gralco/cimarron/README.md

# Cimarron 3D Printer Electronics

## Chipset

Octavo Systems/TI OSD335x

## Other ICs Being Used

Trinamic TMC2130 Stepper Driver

EMMC**G-S100 Embedded MMC

## Operating System

Embedded ARM GNU/Linux Kamikaze

## Bootloader

DAS U-Boot

## Control Software

Potential software to run on Cimarron:

 - [Redeem](https://bitbucket.org/intelligentagent/redeem)
 - [MachineKit](https://github.com/machinekit/machinekit)
 - [Unicorn](https://github.com/fastbot3d/firmware)
 - [Ember-Firmware](https://github.com/spark3dp/ember-firmware)

## Credits

Works that Cimarron is based off of includes:

 - Thing Printer Replicape Rev B3
 - BeagleBone Black Wireless (minus the WL1835 chip)
 - PocketBone
 - BeagleBone Black
 - Tinkerforge Silent Stepper Brick
 - Trinamic TMC-260 Shield

## License

Cimarron is published under [CC-BY-SA 4.0](COPYING.md).
