gralco/cimarron/KiMBo/shapes3D/molex_4pin.fcstd

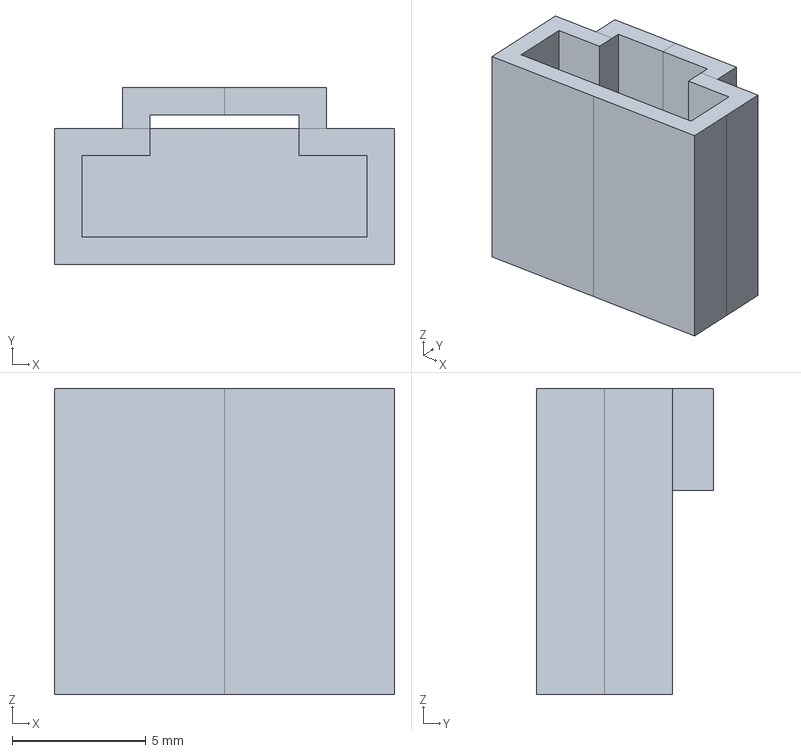
[picture p1: CAD file, 2016-11-03]
KiMBo/shapes3D/molex_4pin.fcstd
12.7 x 6.61 x 11.4 mm
