gralco/cimarron/KiMBo/shapes3D/euro_header_10_horiz.fcstd

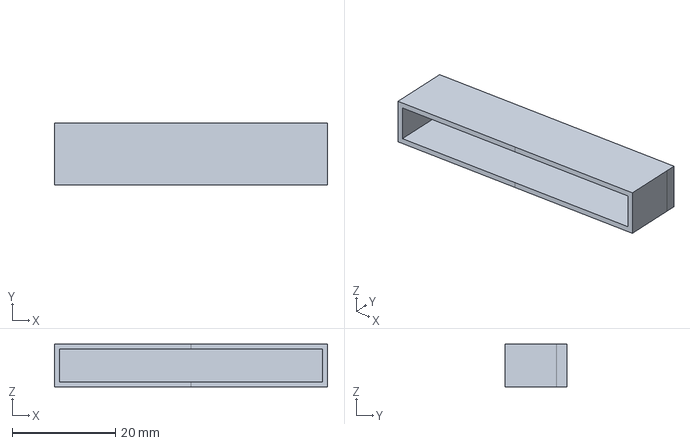
[picture p2: CAD file, 2016-11-03]
KiMBo/shapes3D/euro_header_10_horiz.fcstd
52.8 x 12.0 x 8.30 mm
