gralco/cimarron/KiMBo/shapes3D/switch_vertical.fcstd

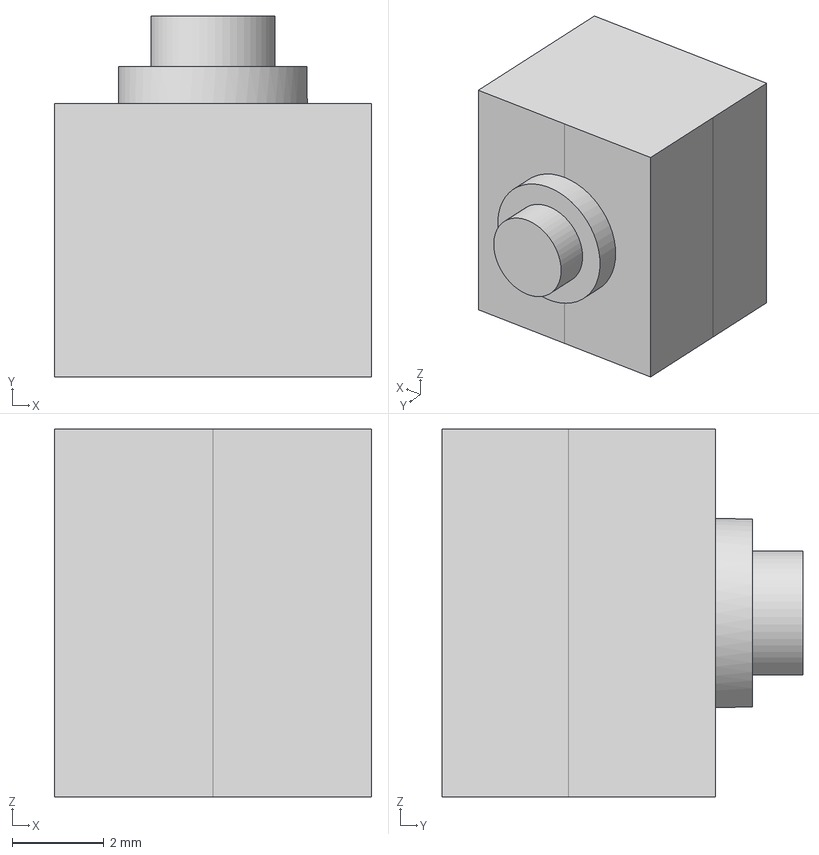
[picture p3: CAD file, 2016-11-03]
KiMBo/shapes3D/switch_vertical.fcstd
6.90 x 7.85 x 8.00 mm
