gralco/cimarron/KiMBo/shapes3D/molex_2pin.fcstd

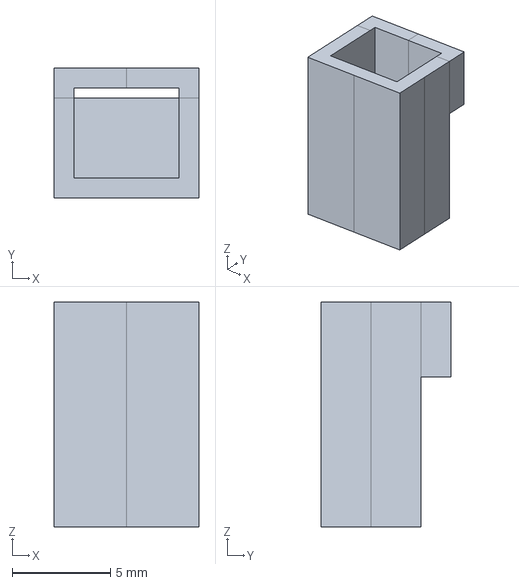
[picture p4: CAD file, 2016-11-03]
KiMBo/shapes3D/molex_2pin.fcstd
7.37 x 6.61 x 11.4 mm
