gralco/cimarron/KiMBo/shapes3D/VLP8040.fcstd

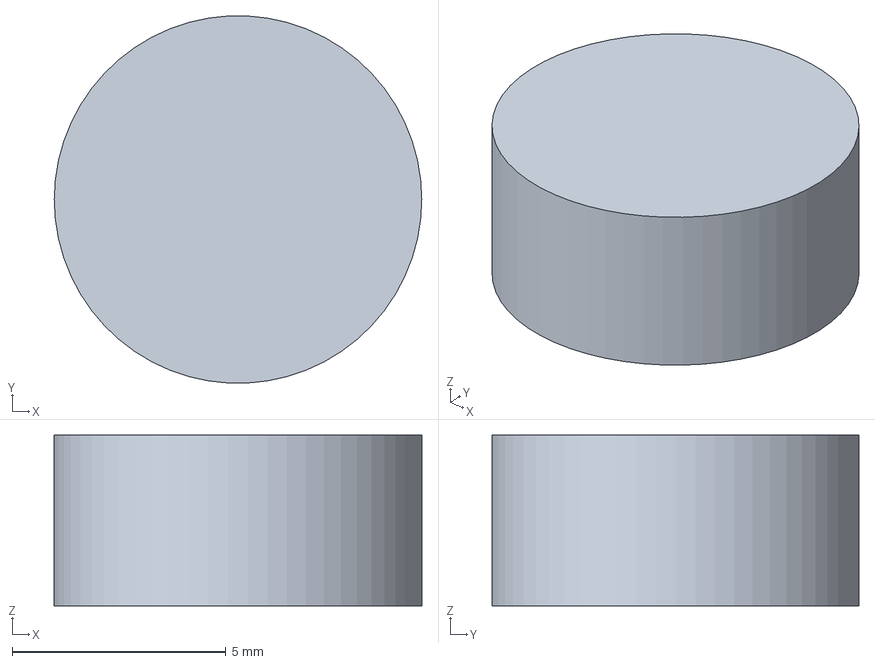
[picture p5: CAD file, 2016-11-03]
KiMBo/shapes3D/VLP8040.fcstd
8.60 x 8.59 x 4.00 mm
