gralco/cimarron/KiMBo/shapes3D/SMD_1806.fcstd

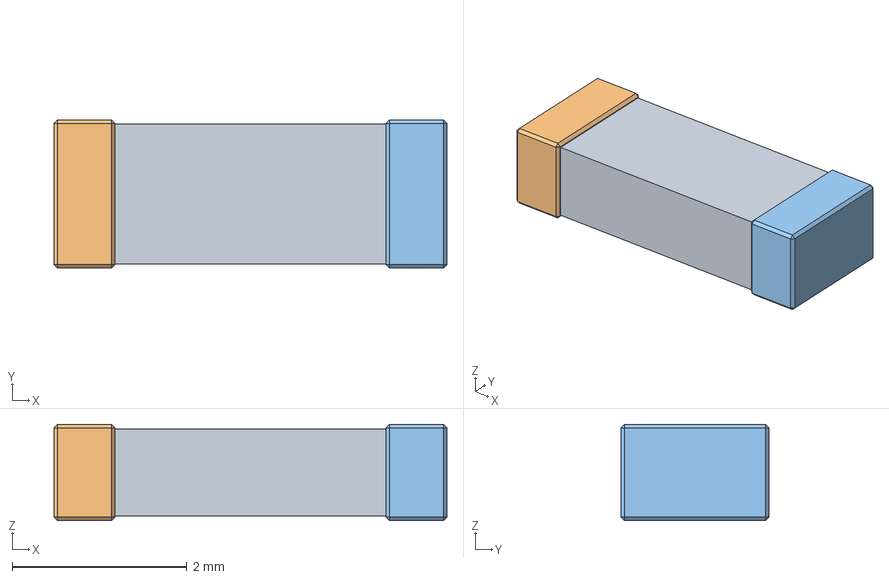
[picture p6: CAD file, 2016-11-03]
KiMBo/shapes3D/SMD_1806.fcstd
4.50 x 1.70 x 1.10 mm
Chamfer (Mirror #1)
