gralco/cimarron/KiMBo/shapes3D/fuse_holder.fcstd

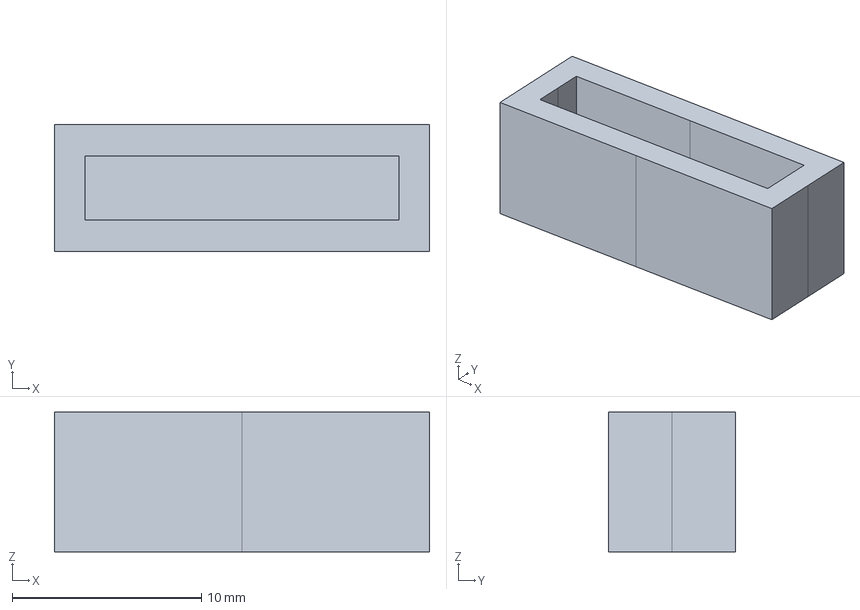
[picture p7: CAD file, 2016-11-03]
KiMBo/shapes3D/fuse_holder.fcstd
19.8 x 6.73 x 7.37 mm
