gralco/cimarron/KiMBo/shapes3D/V10P10.fcstd

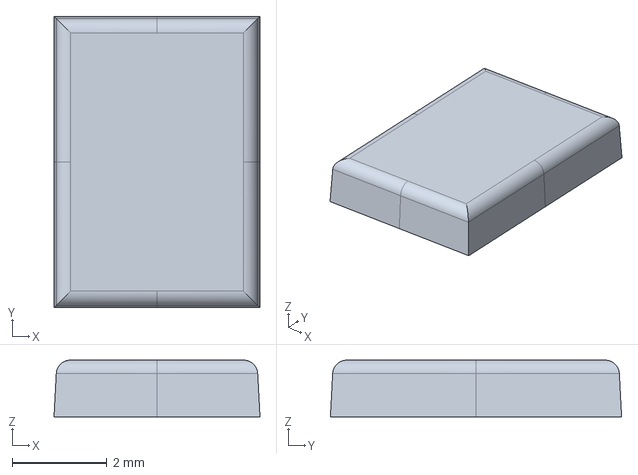
[picture p8: CAD file, 2016-11-03]
KiMBo/shapes3D/V10P10.fcstd
4.35 x 6.15 x 1.20 mm
