gralco/cimarron/KiMBo/shapes3D/molex_3pin.fcstd

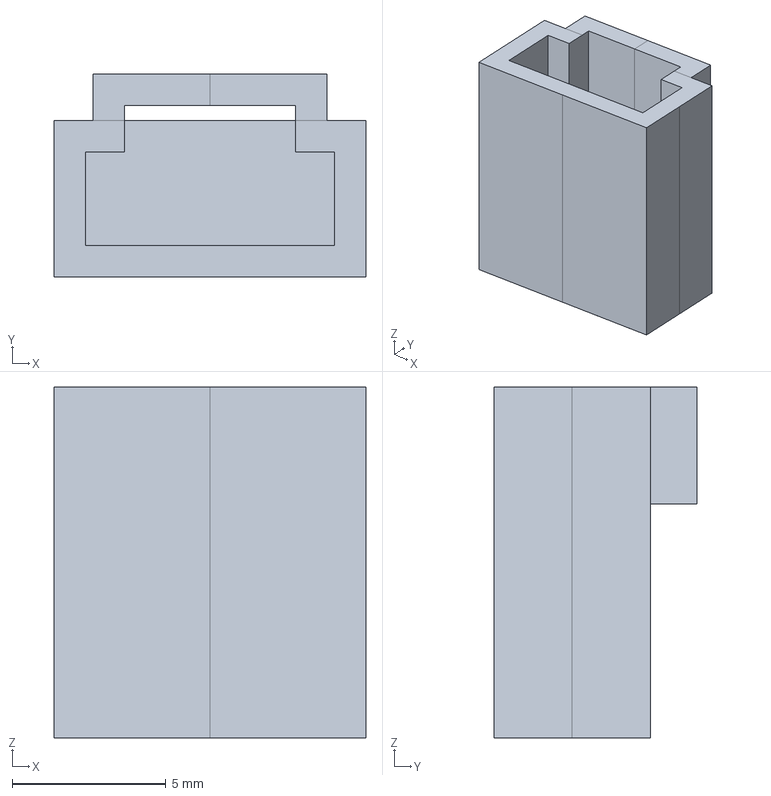
[picture p9: CAD file, 2016-11-03]
KiMBo/shapes3D/molex_3pin.fcstd
10.2 x 6.61 x 11.4 mm
