gralco/cimarron/KiMBo/shapes3D/euro_header_4.fcstd

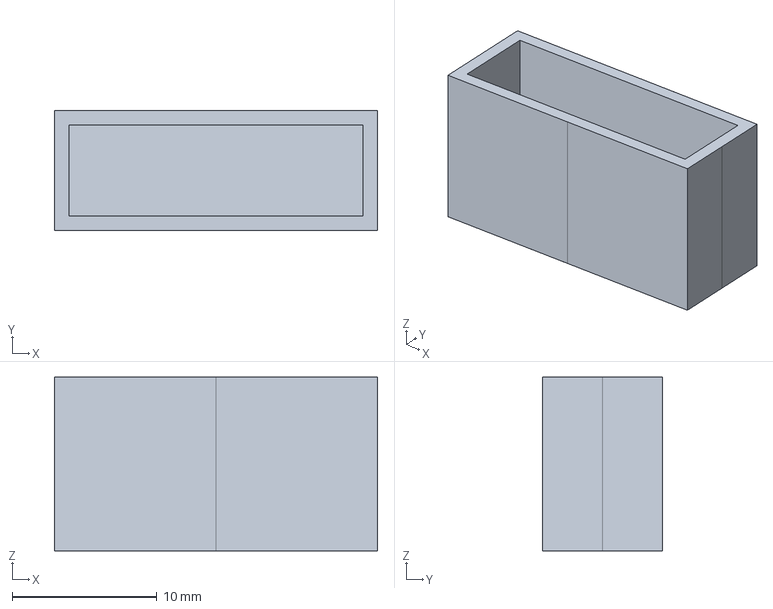
[picture p10: CAD file, 2016-11-03]
KiMBo/shapes3D/euro_header_4.fcstd
22.3 x 8.30 x 12.0 mm
