gralco/cimarron/KiMBo/shapes3D/POWERDI-123.fcstd

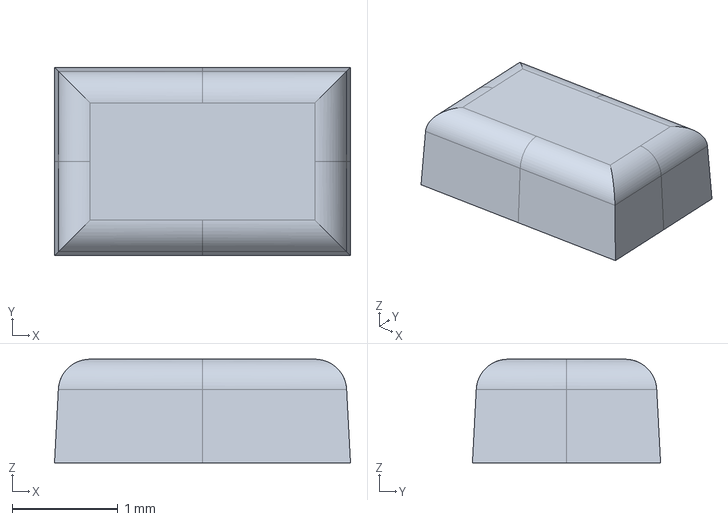
[picture p11: CAD file, 2016-11-03]
KiMBo/shapes3D/POWERDI-123.fcstd
2.80 x 1.78 x 0.98 mm
