gralco/cimarron/KiMBo/shapes3D/euro_header_6.fcstd

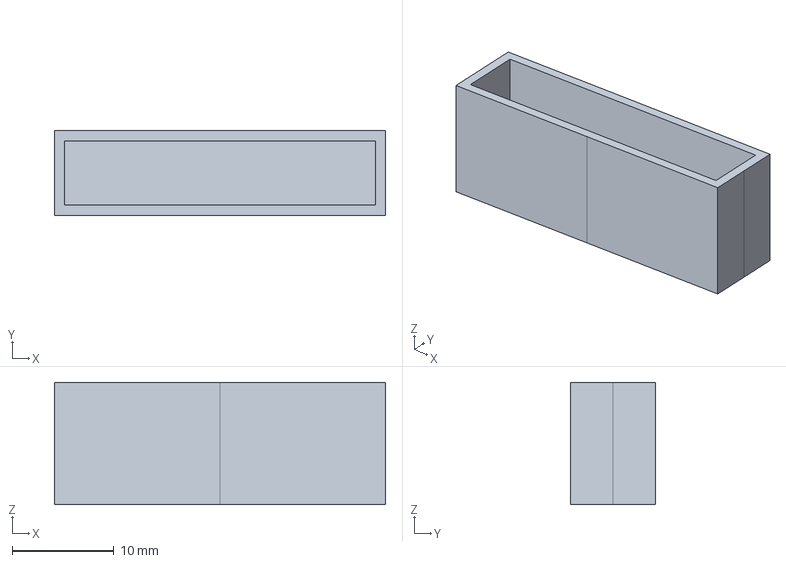
[picture p12: CAD file, 2016-11-03]
KiMBo/shapes3D/euro_header_6.fcstd
32.5 x 8.30 x 12.0 mm
