gralco/cimarron/(list of files, cad)

Other CAD files:
KiMBo/shapes3D/euro_header_10.fcstd
KiMBo/shapes3D/molex_2pin.stl
