gralco/cimarron/KiMBo/KiMBo.pdf

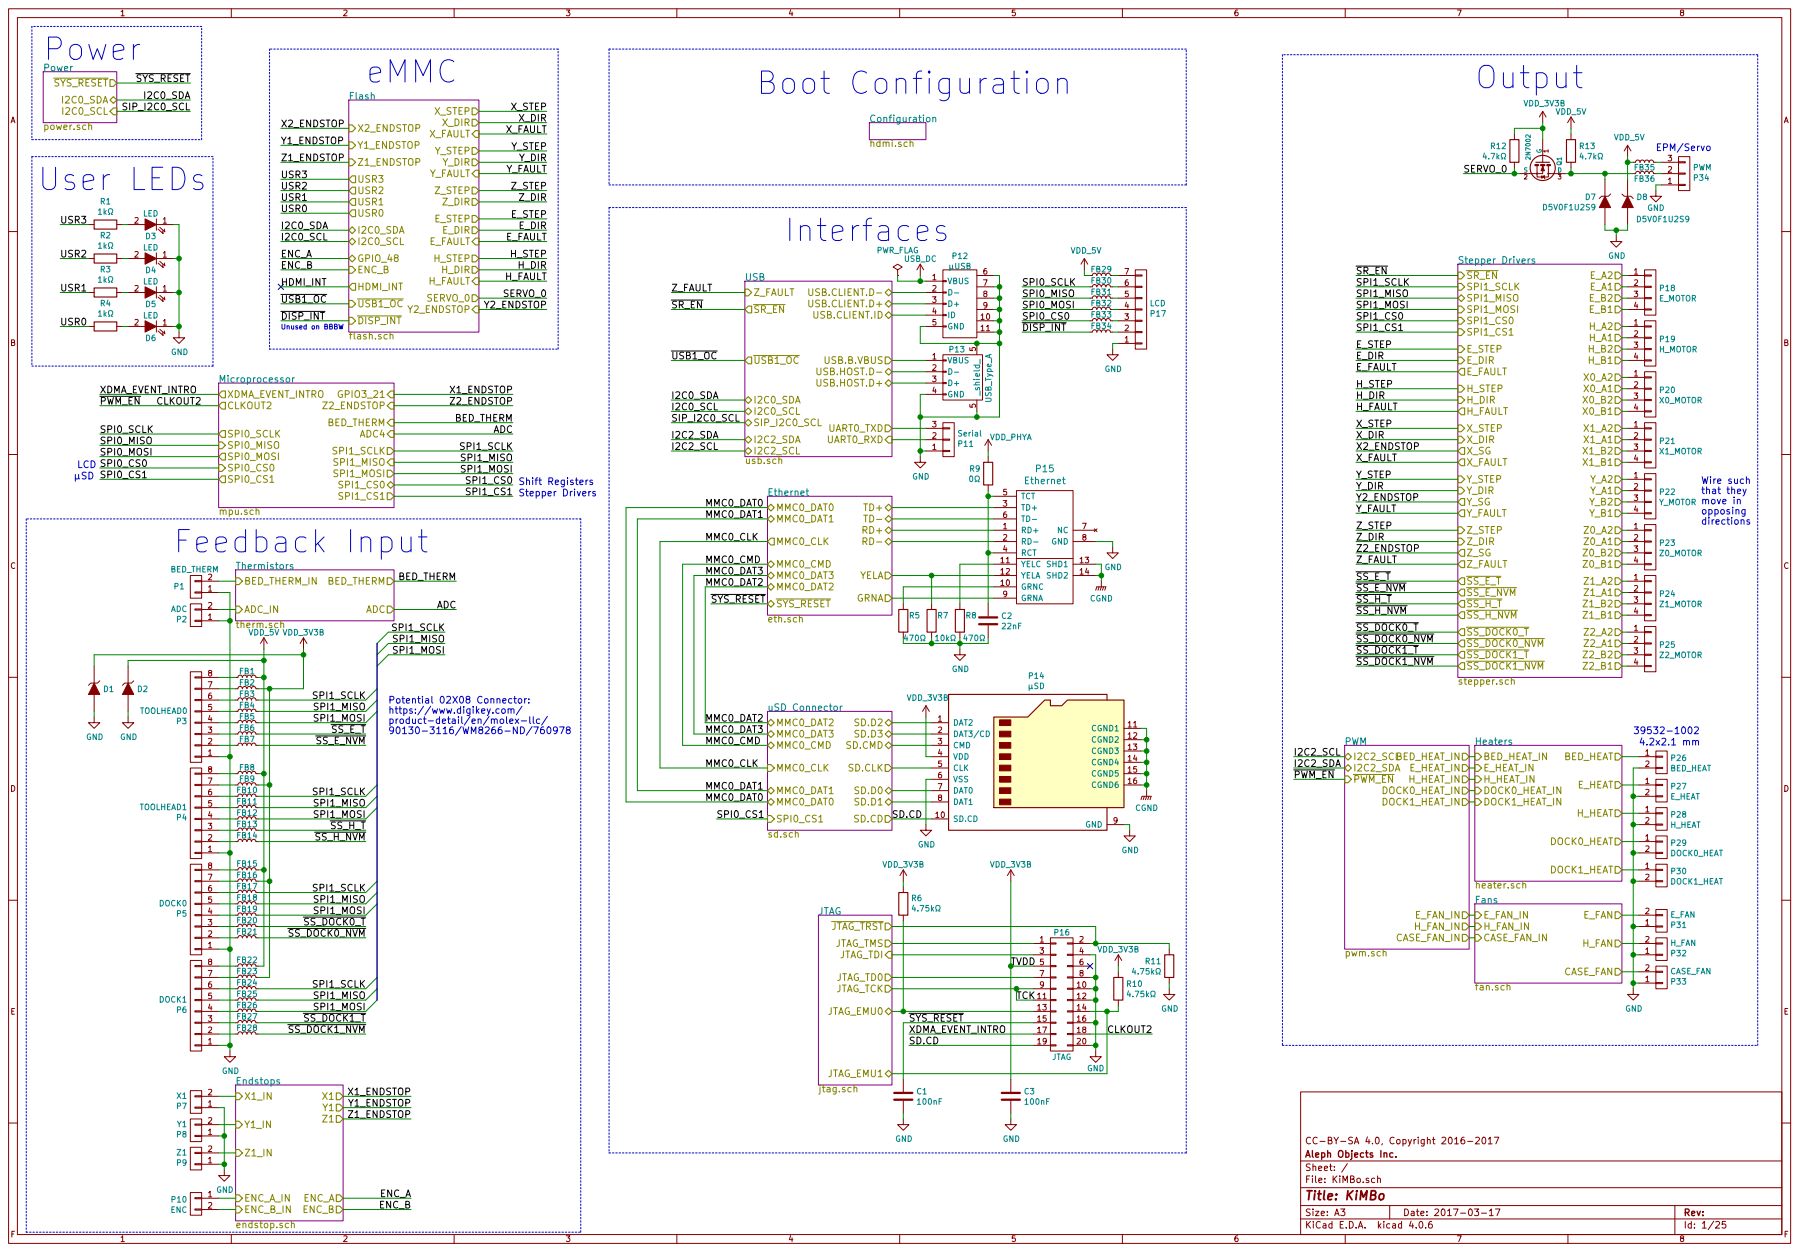
[picture p13: page 1]

hdmi.sch Boot Configuration

that they move in
opposing

Potential 02X08 Connector:
https://www.digikey.com/
product-detail/en/molex-llc/

CC-BY-SA 4.0, Copyright 2016-2017
File: KiMBo.sch Sheet: / Aleph Objects Inc.

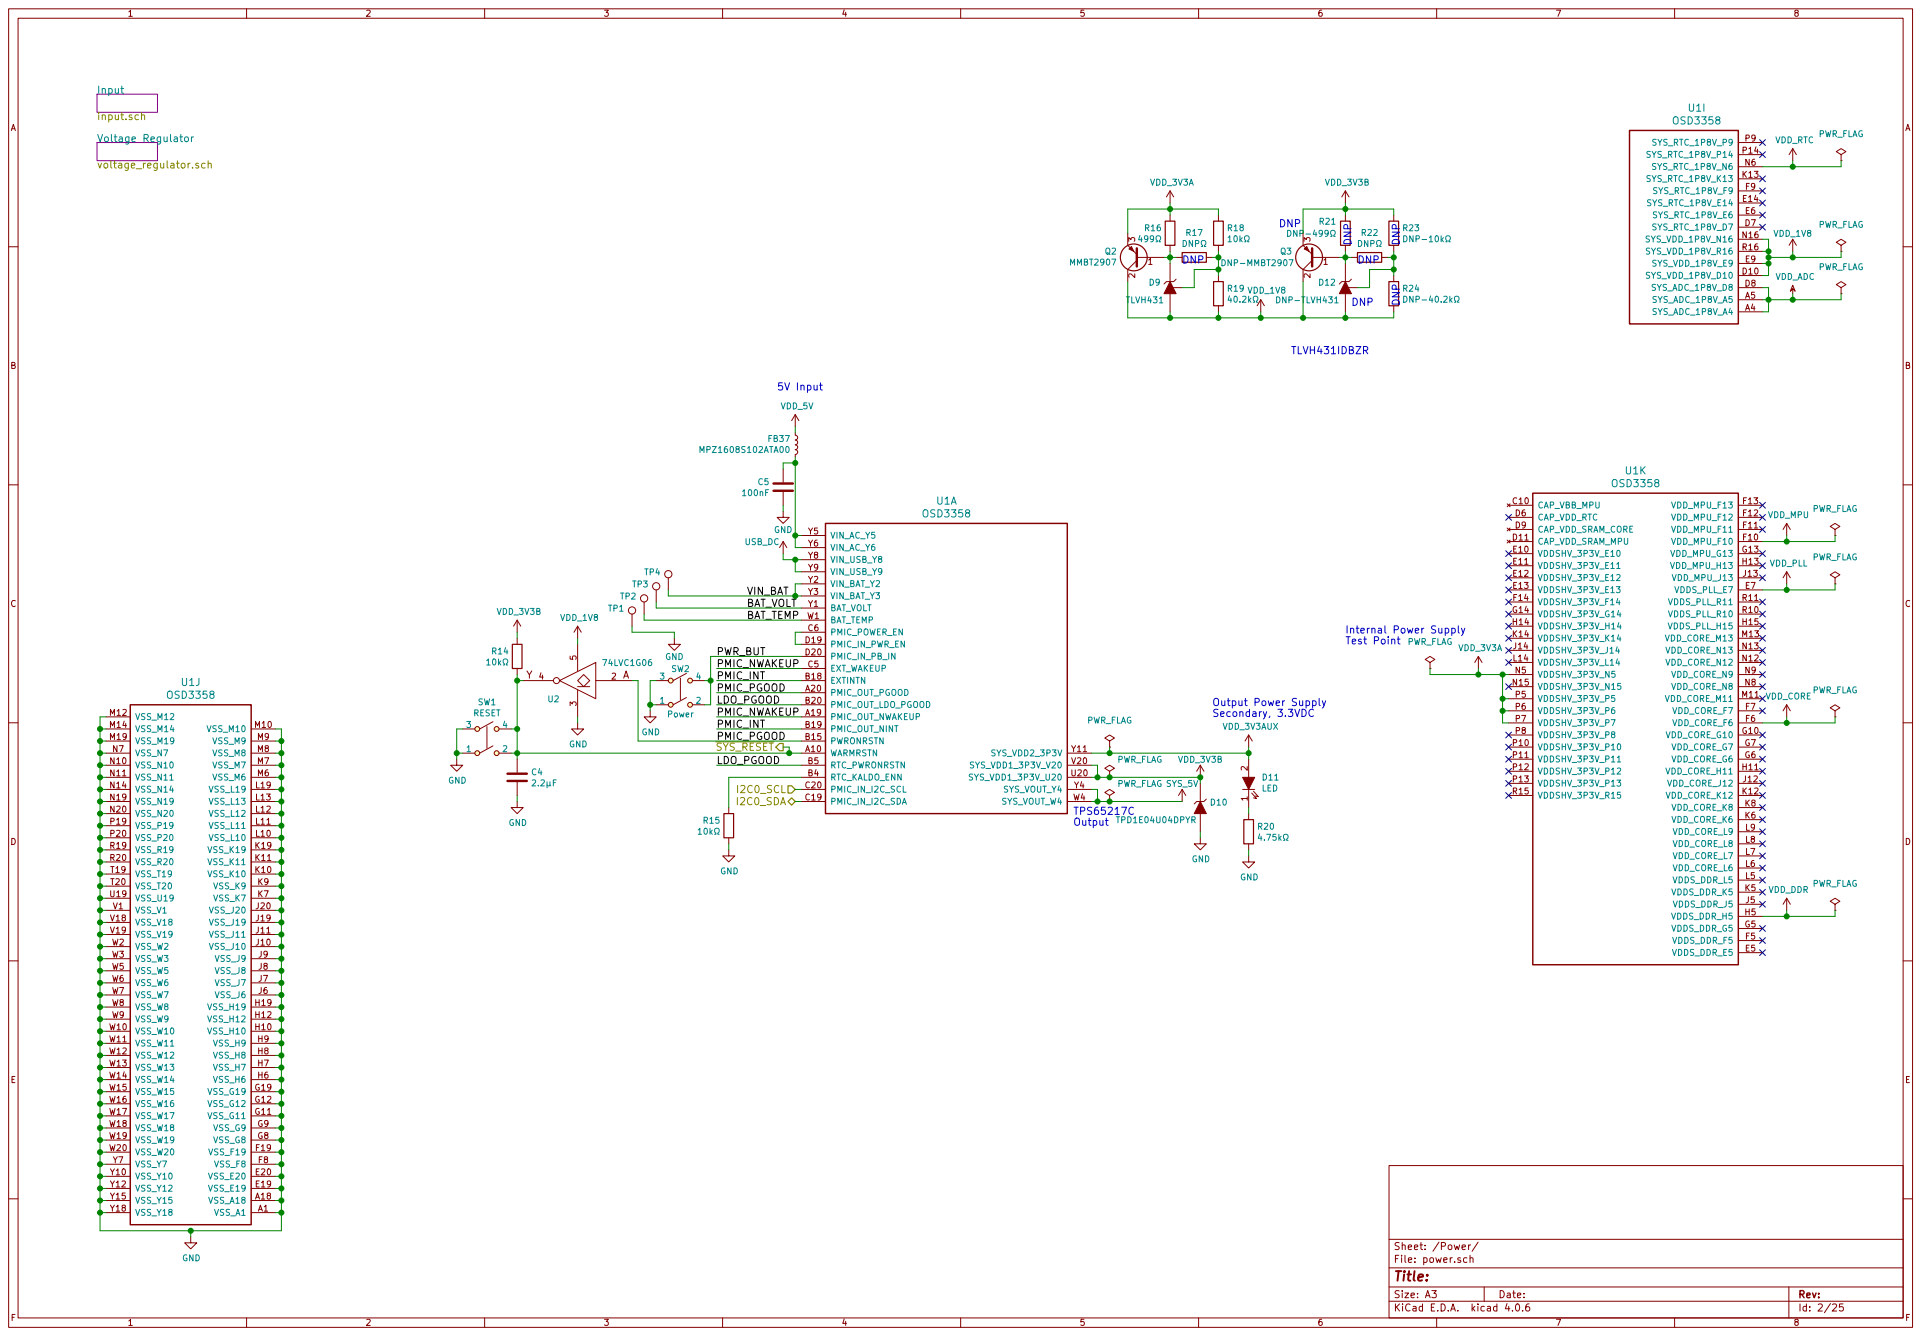
[picture p14: page 2]

2 3 Q3 DNP-MMBT2907 R22 DNP R23DNP-10k R24DNP-40.2k D9 TLVH431 D12 DNP-TLVH431 5V Input

Internal Power Supply Test Point Output Power Supply

File: power.sch Sheet: /Power/

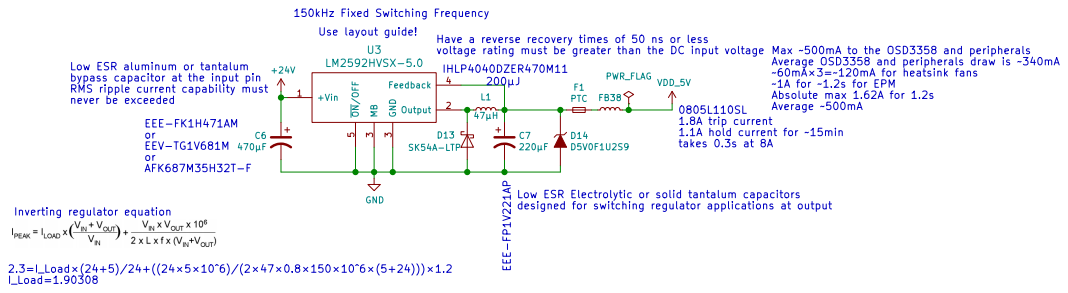
[picture p15: page 3]

150kHz Fixed Switching Frequency GND

Have a reverse recovery times of 50 ns or less
voltage rating must be greater than the DC input voltage

Low ESR aluminum or tantalum
bypass capacitor at the input pin
RMS ripple current capability must never be exceeded

Average OSD3358 and peripherals draw is 340mA
60mA×3=120mA for heatsink fans 1A for 1.2s for EPM
Absolute max 1.62A for 1.2s Average 500mA

1.8A trip current 1.1A hold current for 15min
takes 0.3s at 8A

Low ESR Electrolytic or solid tantalum capacitors
designed for switching regulator applications at output

Sheet: /Power/Voltage Regulator/
File: voltage_regulator.sch
Id: 3/25 Title:

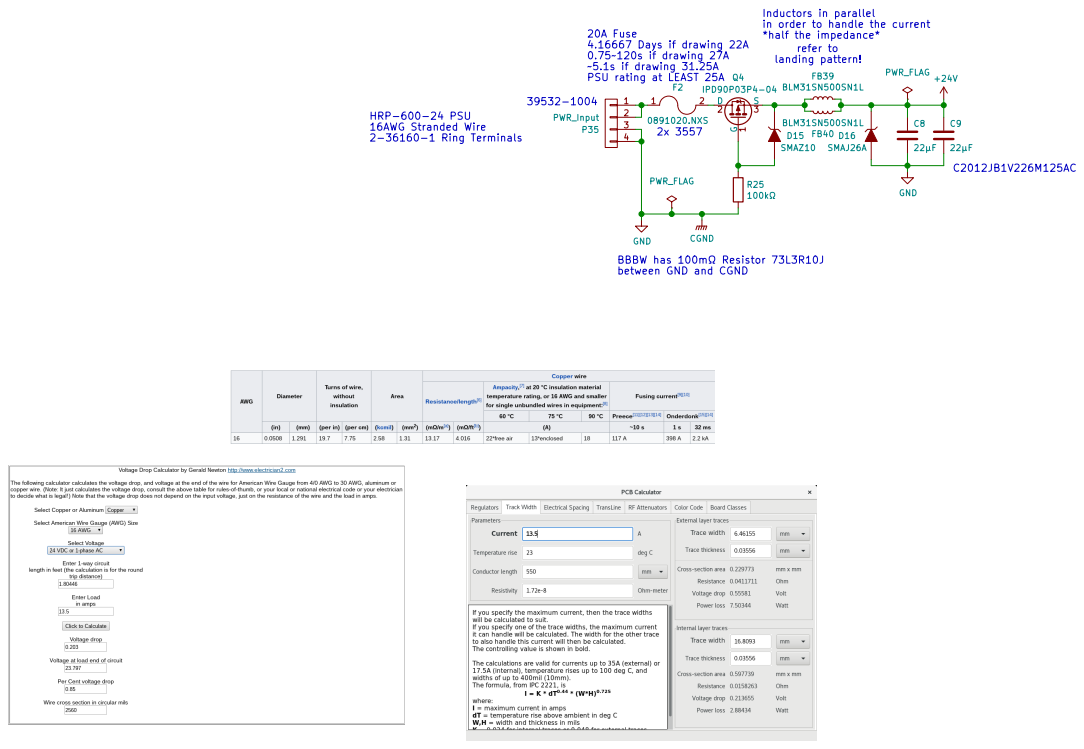
[picture p16: page 4]

4.16667 Days if drawing 22A
0.75120s if drawing 27A
5.1s if drawing 31.25A
PSU rating at LEAST 25A

BBBW has 100m Resistor 73L3R10J between GND and CGND

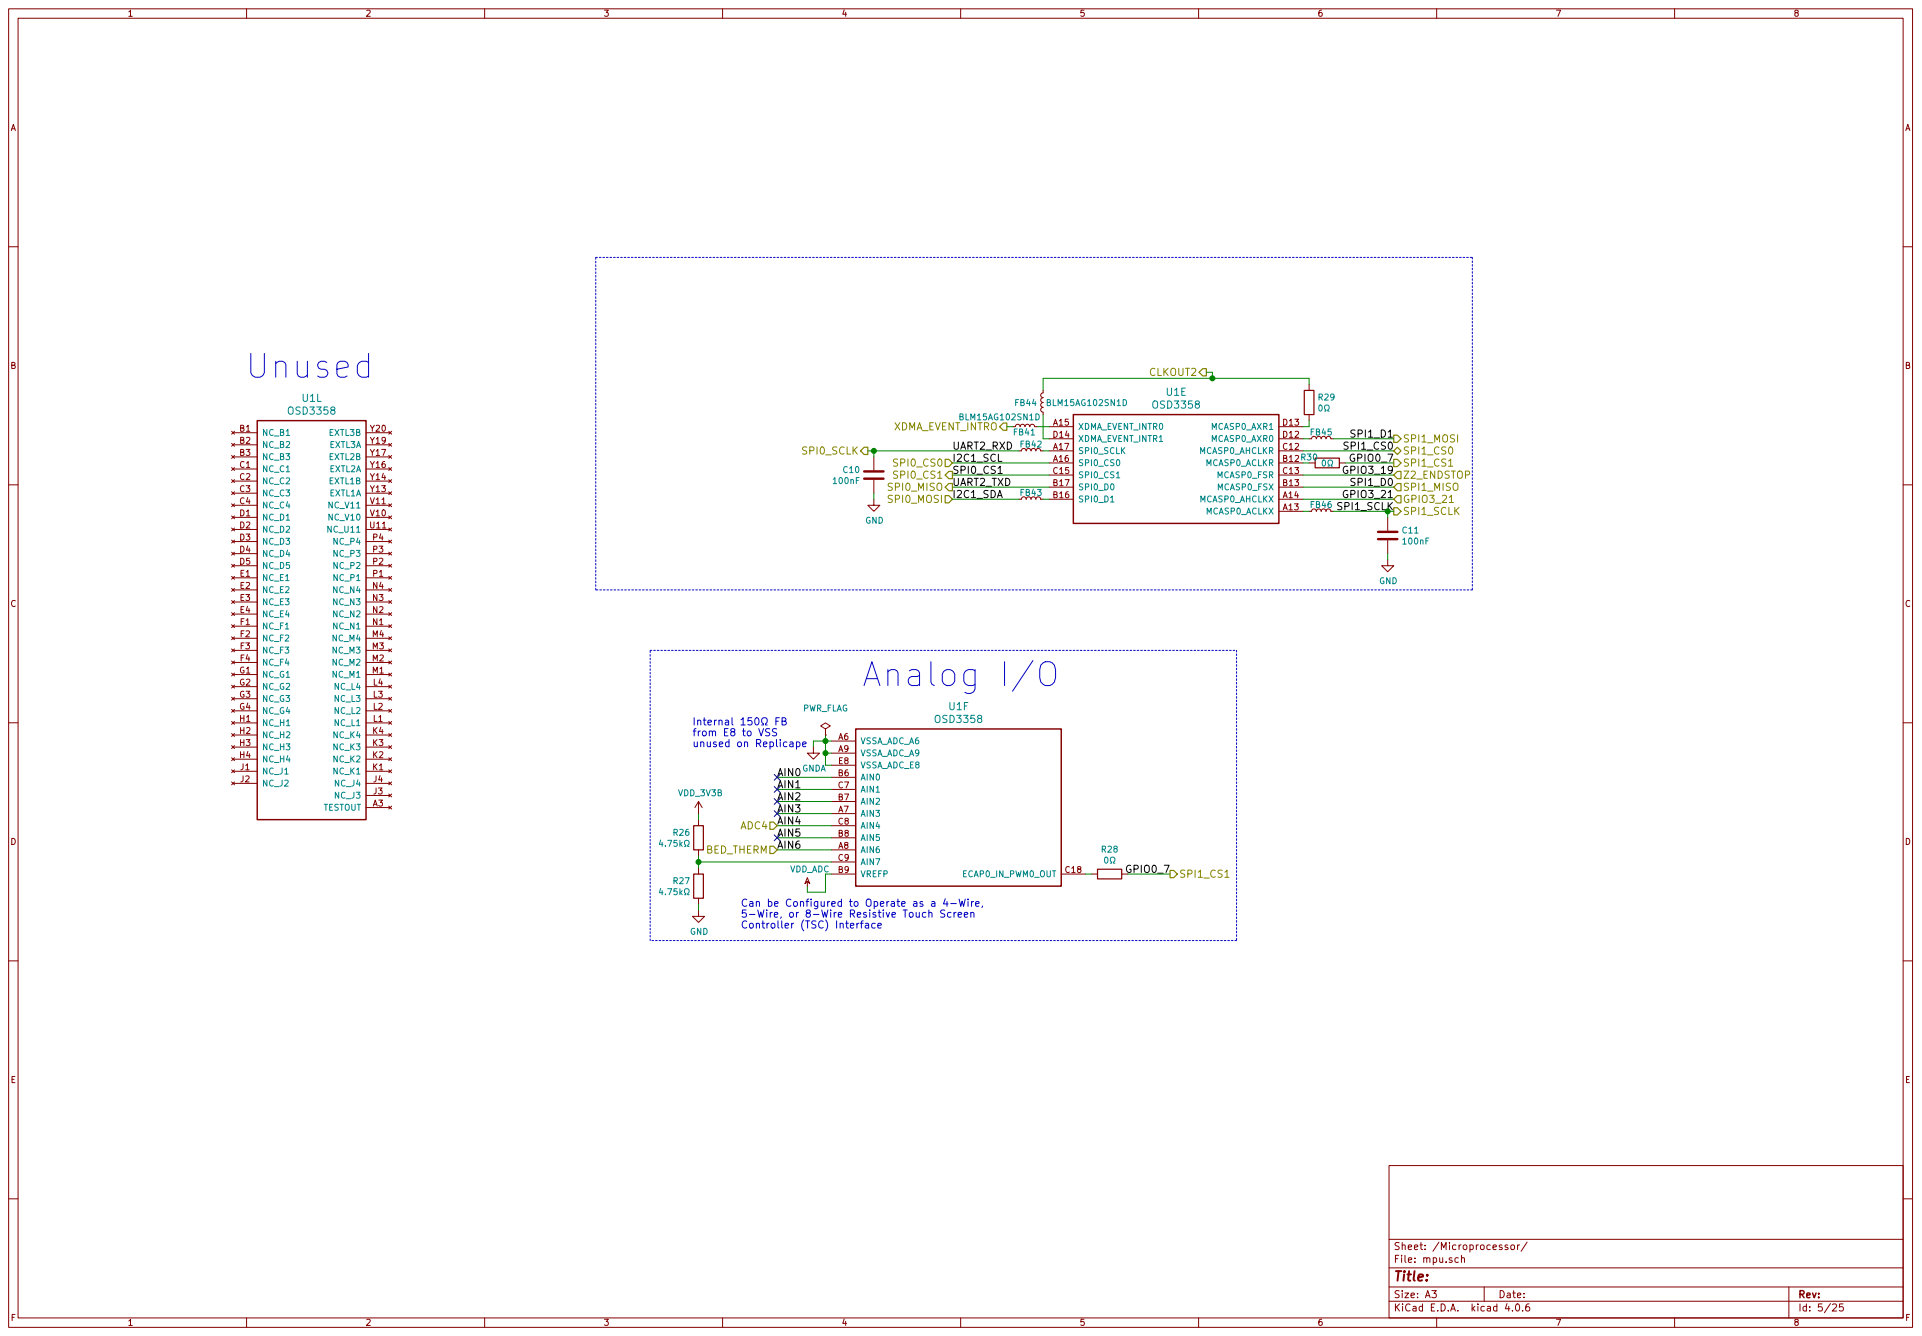
[picture p17: page 5]

PWR_FLAG Can be Configured to Operate as a 4-Wire,

5-Wire, or 8-Wire Resistive Touch Screen
Controller (TSC) Interface

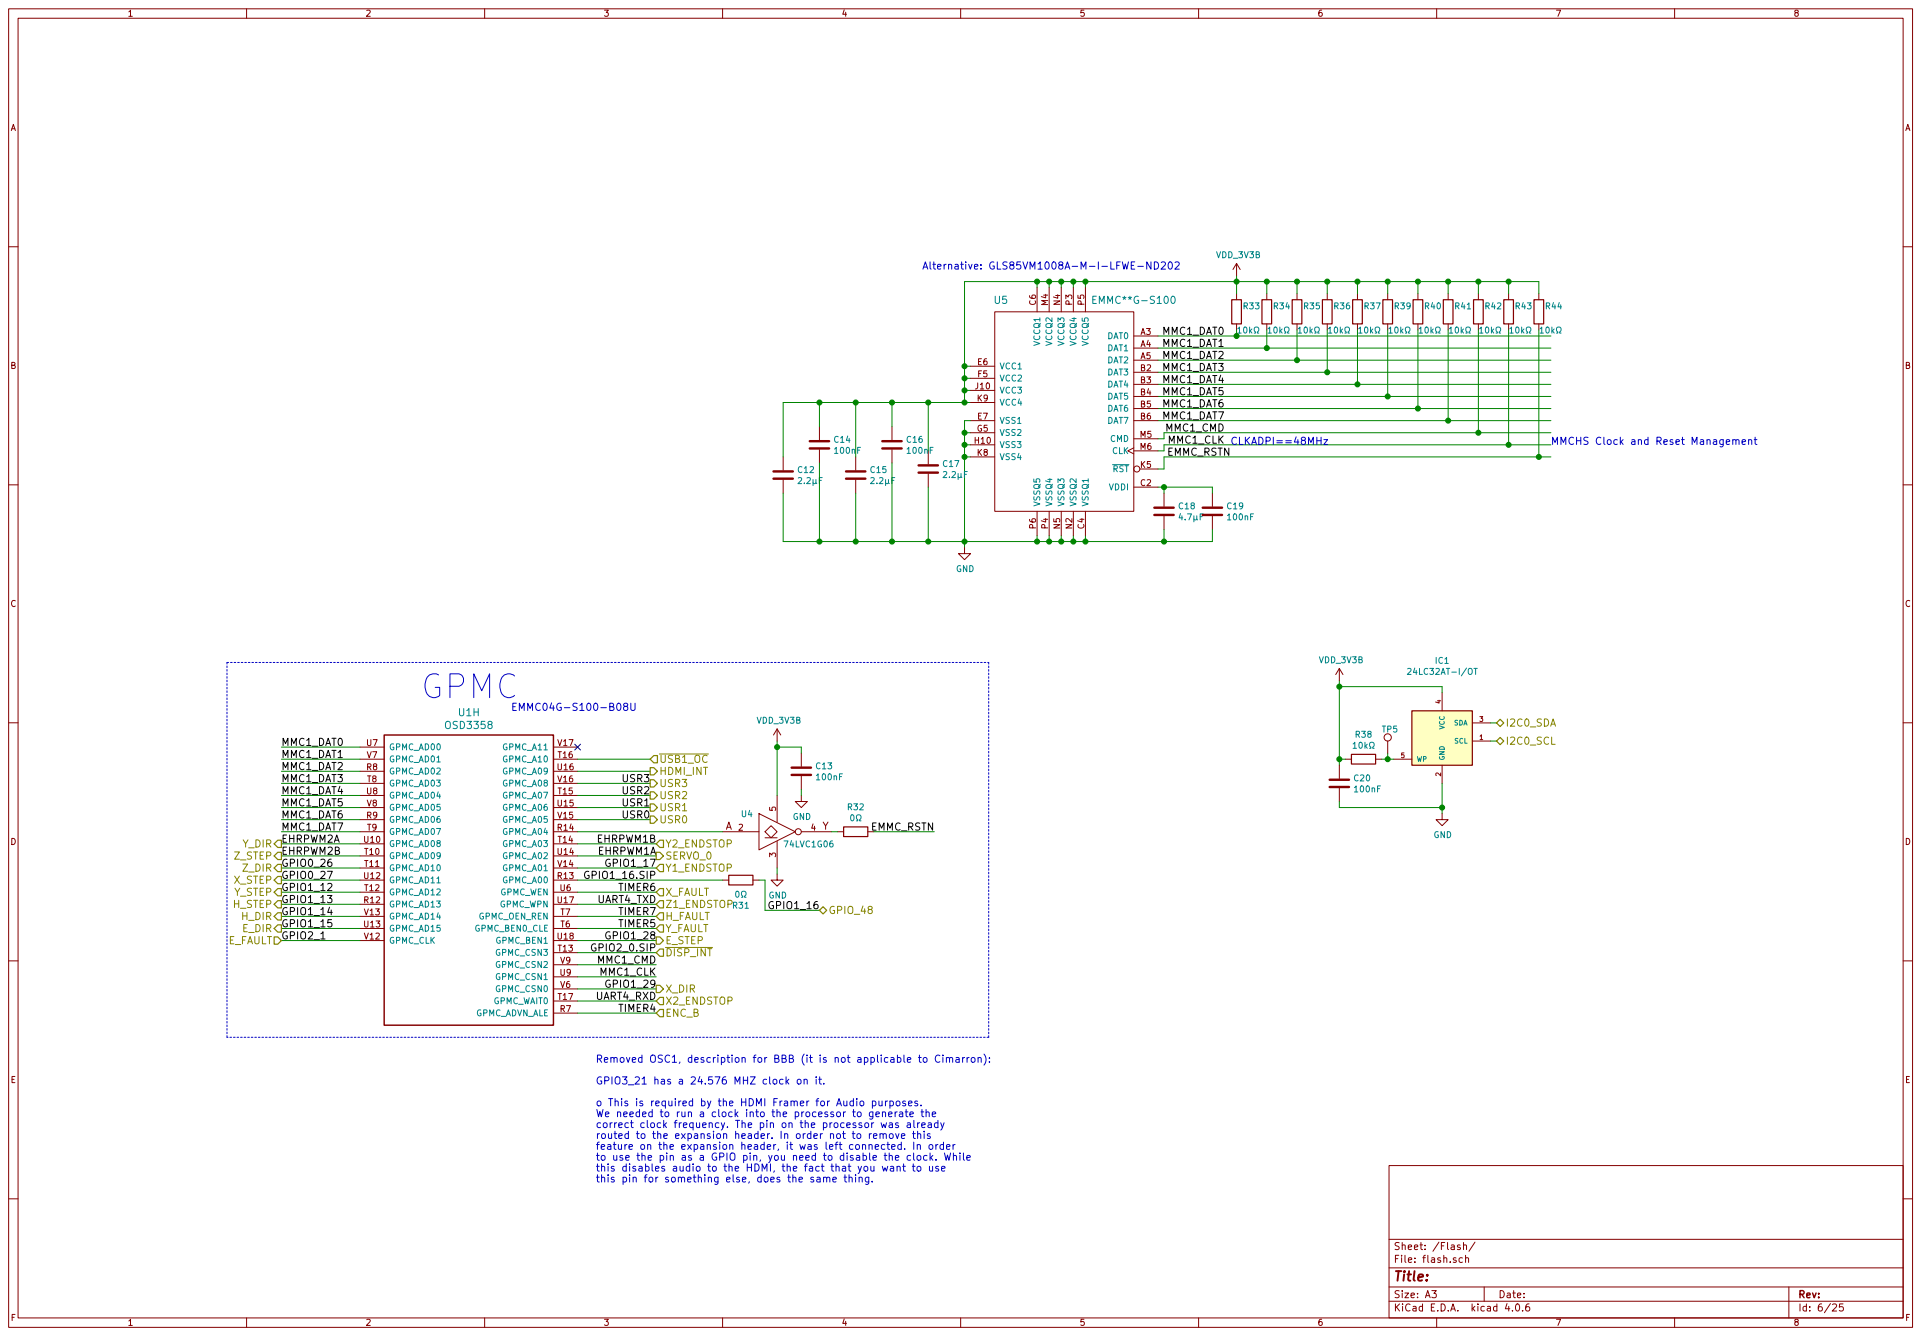
[picture p18: page 6]

MMC1_DAT1
MMC1_DAT2
MMC1_DAT3
MMC1_DAT4
MMC1_DAT5
MMC1_DAT6
MMC1_DAT7
MMC1_CMD

MMCHS Clock and Reset Management

Removed OSC1, description for BBB (it is not applicable to Cimarron):
GPIO3_21 has a 24.576 MHZ clock on it.
o This is required by the HDMI Framer for Audio purposes.
We needed to run a clock into the processor to generate the
correct clock frequency. The pin on the processor was already
routed to the expansion header. In order not to remove this
feature on the expansion header, it was left connected. In order
to use the pin as a GPIO pin, you need to disable the clock. While
this disables audio to the HDMI, the fact that you want to use
this pin for something else, does the same thing.

Id: 6/25 Title: File: flash.sch Sheet: /Flash/

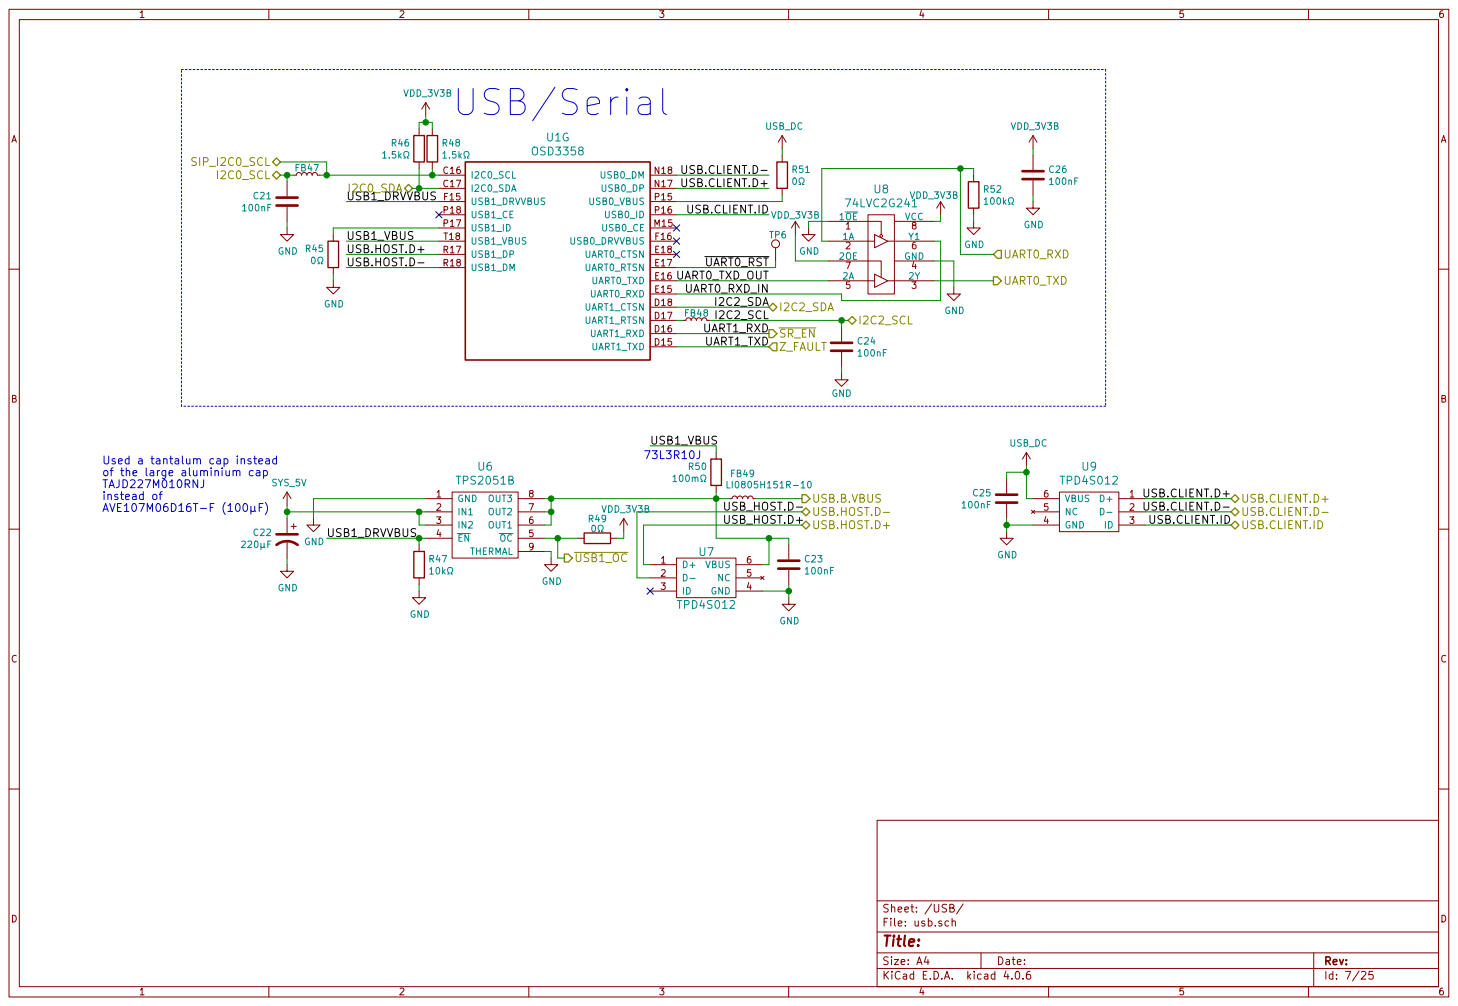
[picture p19: page 7]

VDD_3V3B Used a tantalum cap instead

of the large aluminium cap TAJD227M010RNJ

Id: 7/25 Title: File: usb.sch Sheet: /USB/

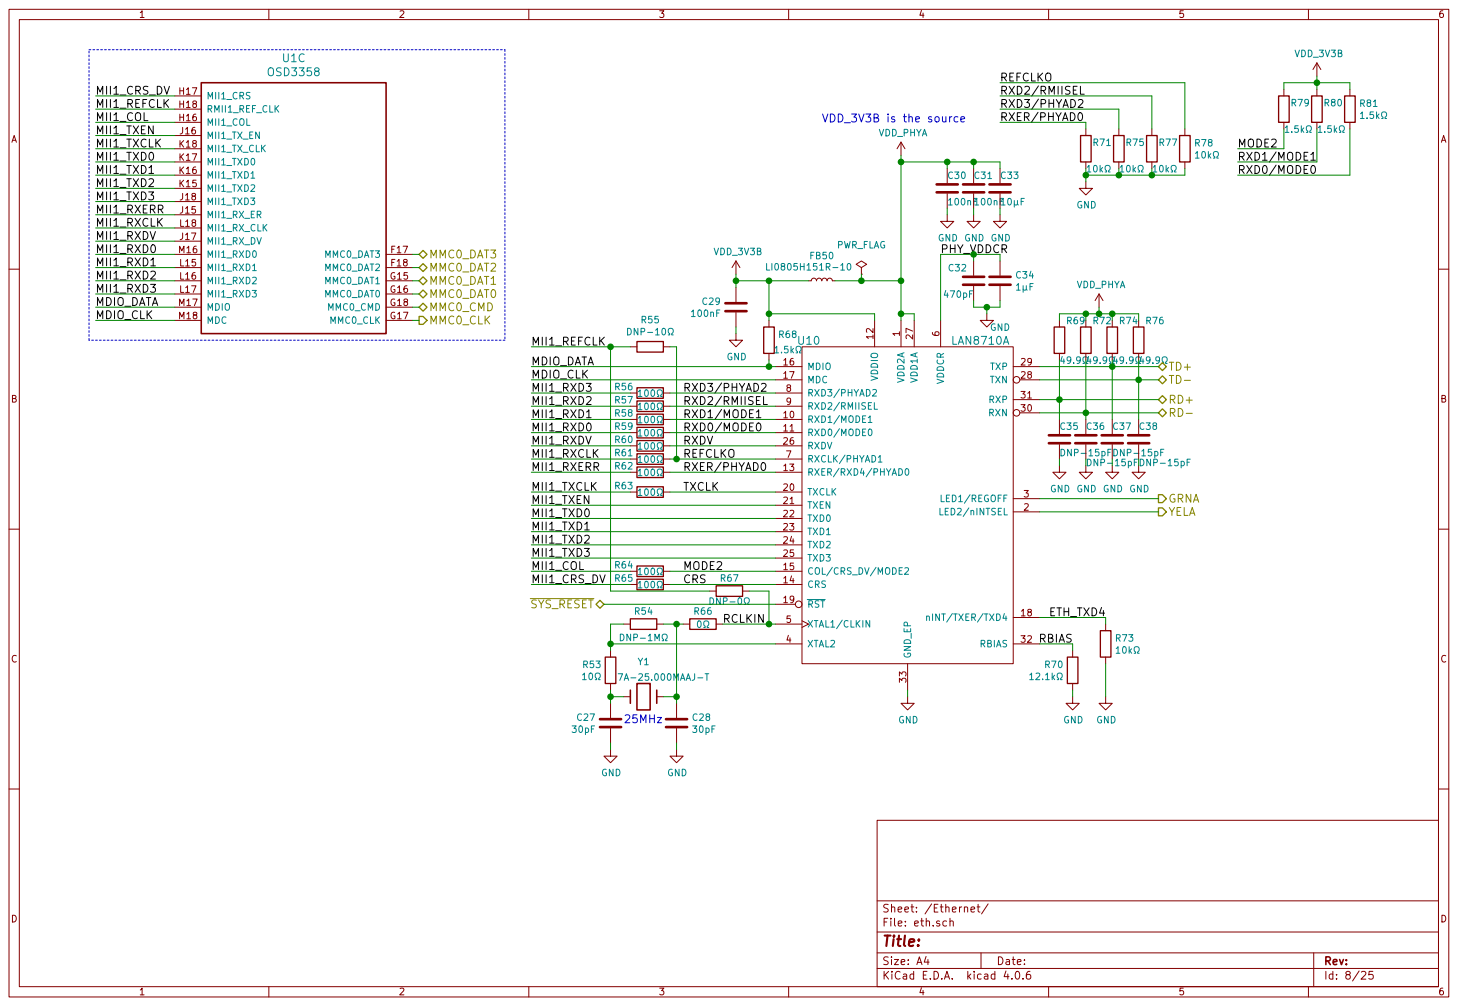
[picture p20: page 8]

6 RXCLK/PHYAD1 7 RXD3/PHYAD2 8 RXD2/RMIISEL 9 RXD1/MODE1 10 TXCLK 20 RXN 30 RXD0/MODE0 11 TXEN 21 RXP 31 VDDIO 12 TXD0 22 RBIAS 32 RXER/RXD4/PHYAD0 13 TXD1 23 GND_EP 33 CRS 14 TXD2 24 COL/CRS_DV/MODE2 15 TXD3 25 MDIO 16 RXDV 26 MDC 17 VDD1A 27
ETH_TXD4 R68

Id: 8/25 Title: File: eth.sch Sheet: /Ethernet/ VDD2A

49.9 C35 DNP-15pF C36 DNP-15pF C37 DNP-15pF C38 DNP-15pF GND GND GND GND

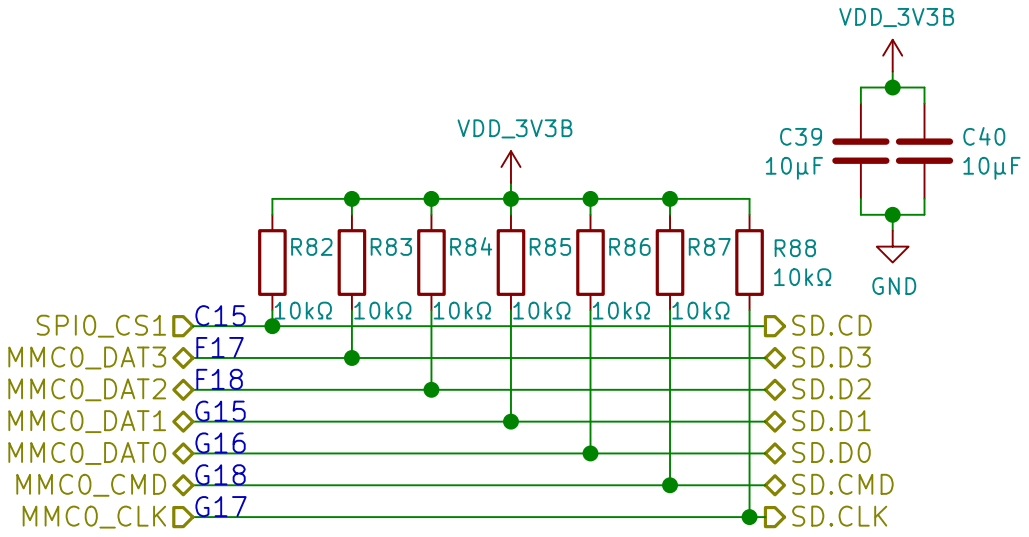
[picture p21: page 9]

Id: 9/25 Title: File: sd.sch Sheet: /uSD Connector/

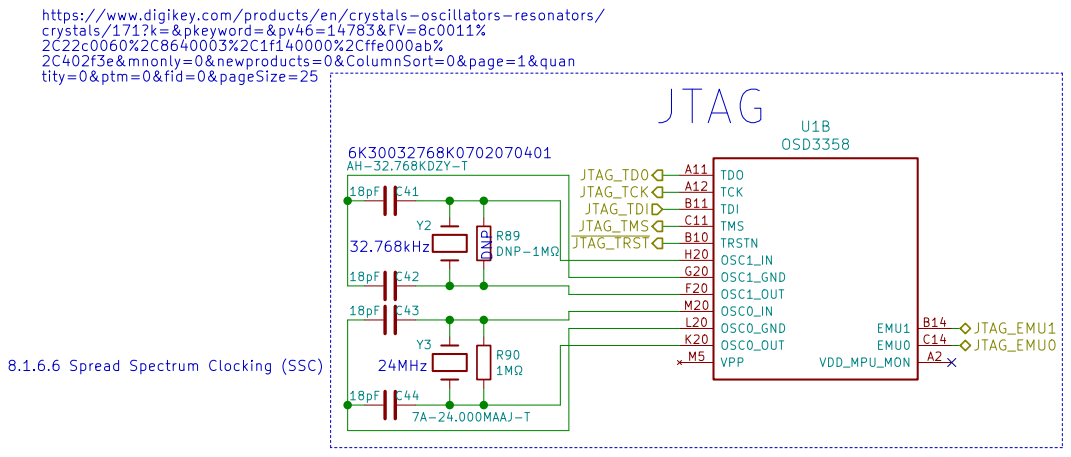
[picture p22: page 10]

JTAG_EMU0 DNP 32.768kHz 24MHz https://www.digikey.com/products/en/crystals-oscillators-resonators/
crystals/171?k=&pkeyword=&pv46=14783&FV=8c0011%
2C22c0060%2C8640003%2C1f140000%2Cffe000ab%
2C402f3e&mnonly=0&newproducts=0&ColumnSort=0&page=1&quan
tity=0&ptm=0&fid=0&pageSize=25

8.1.6.6 Spread Spectrum Clocking (SSC)

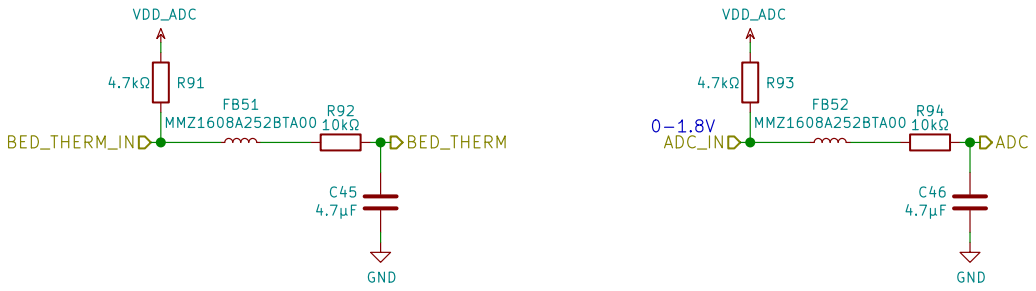
[picture p23: page 11]

Id: 11/25 Title: File: therm.sch Sheet: /Thermistors/

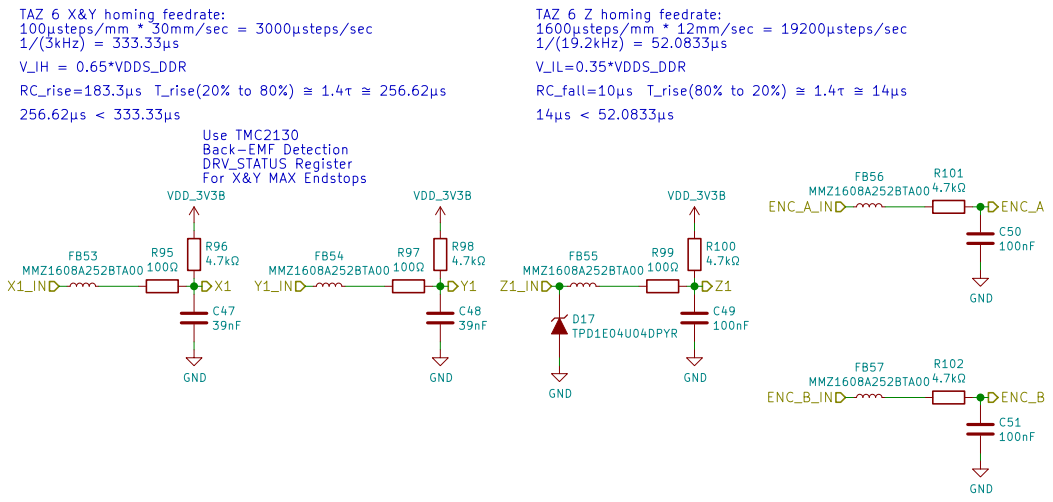
[picture p24: page 12]

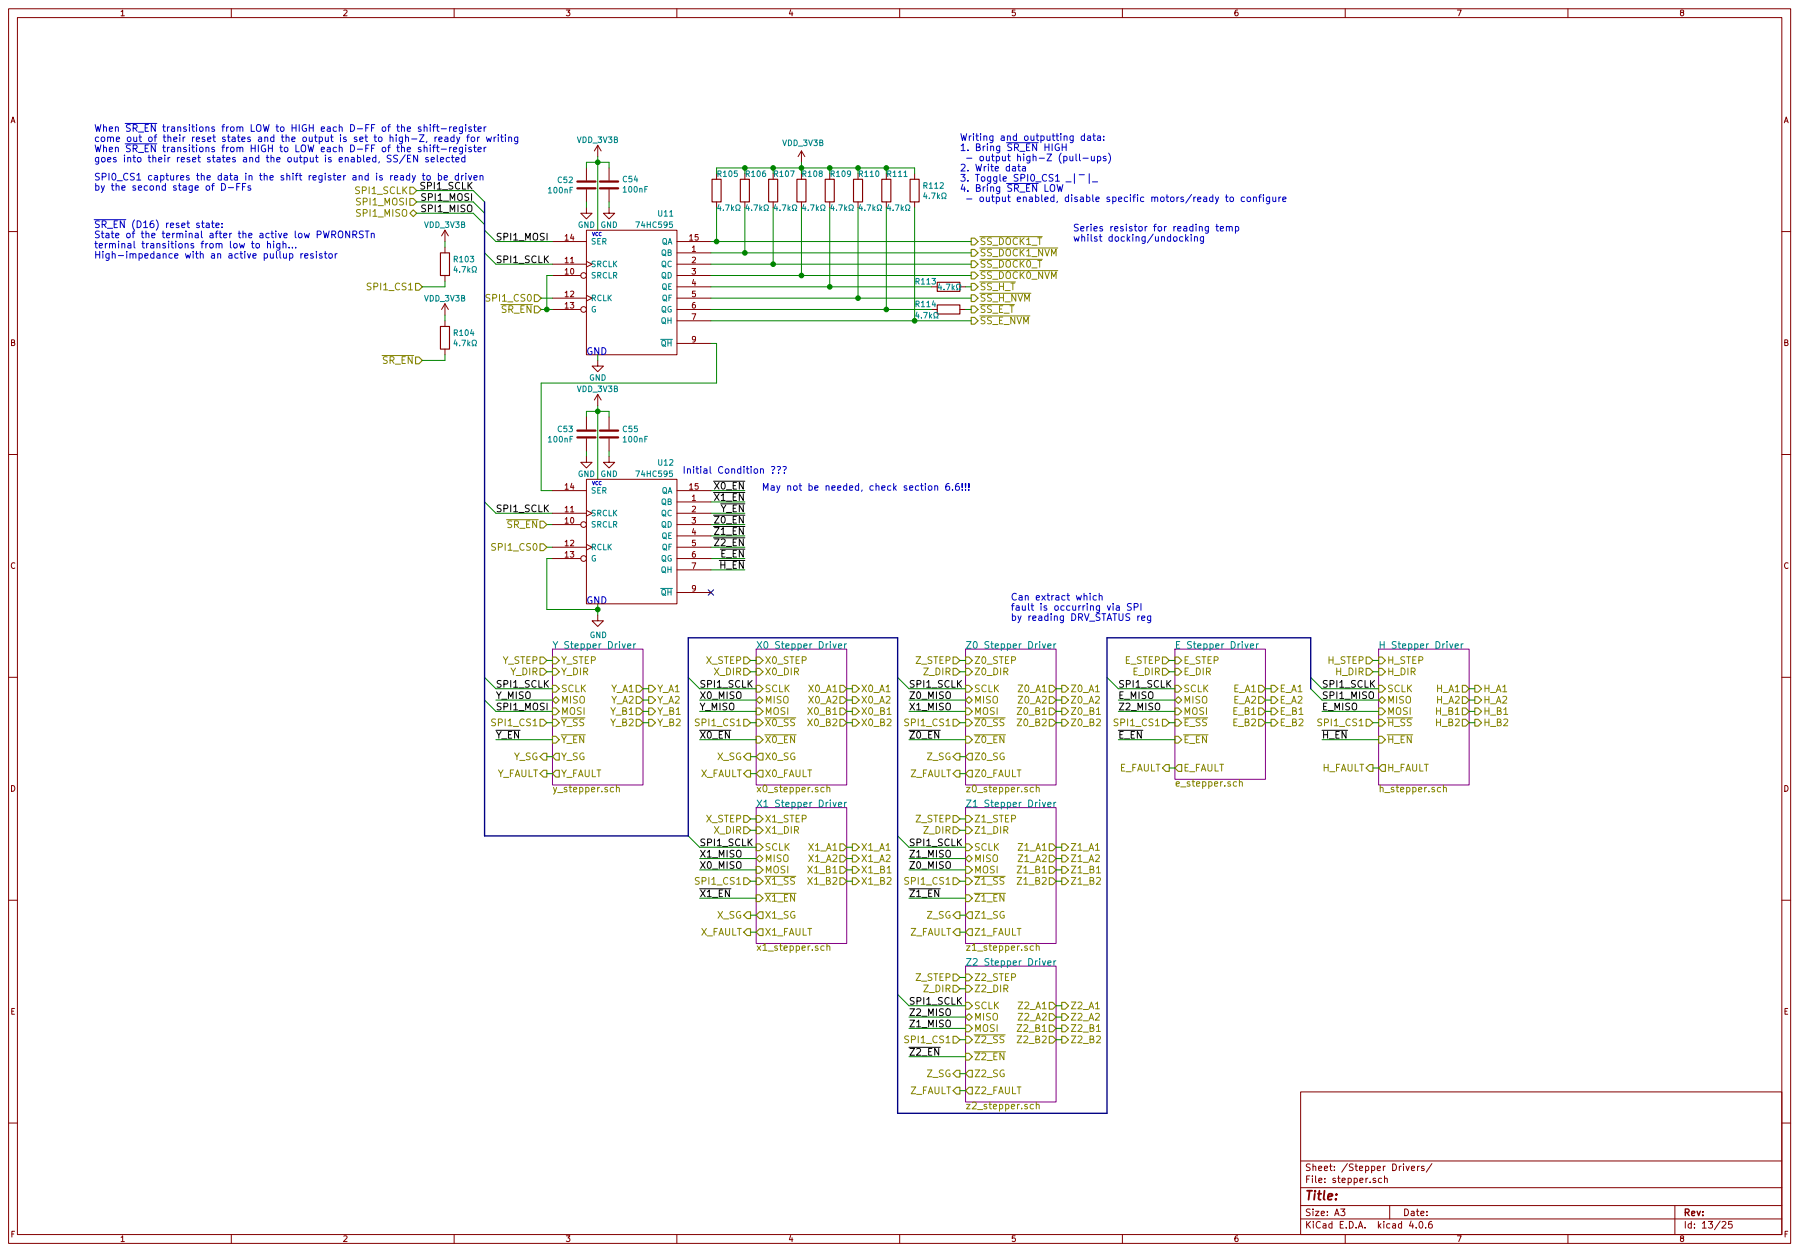
[picture p25: page 13]

When SR_EN transitions from LOW to HIGH each D-FF of the shift-register
come out of their reset states and the output is set to high-Z, ready for writing
When SR_EN transitions from HIGH to LOW each D-FF of the shift-register
goes into their reset states and the output is enabled, SS/EN selected
SPI0_CS1 captures the data in the shift register and is ready to be driven
by the second stage of D-FFs

Writing and outputting data:
1. Bring SR_EN HIGH
- output high-Z (pull-ups) 2. Write data
3. Toggle SPI0_CS1 _||_
4. Bring SR_EN LOW
- output enabled, disable specific motors/ready to configure

SR_EN (D16) reset state:
State of the terminal after the active low PWRONRSTn
terminal transitions from low to high...

Can extract which
fault is occurring via SPI
by reading DRV_STATUS reg

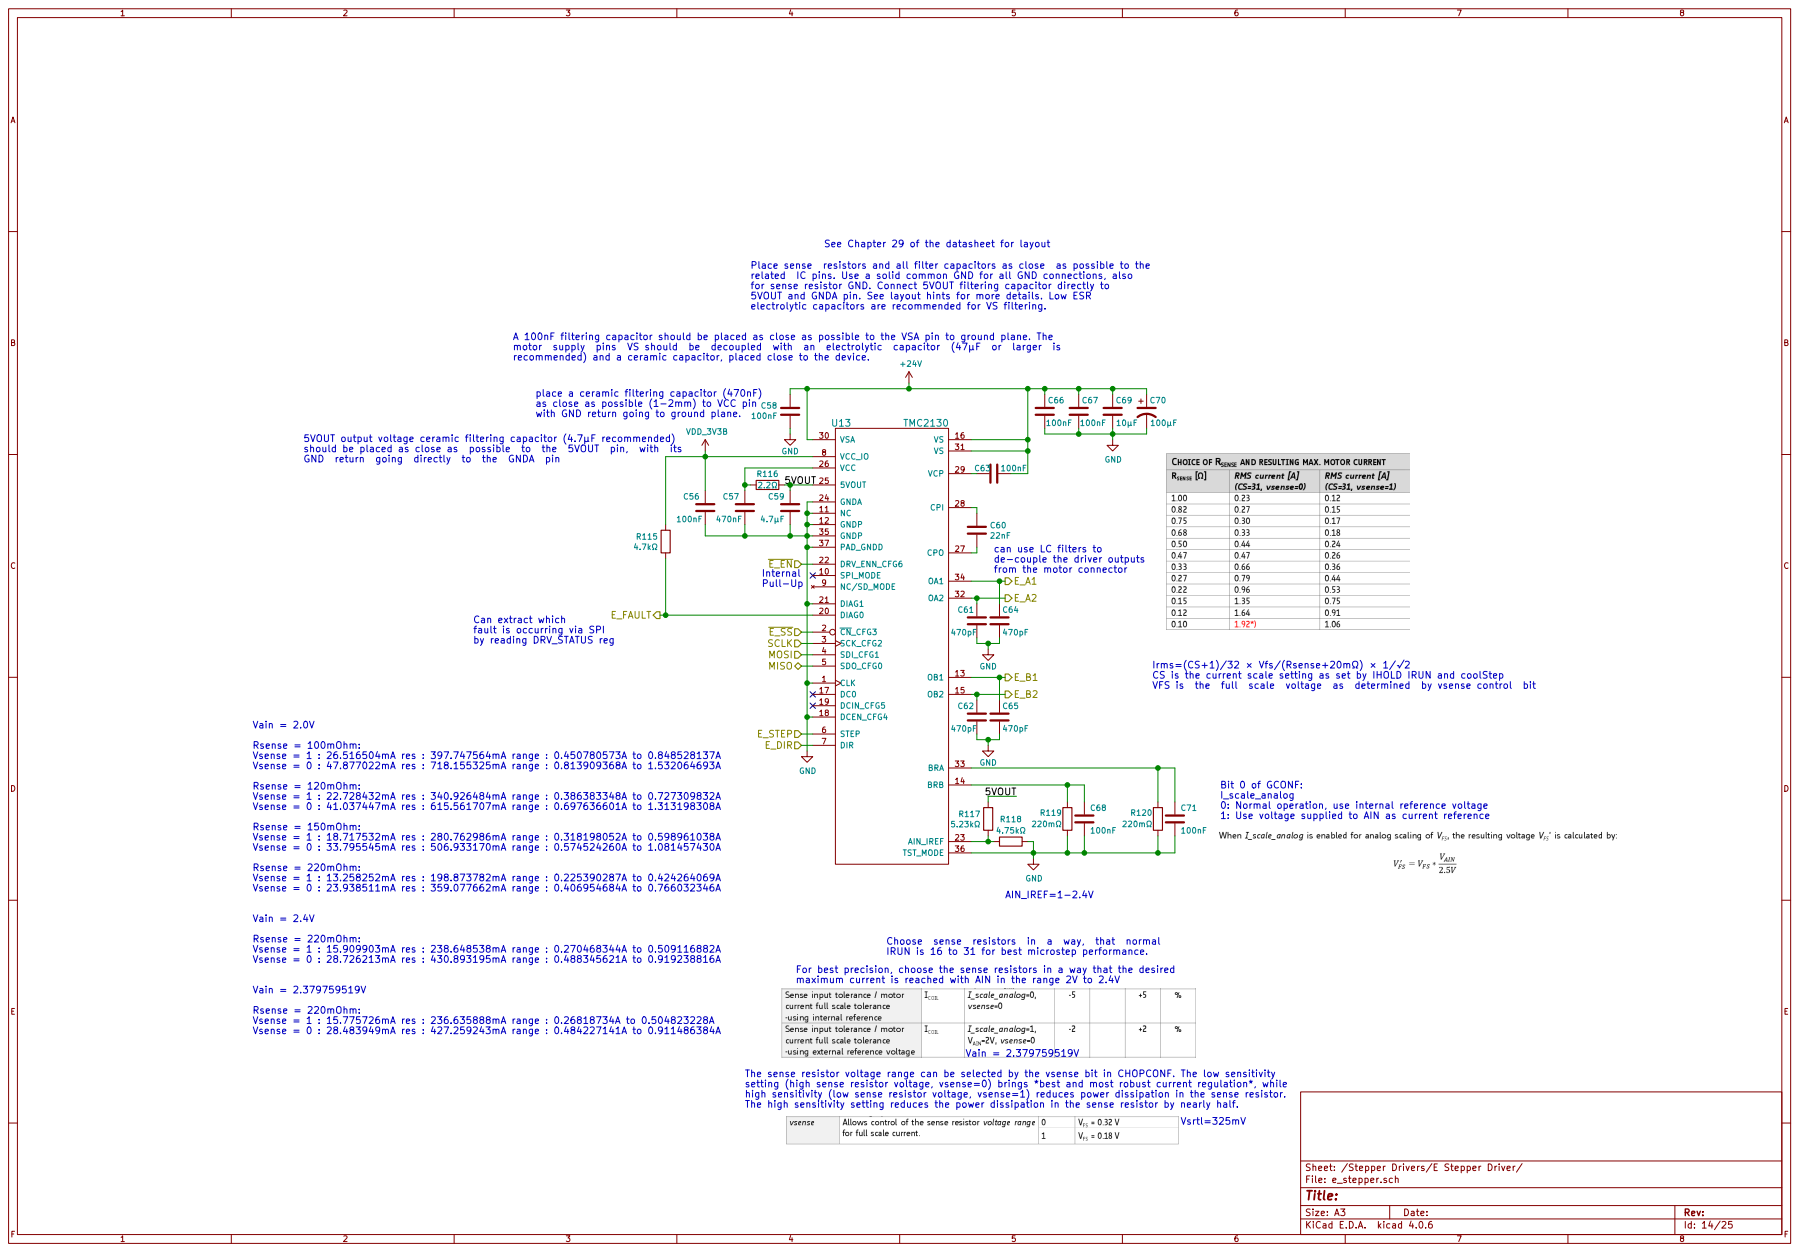
[picture p26: page 14]

See Chapter 29 of the datasheet for layout Vain = 2.0V Rsense = 100mOhm:

10F Place sense resistors and all filter capacitors as close as possible to the
for sense resistor GND. Connect 5VOUT filtering capacitor directly to
5VOUT and GNDA pin. See layout hints for more details. Low ESR
electrolytic capacitors are recommended for VS filtering.

A 100nF filtering capacitor should be placed as close as possible to the VSA pin to ground plane. The
recommended) and a ceramic capacitor, placed close to the device.

place a ceramic filtering capacitor (470nF)
as close as possible (1-2mm) to VCC pin
with GND return going to ground plane.

5VOUT output voltage ceramic filtering capacitor (4.7F recommended)

can use LC filters to
de-couple the driver outputs
from the motor connector

IRUN is 16 to 31 for best microstep performance. C61

Can extract which
fault is occurring via SPI
by reading DRV_STATUS reg

Irms=(CS+1)/32 × Vfs/(Rsense+20m) × 1/2
CS is the current scale setting as set by IHOLD IRUN and coolStep

Vsense = 1 : 26.516504mA res : 397.747564mA range : 0.450780573A to 0.848528137A
Vsense = 0 : 47.877022mA res : 718.155325mA range : 0.813909368A to 1.532064693A
Rsense = 120mOhm:
Vsense = 1 : 22.728432mA res : 340.926484mA range : 0.386383348A to 0.727309832A
Vsense = 0 : 41.037447mA res : 615.561707mA range : 0.697636601A to 1.313198308A
Rsense = 150mOhm:
Vsense = 1 : 18.717532mA res : 280.762986mA range : 0.318198052A to 0.598961038A
Vsense = 0 : 33.795545mA res : 506.933170mA range : 0.574524260A to 1.081457430A
Rsense = 220mOhm:
Vsense = 1 : 13.258252mA res : 198.873782mA range : 0.225390287A to 0.424264069A
Vsense = 0 : 23.938511mA res : 359.077662mA range : 0.406954684A to 0.766032346A

I_scale_analog
0: Normal operation, use internal reference voltage
1: Use voltage supplied to AIN as current reference

Vain = 2.379759519V Choose sense resistors in a way, that normal

Vsense = 1 : 15.909903mA res : 238.648538mA range : 0.270468344A to 0.509116882A
Vsense = 0 : 28.726213mA res : 430.893195mA range : 0.488345621A to 0.919238816A

For best precision, choose the sense resistors in a way that the desired
maximum current is reached with AIN in the range 2V to 2.4V

Vsense = 1 : 15.775726mA res : 236.635888mA range : 0.26818734A to 0.504823228A
Vsense = 0 : 28.483949mA res : 427.259243mA range : 0.484227141A to 0.911486384A

The sense resistor voltage range can be selected by the vsense bit in CHOPCONF. The low sensitivity
setting (high sense resistor voltage, vsense=0) brings *best and most robust current regulation*, while
high sensitivity (low sense resistor voltage, vsense=1) reduces power dissipation in the sense resistor.
The high sensitivity setting reduces the power dissipation in the sense resistor by nearly half.

Sheet: /Stepper Drivers/E Stepper Driver/
File: e_stepper.sch
Id: 14/25 Title:

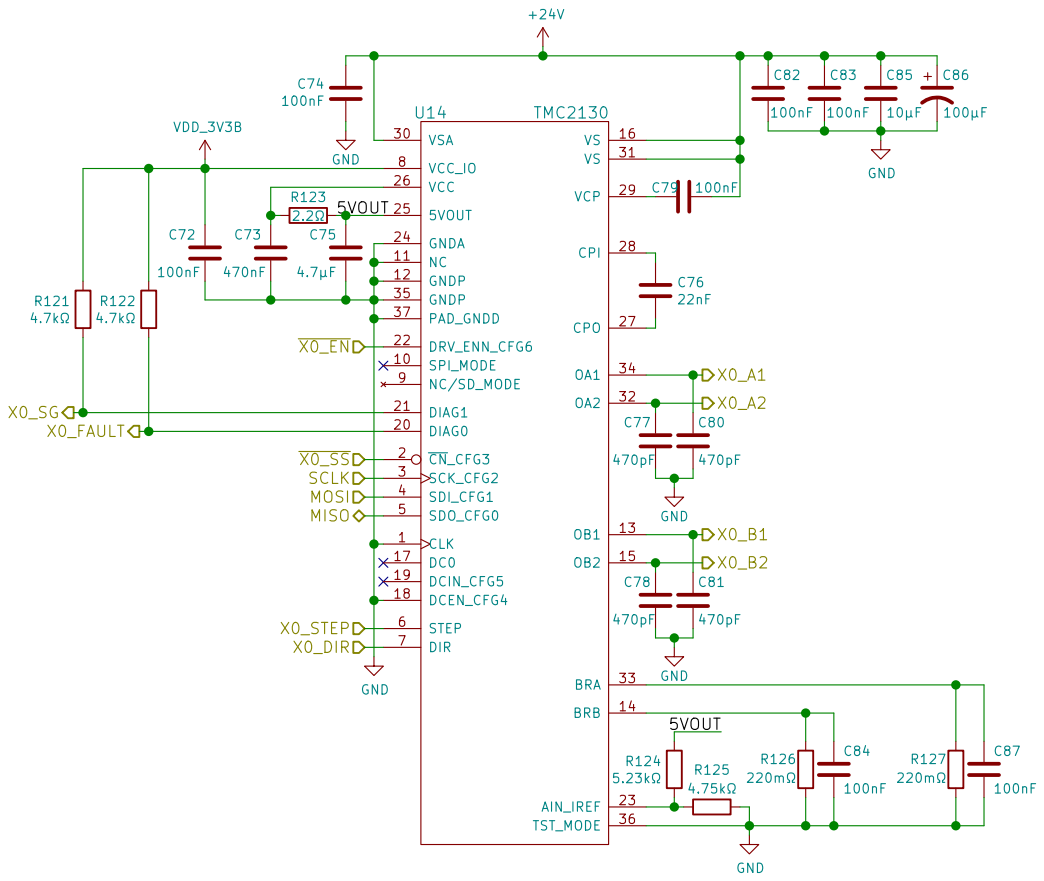
[picture p27: page 15]

Sheet: /Stepper Drivers/X0 Stepper Driver/
File: x0_stepper.sch
Id: 15/25 Title:

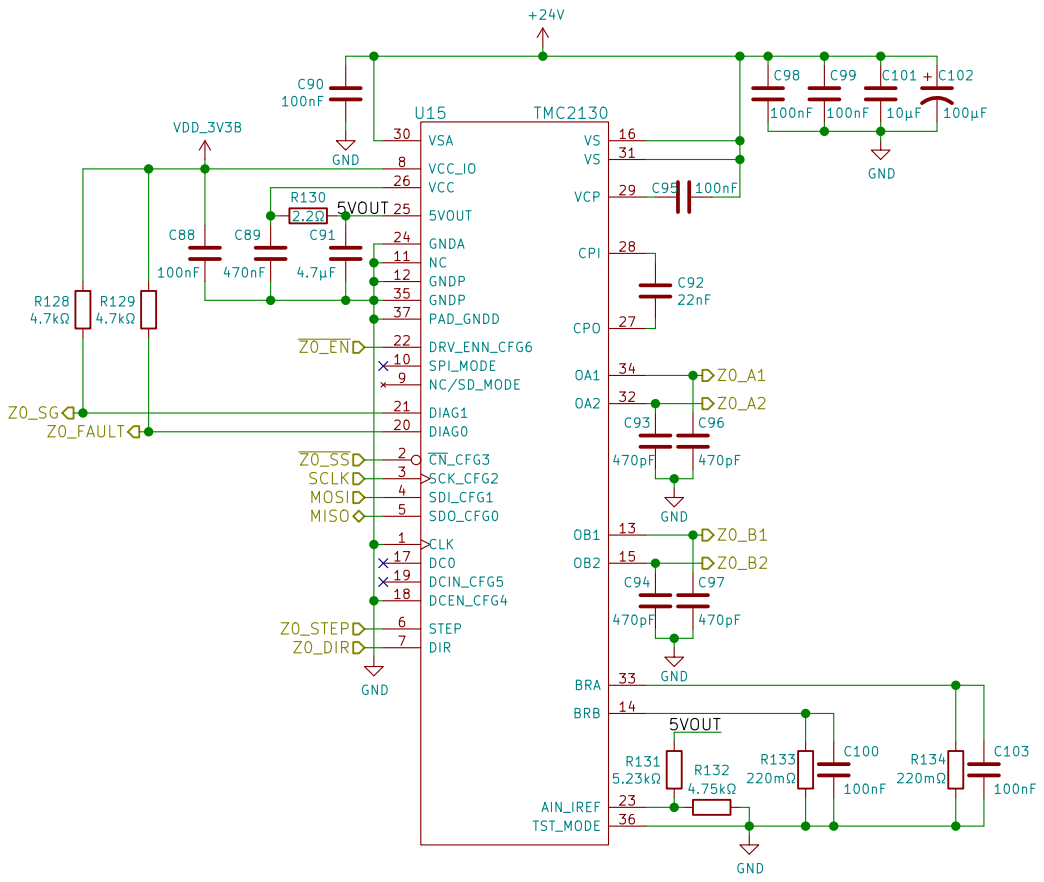
[picture p28: page 16]

Sheet: /Stepper Drivers/Z0 Stepper Driver/
File: z0_stepper.sch
Id: 16/25 Title:

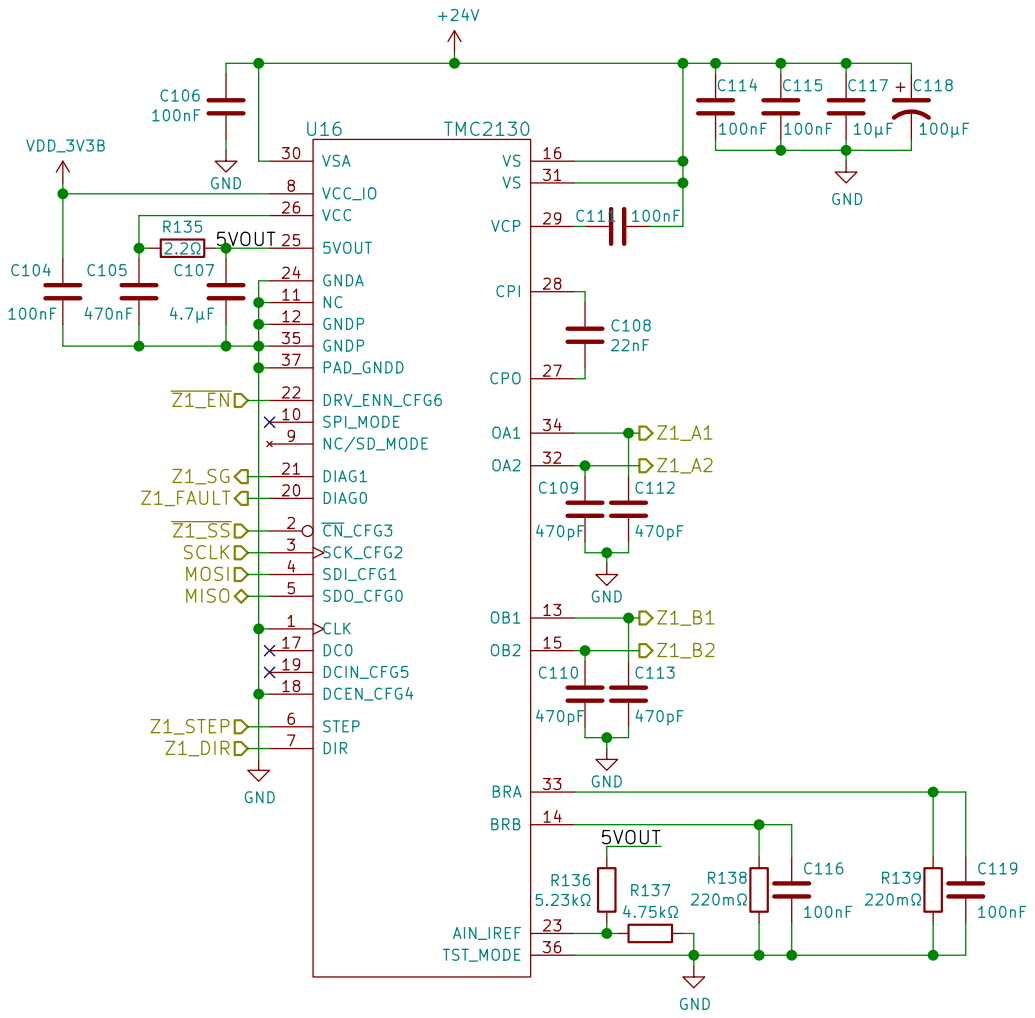
[picture p29: page 17]

Sheet: /Stepper Drivers/Z1 Stepper Driver/
File: z1_stepper.sch
Id: 17/25 Title:

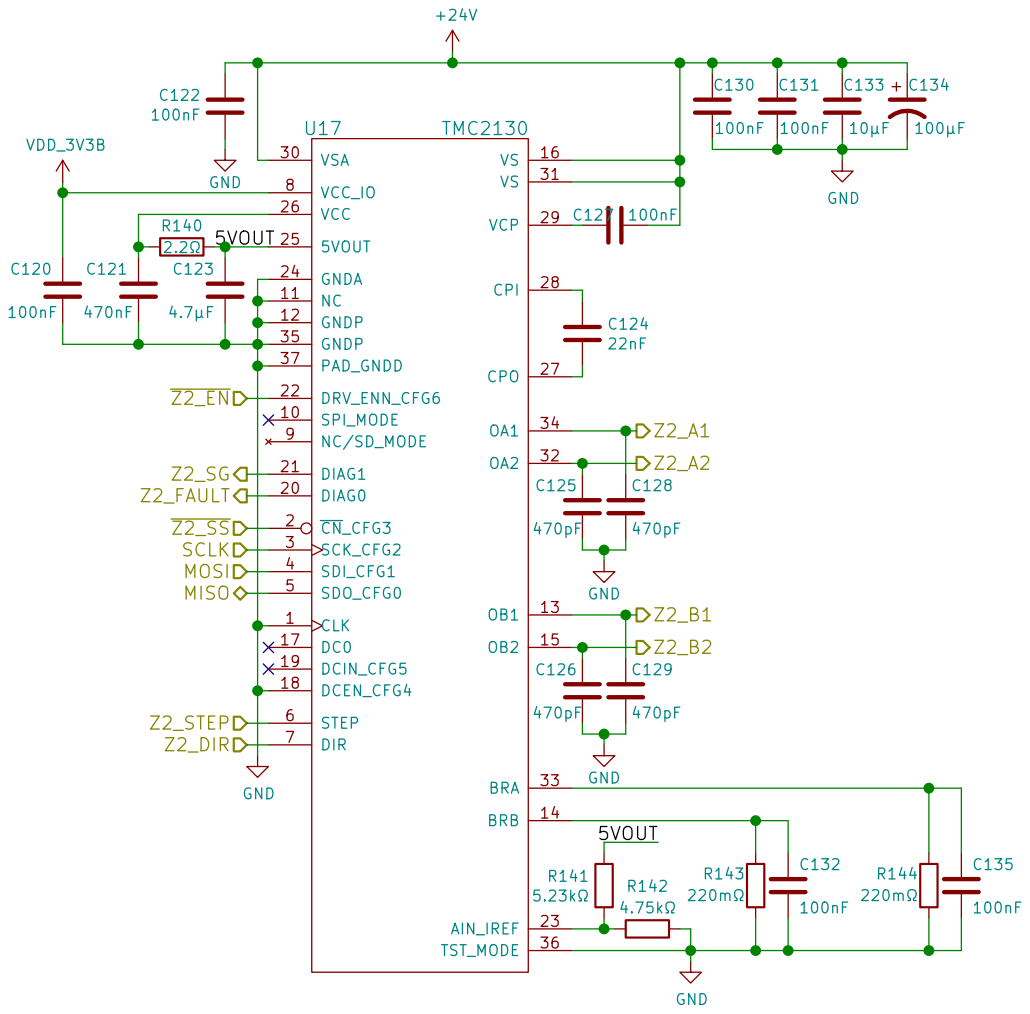
[picture p30: page 18]

Sheet: /Stepper Drivers/Z2 Stepper Driver/
File: z2_stepper.sch
Id: 18/25 Title:

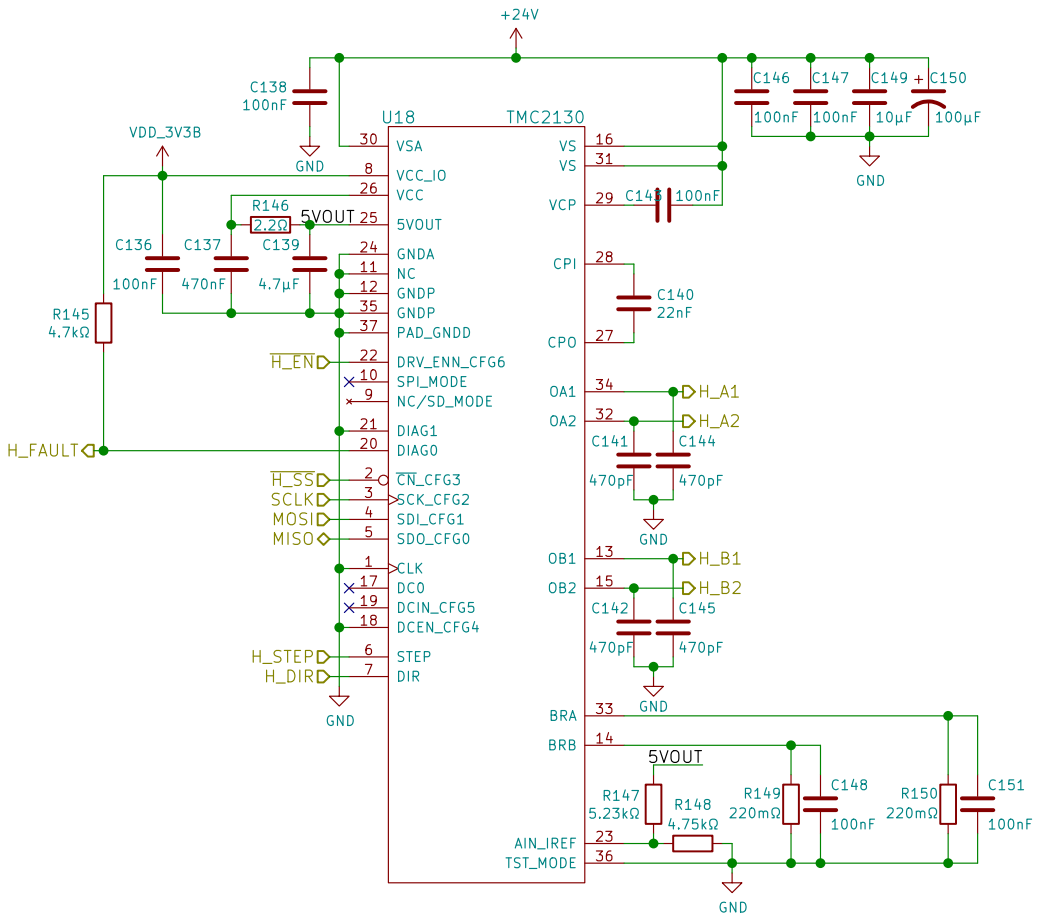
[picture p31: page 19]

Sheet: /Stepper Drivers/H Stepper Driver/
File: h_stepper.sch
Id: 19/25 Title:

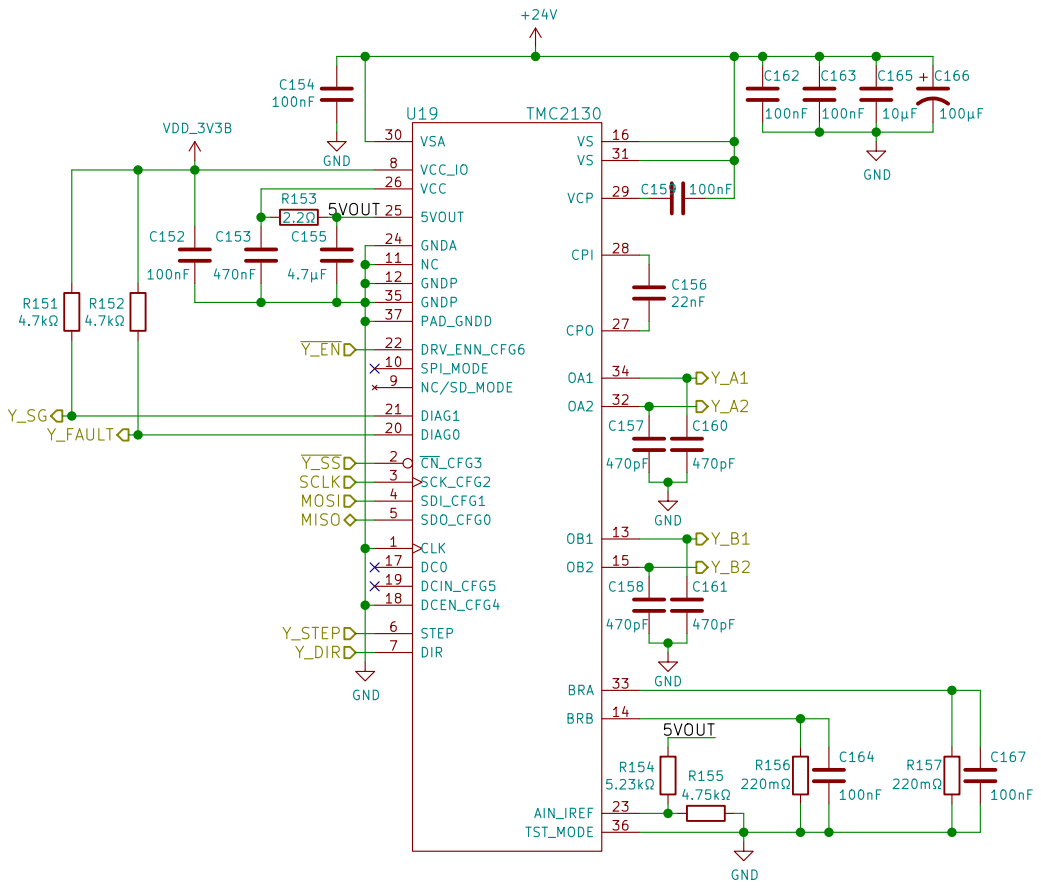
[picture p32: page 20]

Sheet: /Stepper Drivers/Y Stepper Driver/
File: y_stepper.sch
Id: 20/25 Title:

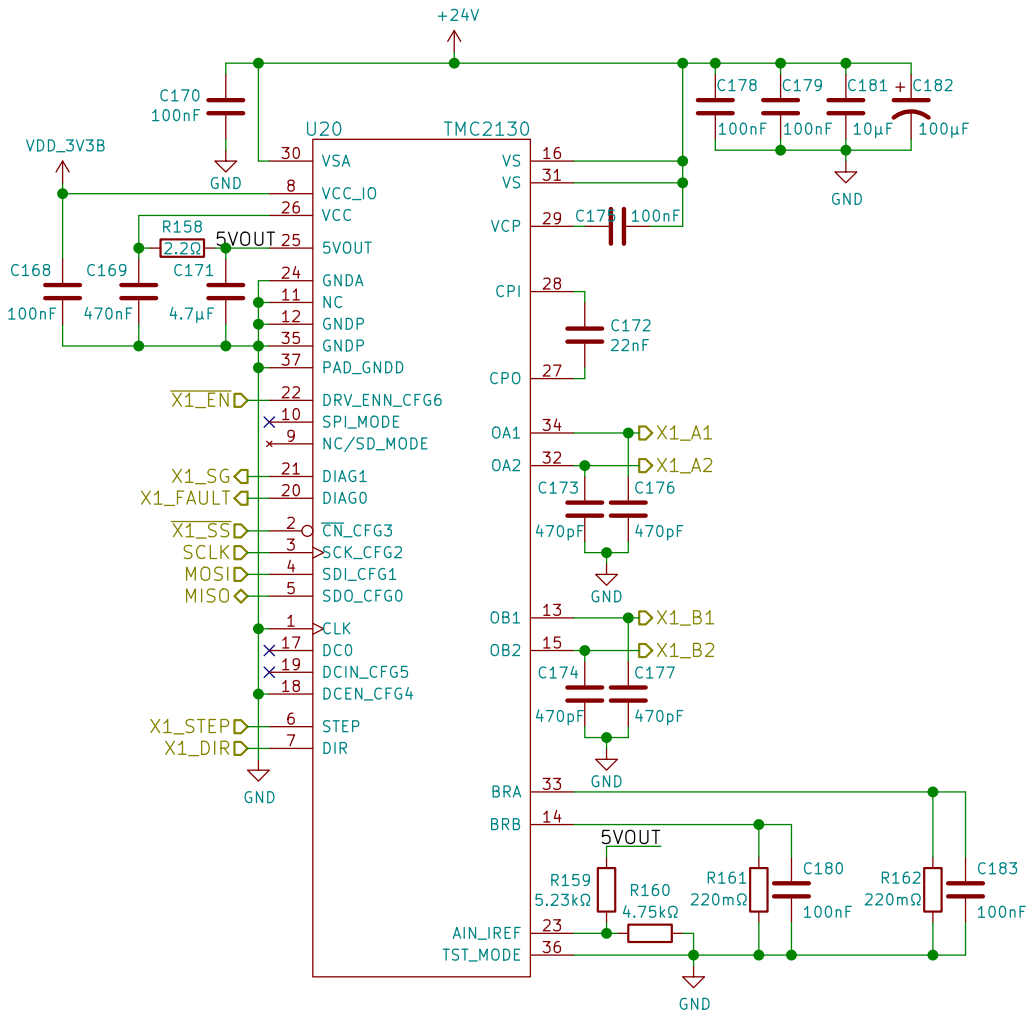
[picture p33: page 21]

Sheet: /Stepper Drivers/X1 Stepper Driver/
File: x1_stepper.sch
Id: 21/25 Title:

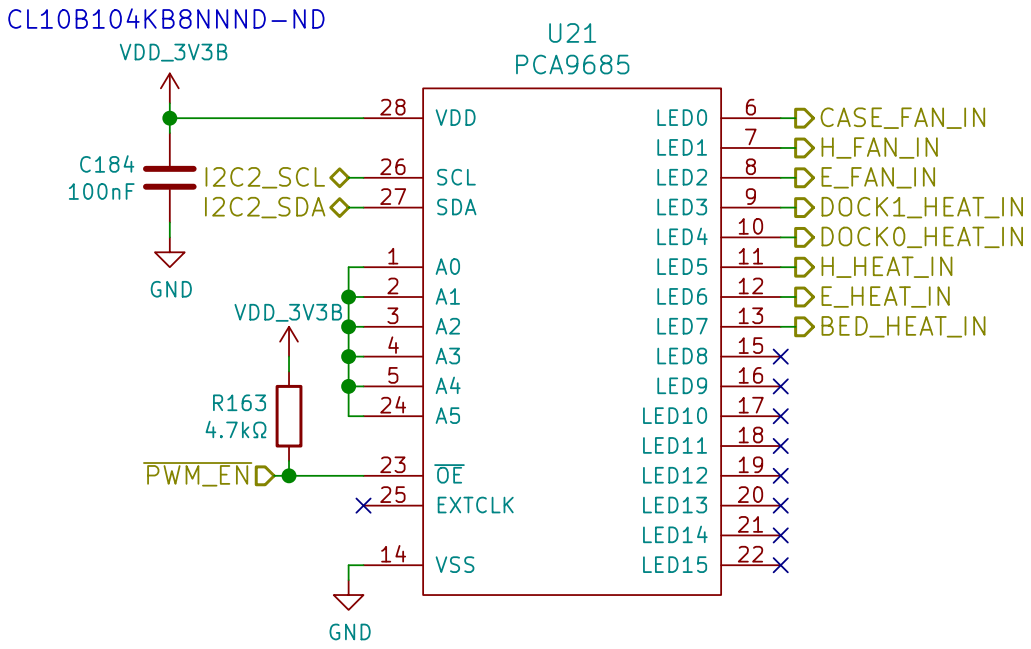
[picture p34: page 22]

File: pwm.sch Sheet: /PWM/
Id: 22/25 Title:

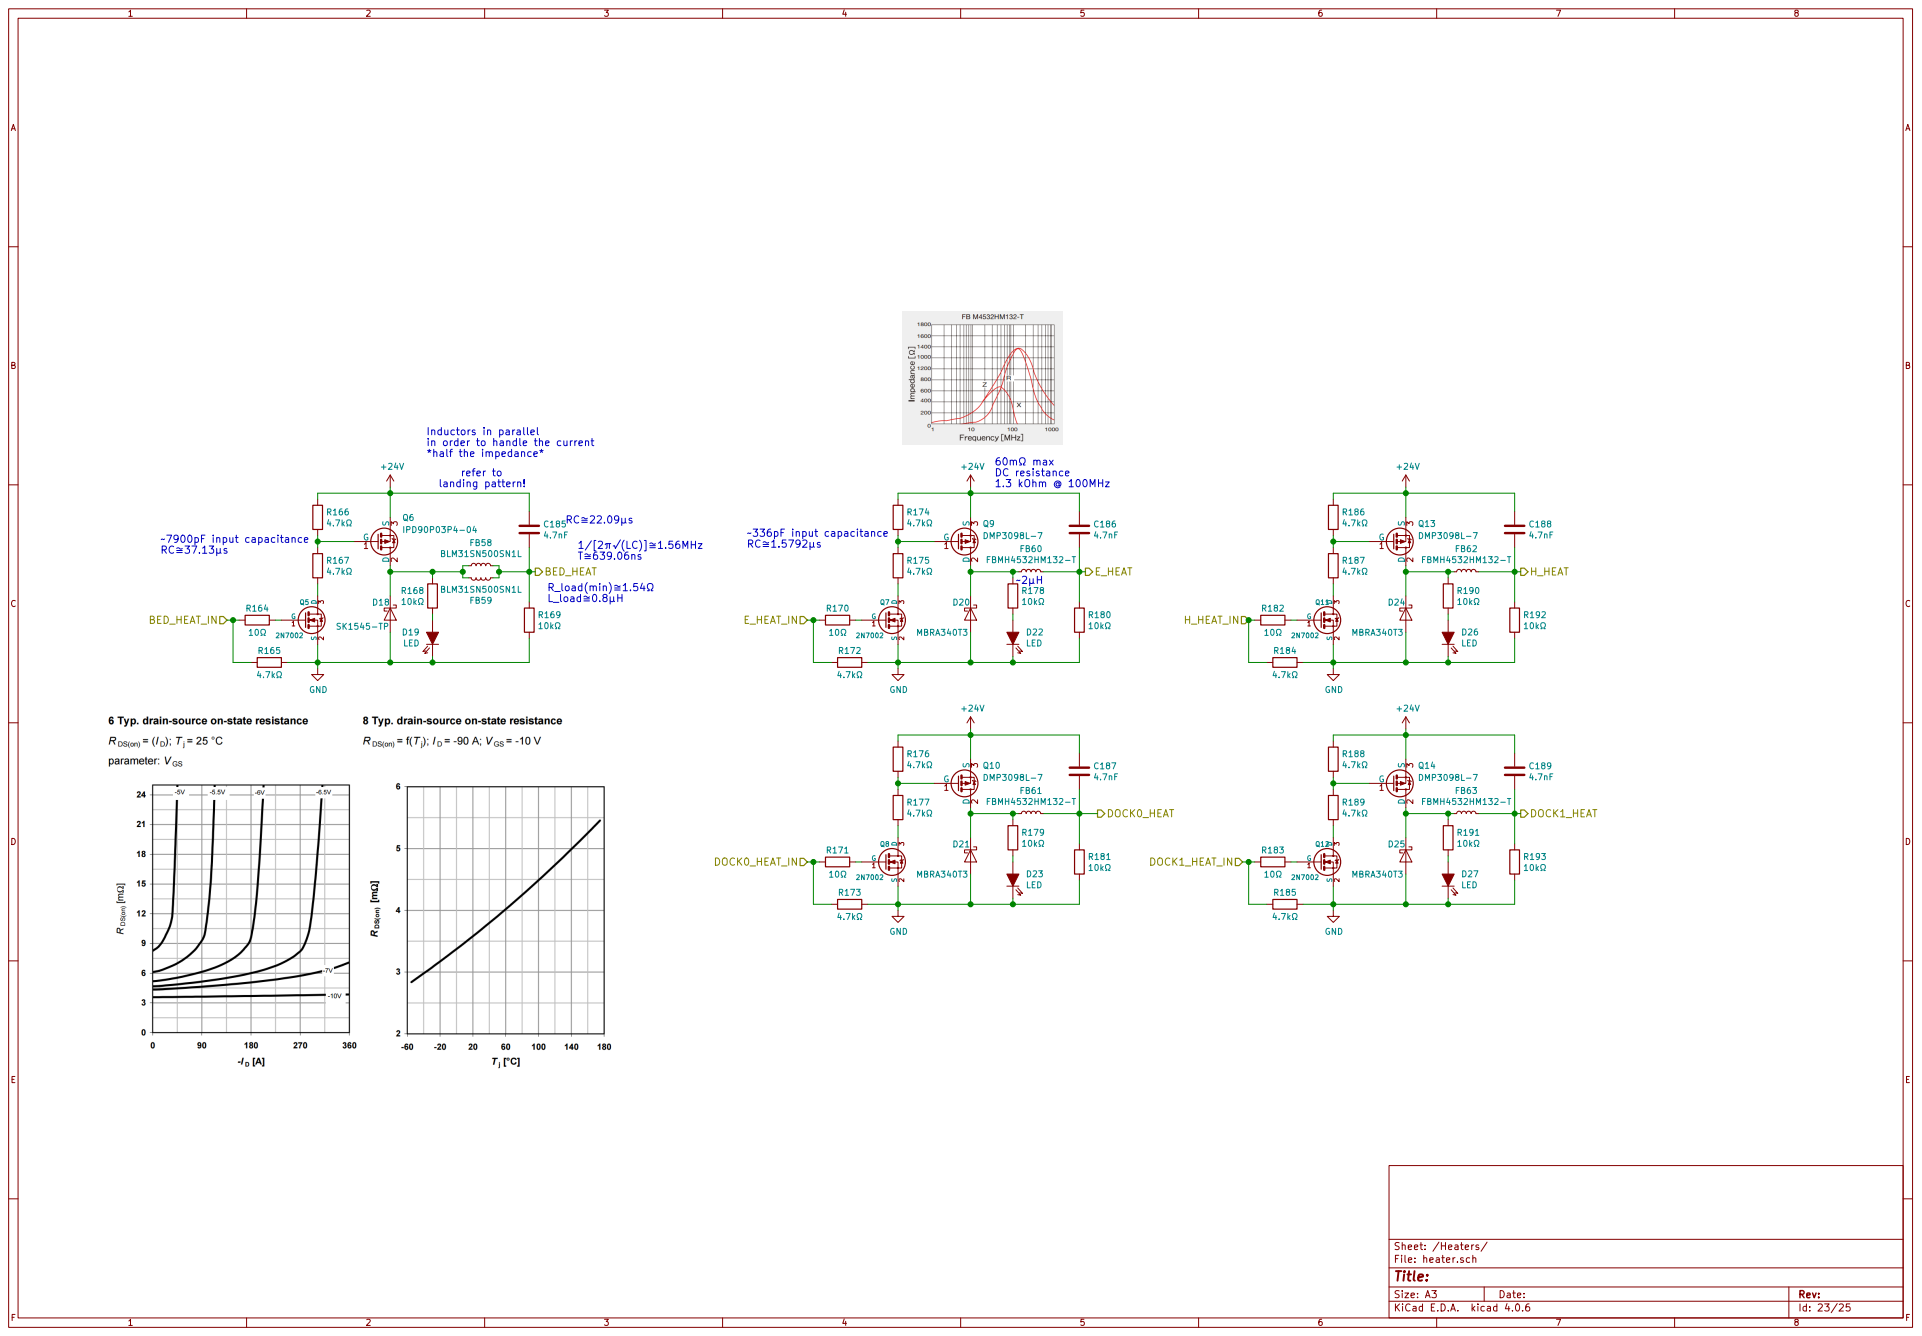
[picture p35: page 23]

Inductors in parallel
in order to handle the current *half the impedance*

Id: 23/25 Title: File: heater.sch Sheet: /Heaters/

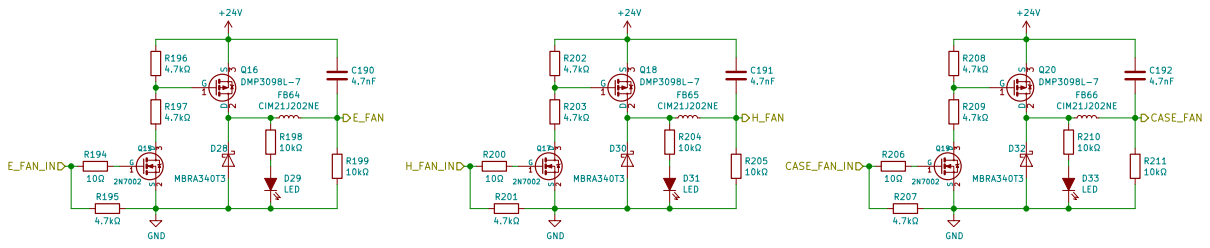
[picture p36: page 24]

Id: 24/25 Title: File: fan.sch Sheet: /Fans/

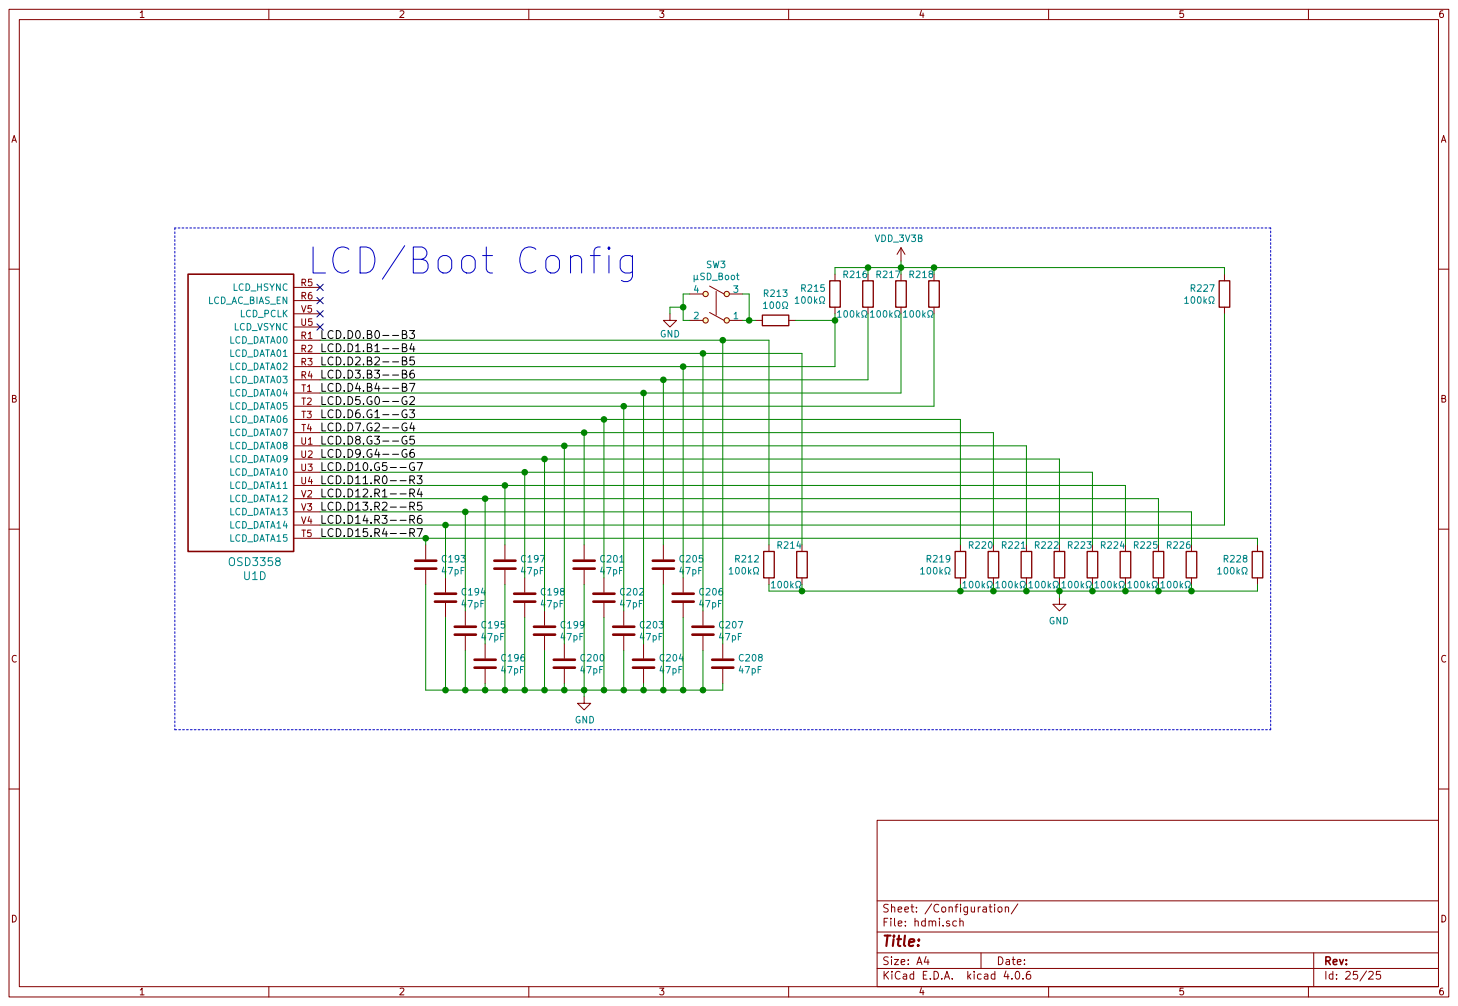
[picture p37: page 25]

LCD.D2.B2--B5
LCD.D3.B3--B6
LCD.D4.B4--B7

LCD.D7.G2--G4
LCD.D8.G3--G5
LCD.D9.G4--G6

LCD.D12.R1--R4
LCD.D13.R2--R5
LCD.D14.R3--R6

Id: 25/25 Title: File: hdmi.sch Sheet: /Configuration/ C193
47pFC194
