gralco/cimarron/KiMBo/KiMBo.kicad_pcb

## KiCad design KiMBo/KiMBo.kicad_pcb (2017-06-15)

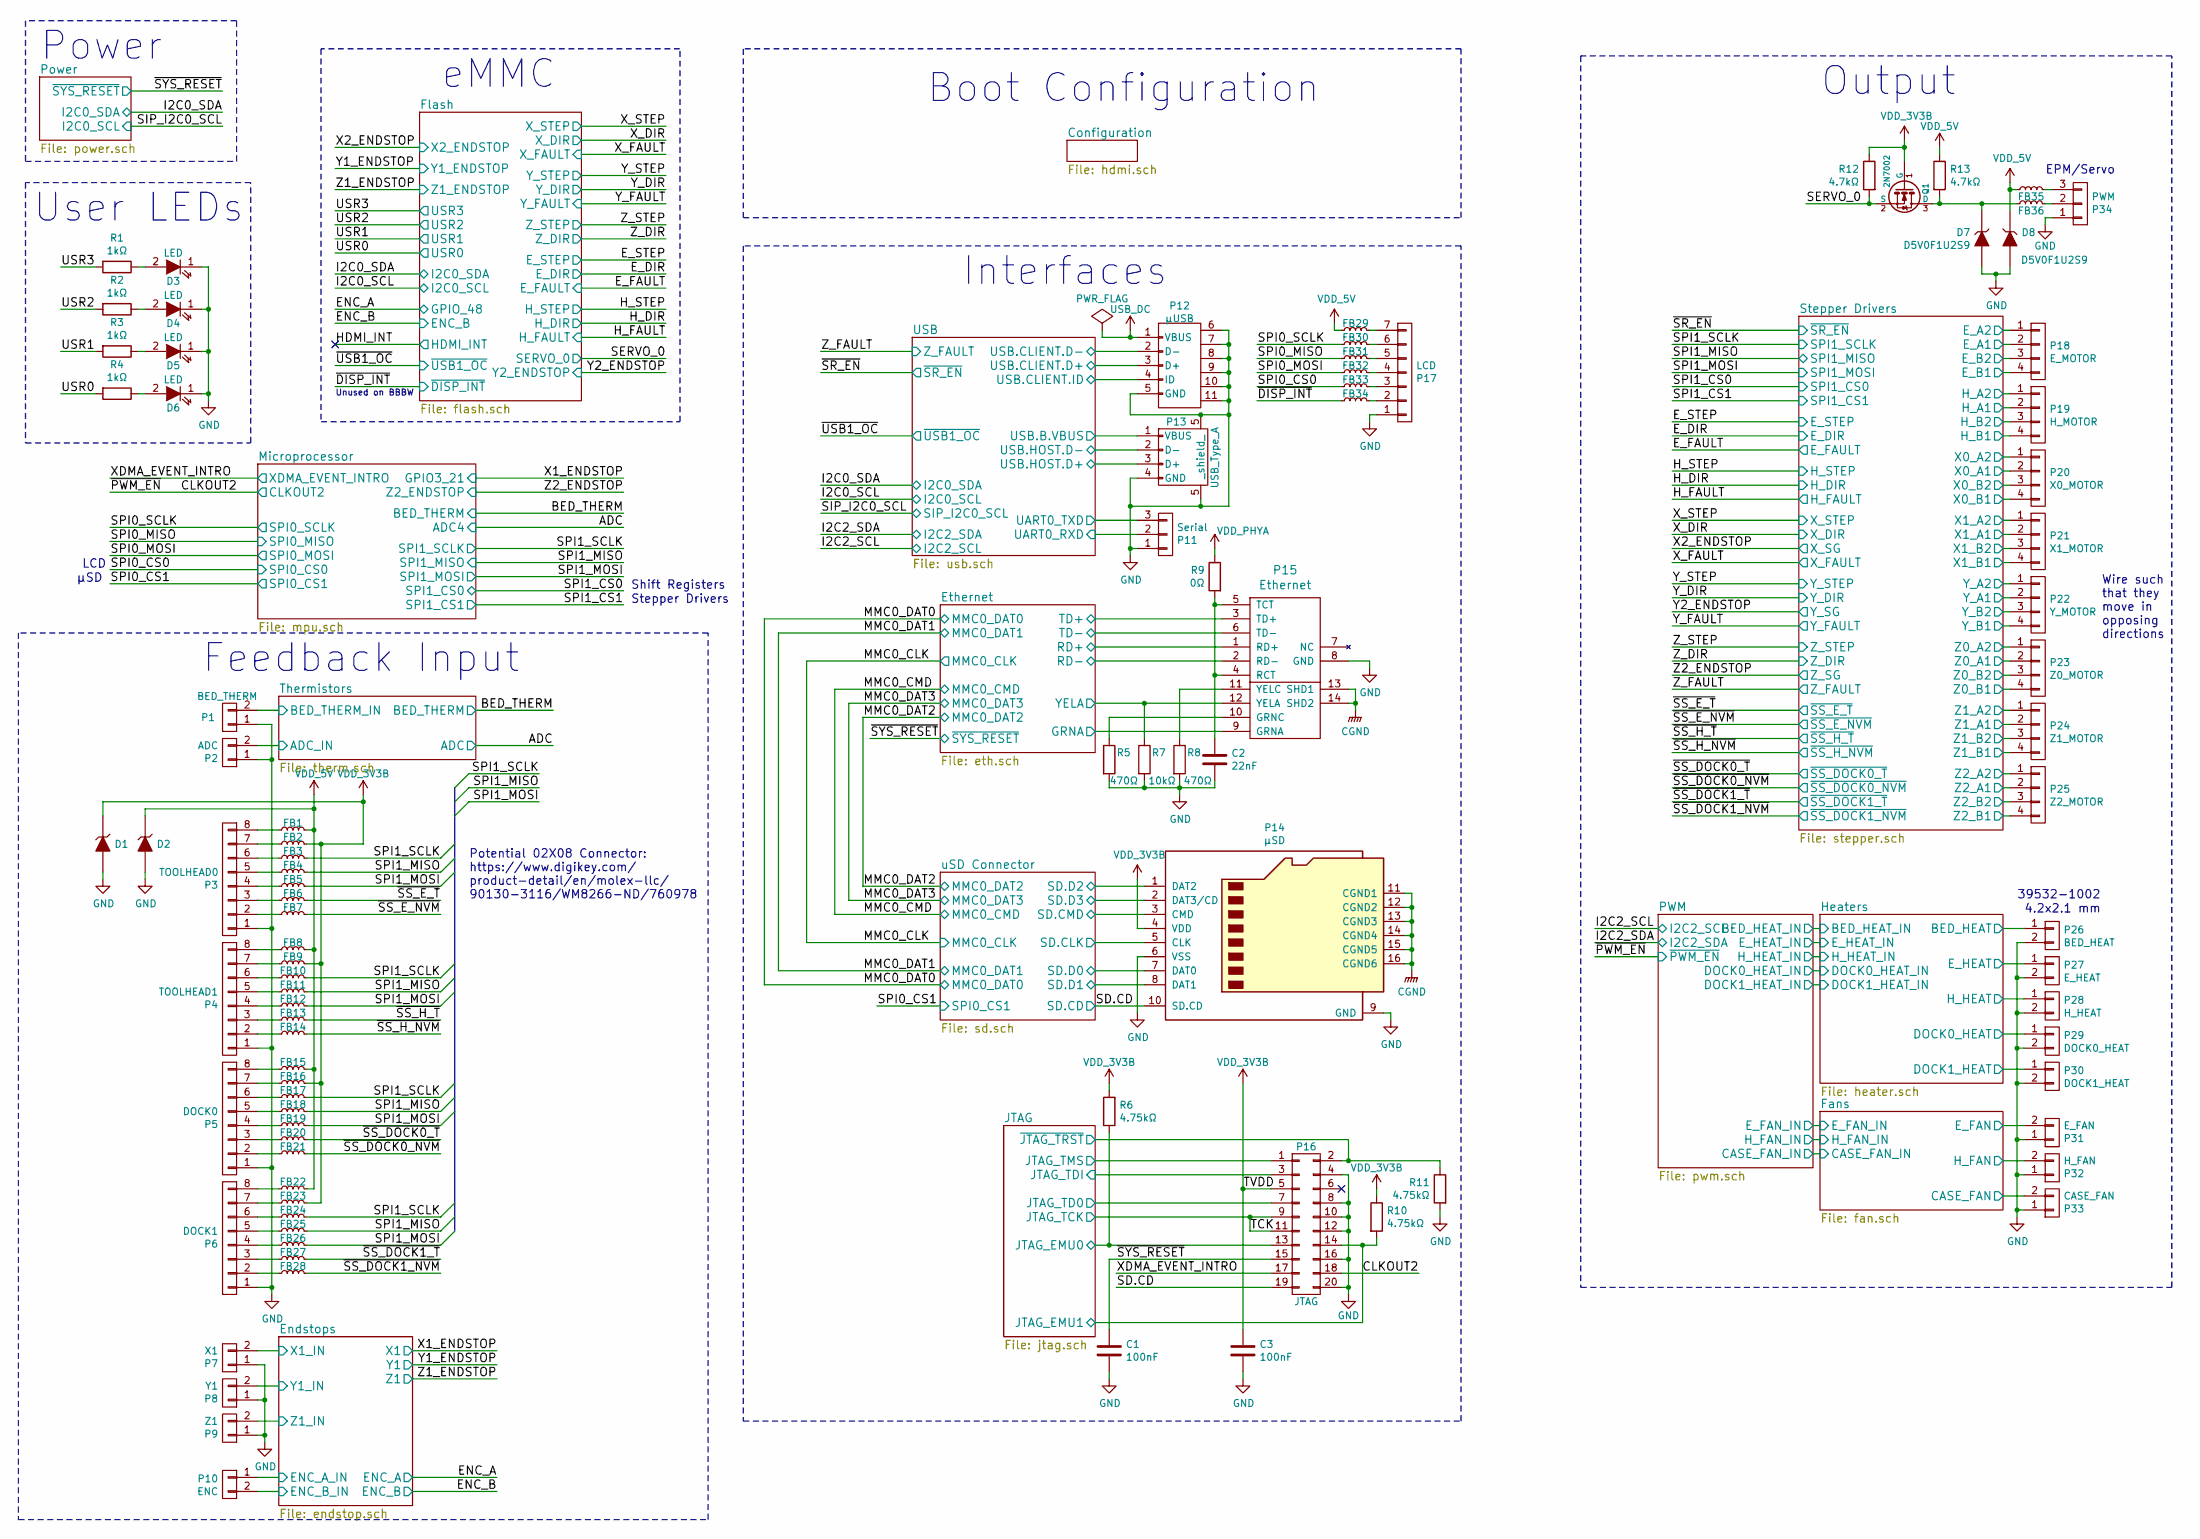
[picture p38: schematic KiMBo.sch]

Parts:
C1, C3: 100nF; C_0603
C2: 22nF; C_0603
D1: TPD1E04U04DPYR; TPD_PX1SON
D2, D7, D8: D5V0F1U2S9; SOD-923
D3, D4, D5, D6: LED; LED_0603
FB1, FB2, FB8, FB9, FB15, FB16, FB22, FB23, FB29: MPZ1608S102ATA00; Ferrite_Bead_0603
FB3, FB4, FB5, FB6, FB7, FB10, FB11, FB12, FB13, FB14, FB17, FB18, FB19, FB20, FB21, FB24, FB25, FB26, FB27, FB28, FB30, FB31, FB32, FB33, FB34, FB36: MMZ1608A252BTA00; Ferrite_Bead_0603
FB35: MPZ2012S601AT000; Ferrite_Bead_0805
P1: BED_THERM; Pin_Header_Angled_1x02
P2: ADC; Pin_Header_Angled_1x02
P3: TOOLHEAD0; Pin_Header_Angled_1x08
P4: TOOLHEAD1; Pin_Header_Angled_1x08
P5: DOCK0; Pin_Header_Angled_1x08
P6: DOCK1; Pin_Header_Angled_1x08
P7: X1; Pin_Header_Angled_1x02
P8: Y1; Pin_Header_Angled_1x02
P9: Z1; Pin_Header_Angled_1x02
P10: ENC; Pin_Header_Angled_1x02
P11: Serial; Pin_Header_Straight_1x03
P12: μUSB; USB_MICRO_B_ST-USB-001E
P13: USB_Type_A; USB_A
P14: μSD; SCHA5B0200
P15: Ethernet; Ethernet-LPJ0011BBNL
P16: JTAG
P17: LCD; Pin_Header_Angled_1x07
P18: E_MOTOR; Pin_Header_Angled_1x04
P19: H_MOTOR; Pin_Header_Angled_1x04
P20: X0_MOTOR; Pin_Header_Angled_1x04
P21: X1_MOTOR; Pin_Header_Angled_1x04
P22: Y_MOTOR; Pin_Header_Angled_1x04
P23: Z0_MOTOR; Pin_Header_Angled_1x04
P24: Z1_MOTOR; Pin_Header_Angled_1x04
P25: Z2_MOTOR; Pin_Header_Angled_1x04
P26: BED_HEAT; euro_header_2_angled
P27: E_HEAT; euro_header_2_angled
P28: H_HEAT; euro_header_2_angled
P29: DOCK0_HEAT; euro_header_2_angled
P30: DOCK1_HEAT; euro_header_2_angled
P31: E_FAN; Pin_Header_Angled_1x02
P32: H_FAN; Pin_Header_Angled_1x02
P33: CASE_FAN; Pin_Header_Angled_1x02
P34: PWM; Pin_Header_Angled_1x03
Q1: 2N7002; SOT-23
R1, R2, R3, R4: 1kΩ; R_0603
R5, R8: 470Ω; R_0603
R6, R10, R11: 4.75kΩ; R_0603
R7: 10kΩ; R_0603
R9: 0Ω; R_0603
R12, R13: 4.7kΩ; R_0603

Connections:
/CLKOUT2: P16.18; also elsewhere on the board
/Endstops/ENC_A_IN: P10.1; also elsewhere on the board
/Endstops/ENC_B_IN: P10.2; also elsewhere on the board
/Endstops/X1_IN: P7.2; also elsewhere on the board
/Endstops/Y1_IN: P8.2; also elsewhere on the board
/Endstops/Z1_IN: P9.2; also elsewhere on the board
/Ethernet/GRNA: P15.9 (GRNA); also elsewhere on the board
/Ethernet/RD+: P15.1 (RD+); also elsewhere on the board
/Ethernet/RD-: P15.2 (RD-); also elsewhere on the board
/Ethernet/TD+: P15.3 (TD+); also elsewhere on the board
/Ethernet/TD-: P15.6 (TD-); also elsewhere on the board
/Ethernet/YELA: P15.12 (YELA), R7.1; also elsewhere on the board
/Fans/CASE_FAN: P33.2; also elsewhere on the board
/Fans/E_FAN: P31.2; also elsewhere on the board
/Fans/H_FAN: P32.2; also elsewhere on the board
/Heaters/BED_HEAT: P26.1; also elsewhere on the board
/Heaters/DOCK0_HEAT: P29.1; also elsewhere on the board
/Heaters/DOCK1_HEAT: P30.1; also elsewhere on the board
/Heaters/E_HEAT: P27.1; also elsewhere on the board
/Heaters/H_HEAT: P28.1; also elsewhere on the board
/JTAG/JTAG_EMU0: P16.13, R6.1; also elsewhere on the board
/JTAG/JTAG_EMU1: P16.14, R10.2; also elsewhere on the board
/JTAG/JTAG_TD0: P16.7; also elsewhere on the board
/JTAG/JTAG_TDI: P16.3; also elsewhere on the board
/JTAG/JTAG_TMS: P16.1; also elsewhere on the board
/JTAG/~JTAG_TRST: P16.2, R11.1; also elsewhere on the board
/MMC0_CLK: P14.5 (CLK); also elsewhere on the board
/MMC0_CMD: P14.3 (CMD); also elsewhere on the board
/MMC0_DAT0: P14.7 (DAT0); also elsewhere on the board
/MMC0_DAT1: P14.8 (DAT1); also elsewhere on the board
/MMC0_DAT2: P14.1 (DAT2); also elsewhere on the board
/MMC0_DAT3: P14.2 (DAT3/CD); also elsewhere on the board
/SD.CD: P14.10 (SD.CD), P16.19; also elsewhere on the board
/SERVO_0: Q1.2 (S), R12.2; also elsewhere on the board
/SPI0_CS0: FB33.1; also elsewhere on the board
/SPI0_MISO: FB31.1; also elsewhere on the board
/SPI0_MOSI: FB32.1; also elsewhere on the board
/SPI0_SCLK: FB30.1; also elsewhere on the board
/SPI1_MISO: FB4.1, FB11.1, FB18.1, FB25.1; also elsewhere on the board
/SPI1_MOSI: FB5.1, FB12.1, FB19.1, FB26.1; also elsewhere on the board
/SPI1_SCLK: FB3.1, FB10.1, FB17.1, FB24.1; also elsewhere on the board
/Stepper Drivers/E_A1: P18.2; also elsewhere on the board
/Stepper Drivers/E_A2: P18.1; also elsewhere on the board
/Stepper Drivers/E_B1: P18.4; also elsewhere on the board
/Stepper Drivers/E_B2: P18.3; also elsewhere on the board
/Stepper Drivers/H_A1: P19.2; also elsewhere on the board
/Stepper Drivers/H_A2: P19.1; also elsewhere on the board
/Stepper Drivers/H_B1: P19.4; also elsewhere on the board
/Stepper Drivers/H_B2: P19.3; also elsewhere on the board
/Stepper Drivers/X0_A1: P20.2; also elsewhere on the board
/Stepper Drivers/X0_A2: P20.1; also elsewhere on the board
/Stepper Drivers/X0_B1: P20.4; also elsewhere on the board
/Stepper Drivers/X0_B2: P20.3; also elsewhere on the board
/Stepper Drivers/X1_A1: P21.2; also elsewhere on the board
/Stepper Drivers/X1_A2: P21.1; also elsewhere on the board
/Stepper Drivers/X1_B1: P21.4; also elsewhere on the board
/Stepper Drivers/X1_B2: P21.3; also elsewhere on the board
/Stepper Drivers/Y_A1: P22.2; also elsewhere on the board
/Stepper Drivers/Y_A2: P22.1; also elsewhere on the board
/Stepper Drivers/Y_B1: P22.4; also elsewhere on the board
/Stepper Drivers/Y_B2: P22.3; also elsewhere on the board
/Stepper Drivers/Z0_A1: P23.2; also elsewhere on the board
/Stepper Drivers/Z0_A2: P23.1; also elsewhere on the board
/Stepper Drivers/Z0_B1: P23.4; also elsewhere on the board
/Stepper Drivers/Z0_B2: P23.3; also elsewhere on the board
/Stepper Drivers/Z1_A1: P24.2; also elsewhere on the board
/Stepper Drivers/Z1_A2: P24.1; also elsewhere on the board
/Stepper Drivers/Z1_B1: P24.4; also elsewhere on the board
/Stepper Drivers/Z1_B2: P24.3; also elsewhere on the board
/Stepper Drivers/Z2_A1: P25.2; also elsewhere on the board
/Stepper Drivers/Z2_A2: P25.1; also elsewhere on the board
/Stepper Drivers/Z2_B1: P25.4; also elsewhere on the board
/Stepper Drivers/Z2_B2: P25.3; also elsewhere on the board
/TCK: P16.9, P16.11; also elsewhere on the board
/Thermistors/ADC_IN: P2.2; also elsewhere on the board
/Thermistors/BED_THERM_IN: P1.2; also elsewhere on the board
/USB/UART0_RXD: P11.2; also elsewhere on the board
/USB/UART0_TXD: P11.3; also elsewhere on the board
/USB/USB.B.VBUS: P13.1 (VBUS); also elsewhere on the board
/USB/USB.CLIENT.D+: P12.3 (D+); also elsewhere on the board
/USB/USB.CLIENT.D-: P12.2 (D-); also elsewhere on the board
/USB/USB.CLIENT.ID: P12.4 (ID); also elsewhere on the board
/USB/USB.HOST.D+: P13.3 (D+); also elsewhere on the board
/USB/USB.HOST.D-: P13.2 (D-); also elsewhere on the board
/USR0: R4.2; also elsewhere on the board
/USR1: R3.2; also elsewhere on the board
/USR2: R2.2; also elsewhere on the board
/USR3: R1.2; also elsewhere on the board
/XDMA_EVENT_INTRO: P16.17; also elsewhere on the board
/~DISP_INT: FB34.1; also elsewhere on the board
/~SS_DOCK0_NVM: FB21.1; also elsewhere on the board
/~SS_DOCK0_T: FB20.1; also elsewhere on the board
/~SS_DOCK1_NVM: FB28.1; also elsewhere on the board
/~SS_DOCK1_T: FB27.1; also elsewhere on the board
/~SS_E_NVM: FB7.1; also elsewhere on the board
/~SS_E_T: FB6.1; also elsewhere on the board
/~SS_H_NVM: FB14.1; also elsewhere on the board
/~SS_H_T: FB13.1; also elsewhere on the board
/~SYS_RESET: C1.1, P16.15; also elsewhere on the board
CGND: C1.2, C2.2, C3.2, D1.2 (A), D2.2 (A), D3.1 (K), D4.1 (K), D5.1 (K), D6.1 (K), D7.2 (A), D8.2 (A), P1.1, P2.1, P3.1, P4.1, P5.1, P6.1, P7.1, P8.1, P9.1, P11.1, P12.5 (GND), P12.6, P12.7, P12.8, P12.9, P12.10, P12.11, P13.4 (GND), P13.5 (_shi), P14.6 (VSS), P14.9 (GND), P14.11 (CGND1), P14.12 (CGND2), P14.13 (CGND3), P14.14 (CGND4), P14.15 (CGND5), P14.16 (CGND6), P15.8 (GND), P15.13 (SHD1), P15.14 (SHD2), P16.4, P16.8, P16.10, P16.12, P16.16, P16.20, P17.1, P26.2, P27.2, P28.2, P29.2, P30.2, P31.1, P32.1, P33.1, P34.1, R5.2, R7.2, R8.2, R11.2; also elsewhere on the board
unnamed: C2.1, P15.4 (RCT), P15.5 (TCT), R9.2
unnamed: D3.2 (A), R1.1
unnamed: D4.2 (A), R2.1
unnamed: D5.2 (A), R3.1
unnamed: D6.2 (A), R4.1
unnamed: D7.1 (K), FB36.1, Q1.3 (D), R13.2
unnamed: FB1.2, P3.8
unnamed: FB2.2, P3.7
unnamed: FB3.2, P3.6
unnamed: FB4.2, P3.5
unnamed: FB5.2, P3.4
unnamed: FB6.2, P3.3
unnamed: FB7.2, P3.2
unnamed: FB8.2, P4.8
unnamed: FB9.2, P4.7
unnamed: FB10.2, P4.6
unnamed: FB11.2, P4.5
unnamed: FB12.2, P4.4
unnamed: FB13.2, P4.3
unnamed: FB14.2, P4.2
unnamed: FB15.2, P5.8
unnamed: FB16.2, P5.7
unnamed: FB17.2, P5.6
unnamed: FB18.2, P5.5
unnamed: FB19.2, P5.4
unnamed: FB20.2, P5.3
unnamed: FB21.2, P5.2
unnamed: FB22.2, P6.8
unnamed: FB23.2, P6.7
unnamed: FB24.2, P6.6
unnamed: FB25.2, P6.5
unnamed: FB26.2, P6.4
unnamed: FB27.2, P6.3
unnamed: FB28.2, P6.2
unnamed: FB29.2, P17.7
unnamed: FB30.2, P17.6
unnamed: FB31.2, P17.5
unnamed: FB32.2, P17.4
unnamed: FB33.2, P17.3
unnamed: FB34.2, P17.2
unnamed: FB35.2, P34.3
unnamed: FB36.2, P34.2
unnamed: P15.10 (GRNC), R5.1
unnamed: P15.11 (YELC), R8.1
USB_DC: P12.1 (VBUS); also elsewhere on the board
VCC: C3.1, D1.1 (K), FB2.1, FB9.1, FB16.1, FB23.1, P14.4 (VDD), P16.5, Q1.1 (G), R6.2, R10.1, R12.1; also elsewhere on the board
VDD_5V: D2.1 (K), D8.1 (K), FB1.1, FB8.1, FB15.1, FB22.1, FB29.1, FB35.1, R13.1; also elsewhere on the board
VDD_PHYA: R9.1; also elsewhere on the board

Notes on the sheet:
Interfaces
Feedback Input
Output
Wire such that they move in opposing directions
Power
User LEDs
eMMC
EPM/Servo
LCD
Stepper Drivers
μSD
Shift Registers
Unused on BBBW
39532-1002
4.2x2.1 mm
Potential 02X08 Connector: https://www.digikey.com/ product-detail/en/molex-llc/ 90130-3116/WM8266-ND/760978
Boot Configuration

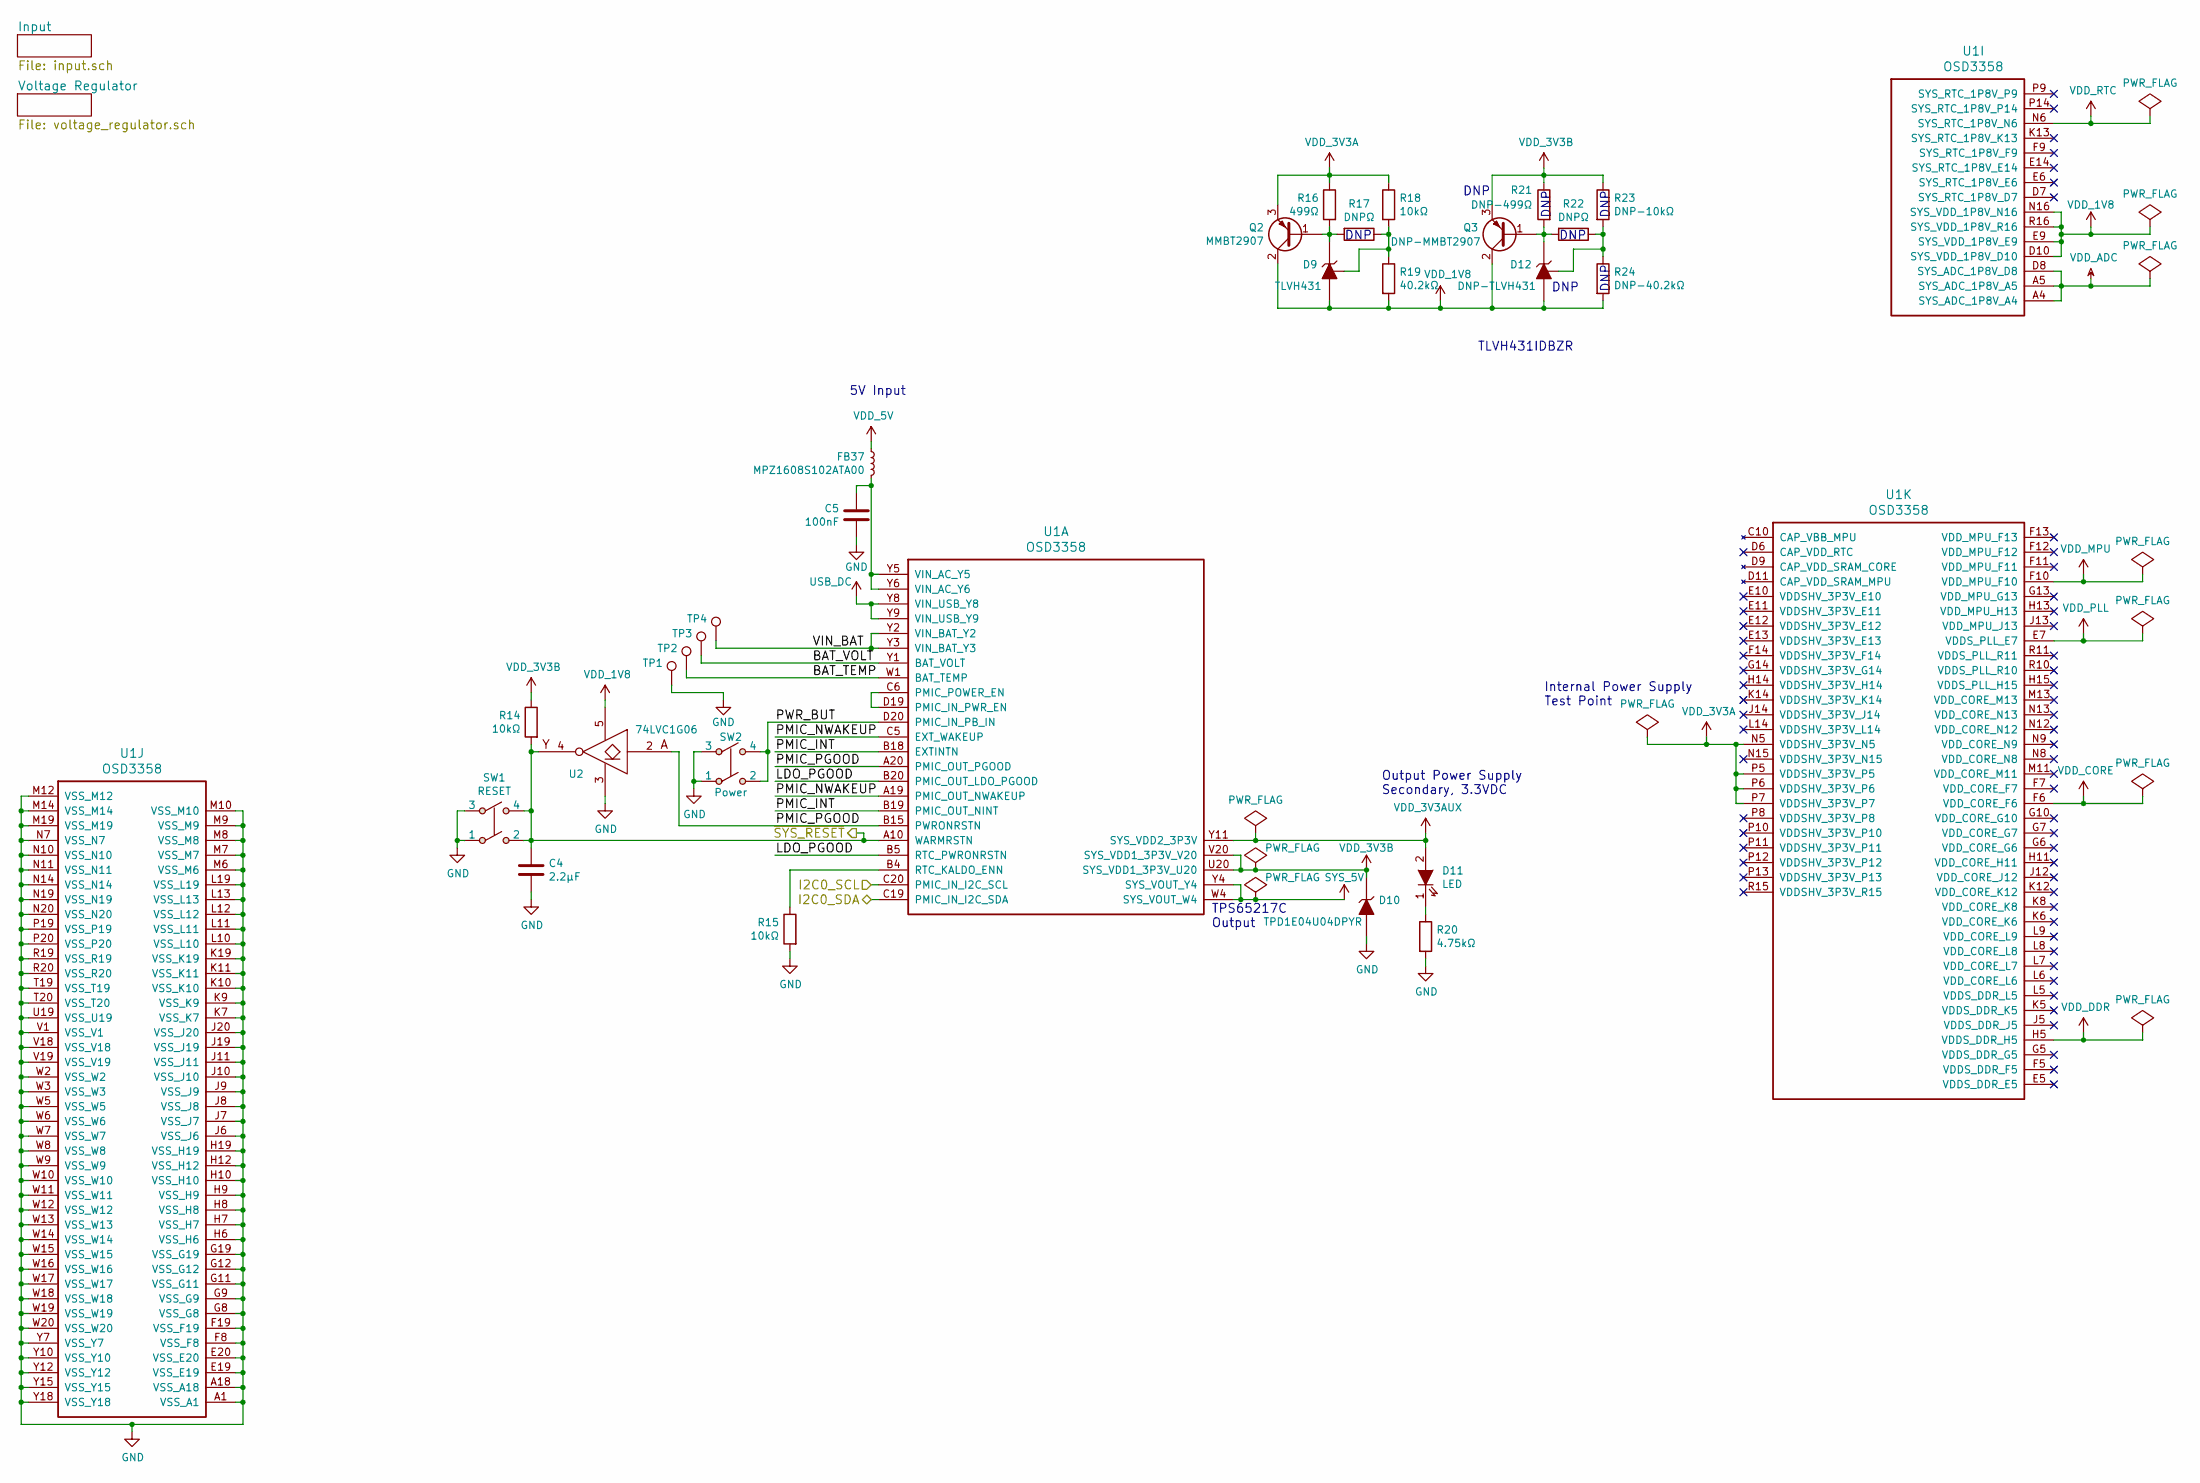
[picture p39: schematic power.sch]

Parts:
C4: 2.2μF; C_0603
C5: 100nF; C_0603
D9: TLVH431; SOT-23
D10: TPD1E04U04DPYR; TPD_PX1SON
D11: LED; LED_0603
D12: DNP-TLVH431; SOT-23
FB37: MPZ1608S102ATA00; Ferrite_Bead_0603
Q2: MMBT2907; SOT-23
Q3: DNP-MMBT2907; SOT-23
R14, R15, R18: 10kΩ; R_0603
R16: 499Ω; R_0603
R17, R22: DNPΩ; R_0603
R19: 40.2kΩ; R_0603
R20: 4.75kΩ; R_0603
R21: DNP-499Ω; R_0603
R23: DNP-10kΩ; R_0603
R24: DNP-40.2kΩ; R_0603
SW1: RESET; KMR_SW_SPST_EVQP7A
SW2: Power; KMR_SW_SPST_EVQP7A
TP1, TP2, TP3, TP4: Test_Point; Measurement_Point_Round-SMD-Pad_Small
U1: OSD3358; BGA-400-1-27mm
U2: 74LVC1G06; SC-70-5

Connections:
/I2C0_SDA: U1.C19 (PMIC_IN_I2C_SDA); also elsewhere on the board
/Power/BAT_TEMP: TP2.1, U1.W1 (BAT_TEMP)
/Power/BAT_VOLT: TP3.1, U1.Y1 (BAT_VOLT)
/Power/LDO_PGOOD: U1.B5 (RTC_PWRONRSTN), U1.B20 (PMIC_OUT_LDO_PGOOD)
/Power/PMIC_INT: U1.B18 (EXTINTN), U1.B19 (PMIC_OUT_NINT)
/Power/PMIC_NWAKEUP: U1.A19 (PMIC_OUT_NWAKEUP), U1.C5 (EXT_WAKEUP)
/Power/PMIC_PGOOD: U1.A20 (PMIC_OUT_PGOOD), U1.B15 (PWRONRSTN), U2.2
/Power/PWR_BUT: SW2.2, SW2.4, U1.D20 (PMIC_IN_PB_IN)
/Power/VIN_BAT: TP4.1, U1.Y2 (VIN_BAT_Y2), U1.Y3 (VIN_BAT_Y3)
/SIP_I2C0_SCL: U1.C20 (PMIC_IN_I2C_SCL); also elsewhere on the board
/~SYS_RESET: C4.1, R14.2, SW1.2, SW1.4, U1.A10 (WARMRSTN), U2.4; also elsewhere on the board
CGND: C4.2, C5.2, D10.2 (A), R15.2, R20.2, SW1.1, SW1.3, SW2.1, SW2.3, TP1.1, U1.A1 (VSS_A1), U1.A18 (VSS_A18), U1.E19 (VSS_E19), U1.E20 (VSS_E20), U1.F8 (VSS_F8), U1.F19 (VSS_F19), U1.G8 (VSS_G8), U1.G9 (VSS_G9), U1.G11 (VSS_G11), U1.G12 (VSS_G12), U1.G19 (VSS_G19), U1.H6 (VSS_H6), U1.H7 (VSS_H7), U1.H8 (VSS_H8), U1.H9 (VSS_H9), U1.H10 (VSS_H10), U1.H12 (VSS_H12), U1.H19 (VSS_H19), U1.J6 (VSS_J6), U1.J7 (VSS_J7), U1.J8 (VSS_J8), U1.J9 (VSS_J9), U1.J10 (VSS_J10), U1.J11 (VSS_J11), U1.J19 (VSS_J19), U1.J20 (VSS_J20), U1.K7 (VSS_K7), U1.K9 (VSS_K9), U1.K10 (VSS_K10), U1.K11 (VSS_K11), U1.K19 (VSS_K19), U1.L10 (VSS_L10), U1.L11 (VSS_L11), U1.L12 (VSS_L12), U1.L13 (VSS_L13), U1.L19 (VSS_L19), U1.M6 (VSS_M6), U1.M7 (VSS_M7), U1.M8 (VSS_M8), U1.M9 (VSS_M9), U1.M10 (VSS_M10), U1.M12 (VSS_M12), U1.M14 (VSS_M14), U1.M19 (VSS_M19), U1.N7 (VSS_N7), U1.N10 (VSS_N10), U1.N11 (VSS_N11), U1.N14 (VSS_N14), U1.N19 (VSS_N19), U1.N20 (VSS_N20), U1.P19 (VSS_P19), U1.P20 (VSS_P20), U1.R19 (VSS_R19), U1.R20 (VSS_R20), U1.T19 (VSS_T19), U1.T20 (VSS_T20), U1.U19 (VSS_U19), U1.V1 (VSS_V1), U1.V18 (VSS_V18), U1.V19 (VSS_V19), U1.W2 (VSS_W2), U1.W3 (VSS_W3), U1.W5 (VSS_W5), U1.W6 (VSS_W6), U1.W7 (VSS_W7), U1.W8 (VSS_W8), U1.W9 (VSS_W9), U1.W10 (VSS_W10), U1.W11 (VSS_W11), U1.W12 (VSS_W12), U1.W13 (VSS_W13), U1.W14 (VSS_W14), U1.W15 (VSS_W15), U1.W16 (VSS_W16), U1.W17 (VSS_W17), U1.W18 (VSS_W18), U1.W19 (VSS_W19), U1.W20 (VSS_W20), U1.Y7 (VSS_Y7), U1.Y10 (VSS_Y10), U1.Y12 (VSS_Y12), U1.Y15 (VSS_Y15), U1.Y18 (VSS_Y18), U2.3; also elsewhere on the board
unnamed: C5.1, FB37.1, U1.Y5 (VIN_AC_Y5), U1.Y6 (VIN_AC_Y6)
unnamed: D9.1 (K), Q2.1 (B), R16.2, R17.2
unnamed: D9.3, R17.1, R18.2, R19.1
unnamed: D11.1 (K), R20.1
unnamed: D12.1 (K), Q3.1 (B), R21.2, R22.2
unnamed: D12.3, R22.1, R23.2, R24.1
unnamed: R15.1, U1.B4 (RTC_KALDO_ENN)
unnamed: U1.C6 (PMIC_POWER_EN), U1.D19 (PMIC_IN_PWR_EN)
SYS_5V: U1.W4 (SYS_VOUT_W4), U1.Y4 (SYS_VOUT_Y4); also elsewhere on the board
USB_DC: U1.Y8 (VIN_USB_Y8), U1.Y9 (VIN_USB_Y9); also elsewhere on the board
VCC: D10.1 (K), Q3.3 (E), R14.1, R21.1, R23.1, U1.U20 (SYS_VDD1_3P3V_U20), U1.V20 (SYS_VDD1_3P3V_V20); also elsewhere on the board
VDD_1V8: D9.2 (A), D12.2 (A), Q2.2 (C), Q3.2 (C), R19.2, R24.2, U1.D10 (SYS_VDD_1P8V_D10), U1.E9 (SYS_VDD_1P8V_E9), U1.N16 (SYS_VDD_1P8V_N16), U1.R16 (SYS_VDD_1P8V_R16), U2.5
VDD_3V3A: Q2.3 (E), R16.1, R18.1, U1.N5 (VDDSHV_3P3V_N5), U1.P5 (VDDSHV_3P3V_P5), U1.P6 (VDDSHV_3P3V_P6), U1.P7 (VDDSHV_3P3V_P7)
VDD_3V3AUX: D11.2 (A), U1.Y11 (SYS_VDD2_3P3V)
VDD_5V: FB37.2; also elsewhere on the board
VDD_ADC: U1.A4 (SYS_ADC_1P8V_A4), U1.A5 (SYS_ADC_1P8V_A5), U1.D8 (SYS_ADC_1P8V_D8); also elsewhere on the board
VDD_CORE: U1.F6 (VDD_CORE_F6)
VDD_DDR: U1.H5 (VDDS_DDR_H5)
VDD_MPU: U1.F10 (VDD_MPU_F10)
VDD_PLL: U1.E7 (VDDS_PLL_E7)
VDD_RTC: U1.N6 (SYS_RTC_1P8V_N6)

Notes on the sheet:
5V Input
Internal Power Supply Test Point
Output Power Supply Secondary, 3.3VDC
TPS65217C Output
DNP
TLVH431IDBZR

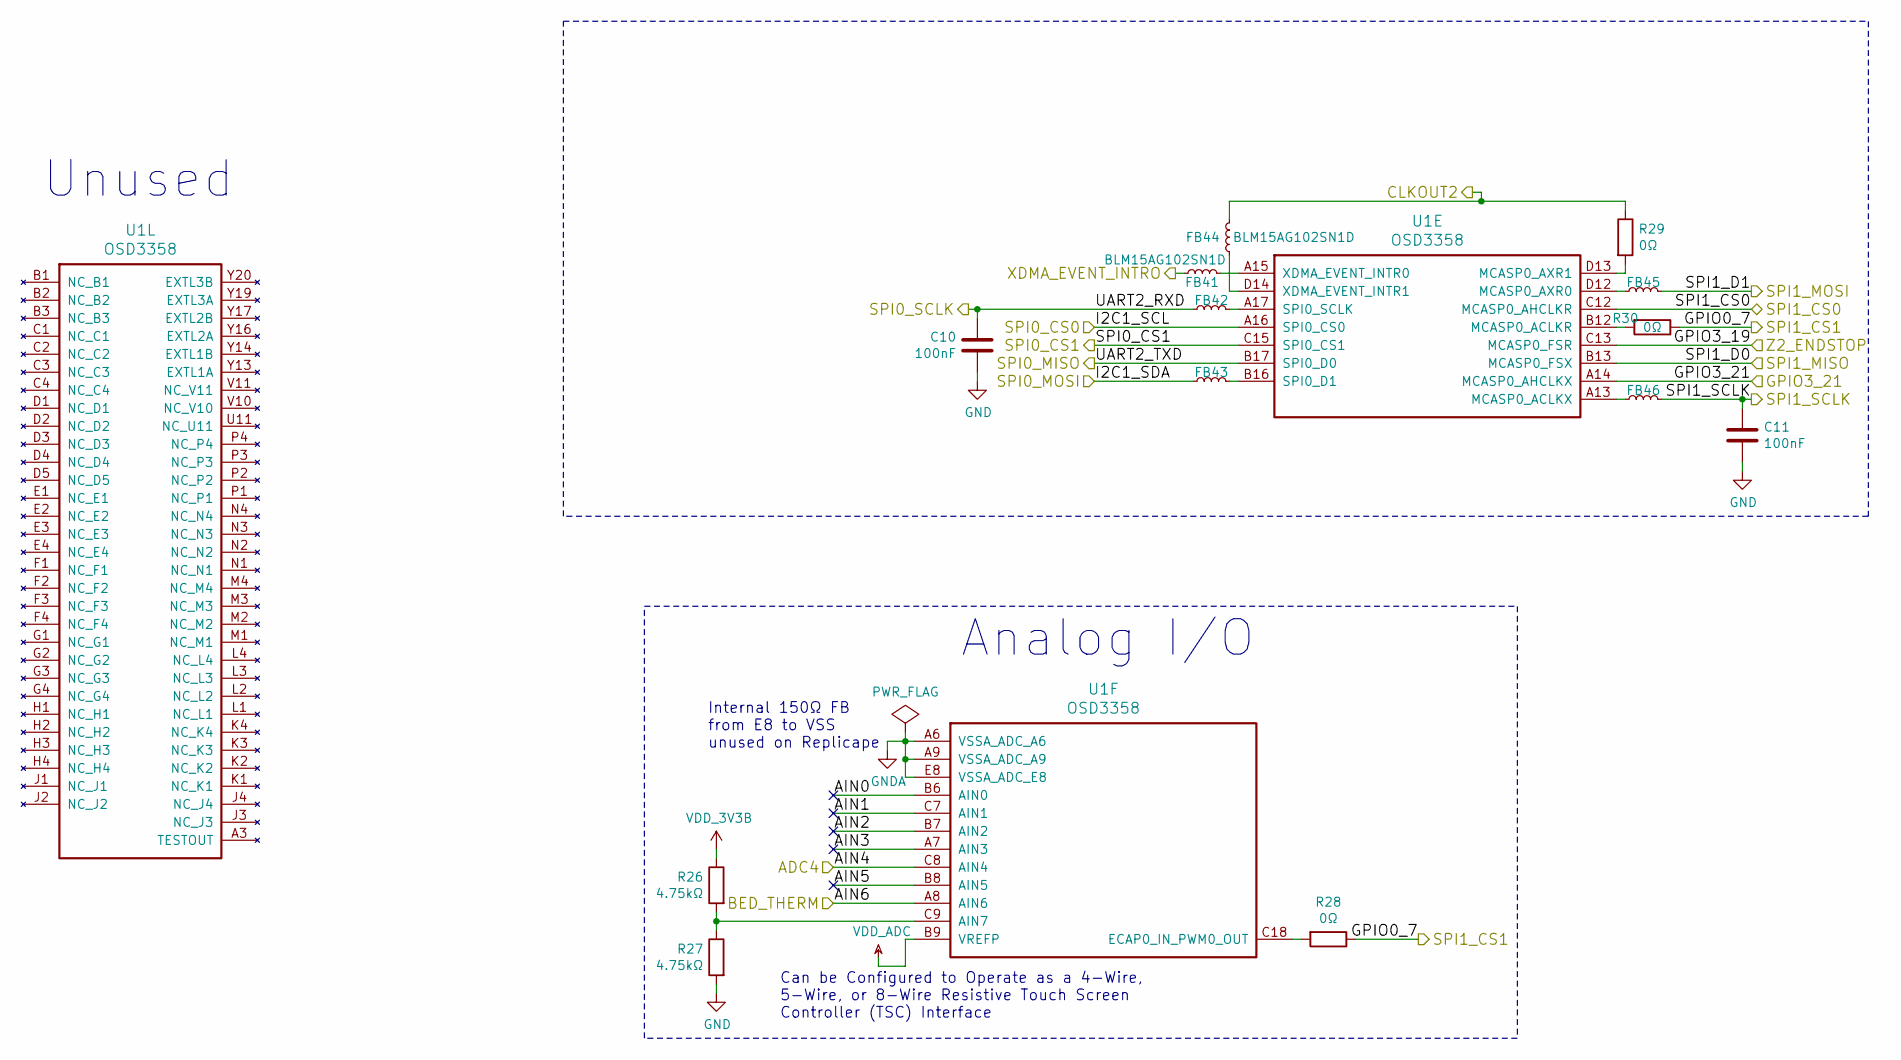
[picture p40: schematic mpu.sch]

Parts:
C10, C11: 100nF; C_0603
FB41, FB44: BLM15AG102SN1D; R_0402
FB42, FB43, FB45, FB46: MMZ1608A252BTA00; Ferrite_Bead_0603
R26, R27: 4.75kΩ; R_0603
R28, R29, R30: 0Ω; R_0603
U1: OSD3358; BGA-400-1-27mm

Connections:
/ADC: U1.C8 (AIN4); also elsewhere on the board
/BED_THERM: U1.A8 (AIN6); also elsewhere on the board
/CLKOUT2: FB44.1, R29.1; also elsewhere on the board
/Microprocessor/AIN0: U1.B6 (AIN0)
/Microprocessor/AIN1: U1.C7 (AIN1)
/Microprocessor/AIN2: U1.B7 (AIN2)
/Microprocessor/AIN3: U1.A7 (AIN3)
/Microprocessor/AIN5: U1.B8 (AIN5)
/SD.CD: U1.C15 (SPI0_CS1); also elsewhere on the board
/SPI0_CS0: U1.A16 (SPI0_CS0); also elsewhere on the board
/SPI0_MISO: U1.B17 (SPI0_D0); also elsewhere on the board
/SPI0_MOSI: FB43.1; also elsewhere on the board
/SPI0_SCLK: C10.1, FB42.1; also elsewhere on the board
/SPI1_CS0: U1.C12 (MCASP0_AHCLKR); also elsewhere on the board
/SPI1_CS1: R28.1, R30.1; also elsewhere on the board
/SPI1_MISO: U1.B13 (MCASP0_FSX); also elsewhere on the board
/SPI1_MOSI: FB45.2; also elsewhere on the board
/SPI1_SCLK: C11.1, FB46.2; also elsewhere on the board
/X1_ENDSTOP: U1.A14 (MCASP0_AHCLKX); also elsewhere on the board
/XDMA_EVENT_INTRO: FB41.2; also elsewhere on the board
/Z2_ENDSTOP: U1.C13 (MCASP0_FSR); also elsewhere on the board
CGND: C10.2, C11.2, R27.2; also elsewhere on the board
GNDA: U1.A6 (VSSA_ADC_A6), U1.A9 (VSSA_ADC_A9), U1.E8 (VSSA_ADC_E8)
unnamed: FB41.1, U1.A15 (XDMA_EVENT_INTR0)
unnamed: FB42.2, U1.A17 (SPI0_SCLK)
unnamed: FB43.2, U1.B16 (SPI0_D1)
unnamed: FB44.2, U1.D14 (XDMA_EVENT_INTR1)
unnamed: FB45.1, U1.D12 (MCASP0_AXR0)
unnamed: FB46.1, U1.A13 (MCASP0_ACLKX)
unnamed: R26.2, R27.1, U1.C9 (AIN7)
unnamed: R28.2, U1.C18 (ECAP0_IN_PWM0_OUT)
unnamed: R29.2, U1.D13 (MCASP0_AXR1)
unnamed: R30.2, U1.B12 (MCASP0_ACLKR)
VCC: R26.1; also elsewhere on the board
VDD_ADC: U1.B9 (VREFP); also elsewhere on the board

Notes on the sheet:
Analog I/O
Unused
Internal 150Ω FB from E8 to VSS unused on Replicape
Can be Configured to Operate as a 4-Wire, 5-Wire, or 8-Wire Resistive Touch Screen Controller (TSC) Interface
