gralco/cimarron/KiMBo/KiMBo.kicad_pcb

## KiCad design KiMBo/KiMBo.kicad_pcb (continued)

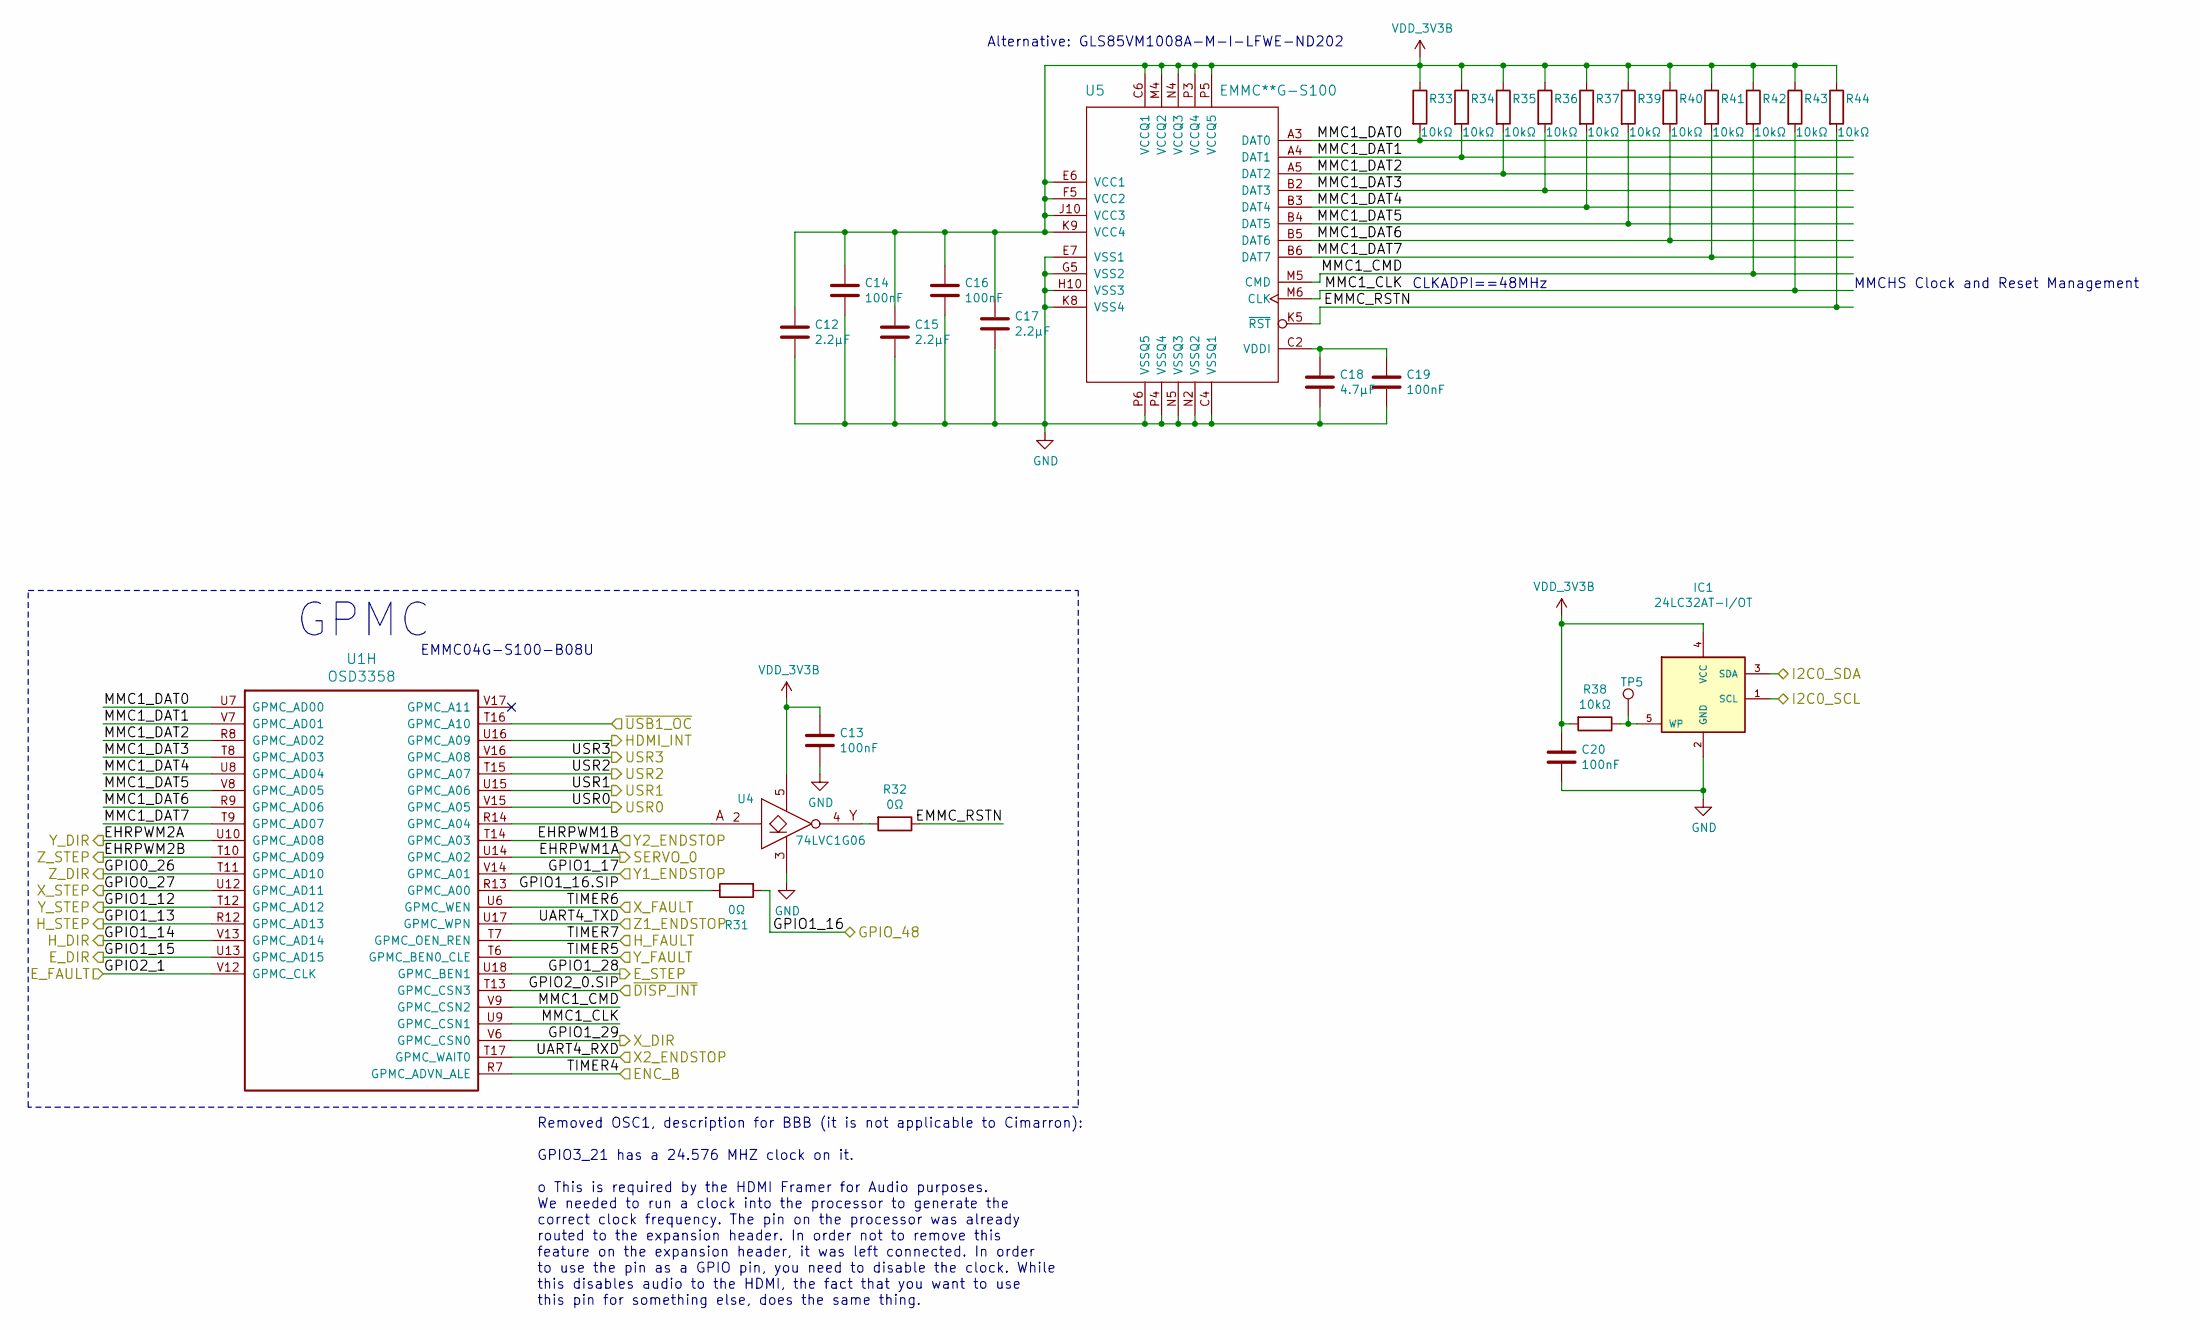
[picture p41: schematic flash.sch]

Parts:
C12, C15, C17: 2.2μF; C_0805
C13, C14, C16, C19, C20: 100nF; C_0603
C18: 4.7μF; C_0805
IC1: 24LC32AT-I/OT; SOT-23-5
R31, R32: 0Ω; R_0603
R33, R34, R35, R36, R37, R38, R39, R40, R41, R42, R43, R44: 10kΩ; R_0603
TP5: Test_Point; Measurement_Point_Round-SMD-Pad_Small
U1: OSD3358; BGA-400-1-27mm
U4: 74LVC1G06; SC-70-5
U5: EMMC**G-S100; EMMCxxG-S100

Connections:
/ENC_A: R31.2; also elsewhere on the board
/ENC_B: U1.R7 (GPMC_ADVN_ALE); also elsewhere on the board
/E_DIR: U1.U13 (GPMC_AD15); also elsewhere on the board
/E_FAULT: U1.V12 (GPMC_CLK); also elsewhere on the board
/E_STEP: U1.U18 (GPMC_BEN1); also elsewhere on the board
/Flash/EMMC_RSTN: R32.1, R44.2, U5.K5 (~RST)
/Flash/GPIO1_16.SIP: R31.1, U1.R13 (GPMC_A00)
/Flash/MMC1_CLK: R43.2, U1.U9 (GPMC_CSN1), U5.M6 (CLK), U5.M7 (NC), U5.N8 (NC), U5.P9 (NC)
/Flash/MMC1_CMD: R42.2, U1.V9 (GPMC_CSN2), U5.M5 (CMD), U5.N6 (NC), U5.N7 (NC), U5.P8 (NC)
/Flash/MMC1_DAT0: R33.2, U1.U7 (GPMC_AD00), U5.A3 (DAT0)
/Flash/MMC1_DAT1: R34.2, U1.V7 (GPMC_AD01), U5.A4 (DAT1)
/Flash/MMC1_DAT2: R35.2, U1.R8 (GPMC_AD02), U5.A5 (DAT2)
/Flash/MMC1_DAT3: R36.2, U1.T8 (GPMC_AD03), U5.A1 (NC), U5.B2 (DAT3)
/Flash/MMC1_DAT4: R37.2, U1.U8 (GPMC_AD04), U5.A2 (NC), U5.B3 (DAT4)
/Flash/MMC1_DAT5: R39.2, U1.V8 (GPMC_AD05), U5.B4 (DAT5), U5.C3 (NC), U5.D1 (NC), U5.D2 (NC)
/Flash/MMC1_DAT6: R40.2, U1.R9 (GPMC_AD06), U5.B5 (DAT6), U5.C5 (NC), U5.D4 (NC), U5.E3 (NC), U5.F2 (NC), U5.G1 (NC)
/Flash/MMC1_DAT7: R41.2, U1.T9 (GPMC_AD07), U5.A8 (NC), U5.B6 (DAT7), U5.B7 (NC)
/HDMI_INT: U1.U16 (GPMC_A09)
/H_DIR: U1.V13 (GPMC_AD14); also elsewhere on the board
/H_FAULT: U1.T7 (GPMC_OEN_REN); also elsewhere on the board
/H_STEP: U1.R12 (GPMC_AD13); also elsewhere on the board
/I2C0_SCL: IC1.1 (SCL); also elsewhere on the board
/I2C0_SDA: IC1.3 (SDA); also elsewhere on the board
/SERVO_0: U1.U14 (GPMC_A02); also elsewhere on the board
/USR0: U1.V15 (GPMC_A05); also elsewhere on the board
/USR1: U1.U15 (GPMC_A06); also elsewhere on the board
/USR2: U1.T15 (GPMC_A07); also elsewhere on the board
/USR3: U1.V16 (GPMC_A08); also elsewhere on the board
/X2_ENDSTOP: U1.T17 (GPMC_WAIT0); also elsewhere on the board
/X_DIR: U1.V6 (GPMC_CSN0); also elsewhere on the board
/X_FAULT: U1.U6 (GPMC_WEN); also elsewhere on the board
/X_STEP: U1.U12 (GPMC_AD11); also elsewhere on the board
/Y1_ENDSTOP: U1.V14 (GPMC_A01); also elsewhere on the board
/Y2_ENDSTOP: U1.T14 (GPMC_A03); also elsewhere on the board
/Y_DIR: U1.U10 (GPMC_AD08); also elsewhere on the board
/Y_FAULT: U1.T6 (GPMC_BEN0_CLE); also elsewhere on the board
/Y_STEP: U1.T12 (GPMC_AD12); also elsewhere on the board
/Z1_ENDSTOP: U1.U17 (GPMC_WPN); also elsewhere on the board
/Z_DIR: U1.T11 (GPMC_AD10); also elsewhere on the board
/Z_STEP: U1.T10 (GPMC_AD09); also elsewhere on the board
/~DISP_INT: U1.T13 (GPMC_CSN3); also elsewhere on the board
/~USB1_OC: U1.T16 (GPMC_A10); also elsewhere on the board
CGND: C12.2, C13.2, C14.2, C15.2, C16.2, C17.2, C18.2, C19.2, C20.2, IC1.2 (GND), U4.3, U5.C4 (VSSQ1), U5.D3 (NC), U5.E1 (NC), U5.E2 (NC), U5.E7 (VSS1), U5.G5 (VSS2), U5.H10 (VSS3), U5.K8 (VSS4), U5.N2 (VSSQ2), U5.N5 (VSSQ3), U5.P2 (NC), U5.P4 (VSSQ4), U5.P6 (VSSQ5); also elsewhere on the board
unnamed: C18.1, C19.1, U5.C1 (NC), U5.C2 (VDDI)
unnamed: IC1.5 (WP), R38.1, TP5.1
unnamed: R32.2, U4.4
unnamed: U1.R14 (GPMC_A04), U4.2
VCC: C12.1, C13.1, C14.1, C15.1, C16.1, C17.1, C20.1, IC1.4 (VCC), R33.1, R34.1, R35.1, R36.1, R37.1, R38.2, R39.1, R40.1, R41.1, R42.1, R43.1, R44.1, U4.5, U5.A9 (NC), U5.B8 (NC), U5.C6 (VCCQ1), U5.C7 (NC), U5.E6 (VCC1), U5.F5 (VCC2), U5.J10 (VCC3), U5.K9 (VCC4), U5.M4 (VCCQ2), U5.N4 (VCCQ3), U5.P3 (VCCQ4), U5.P5 (VCCQ5); also elsewhere on the board

Notes on the sheet:
GPMC
EMMC04G-S100-B08U
Alternative: GLS85VM1008A-M-I-LFWE-ND202
CLKADPI==48MHz
Removed OSC1, description for BBB (it is not applicable to Cimarron): GPIO3_21 has a 24.576 MHZ clock on it. o This is required by the HDMI Framer for Audio purposes. We needed to run a clock into the processor to generate the correct clock frequency. The pin on the processor was already routed to 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
MMCHS Clock and Reset Management

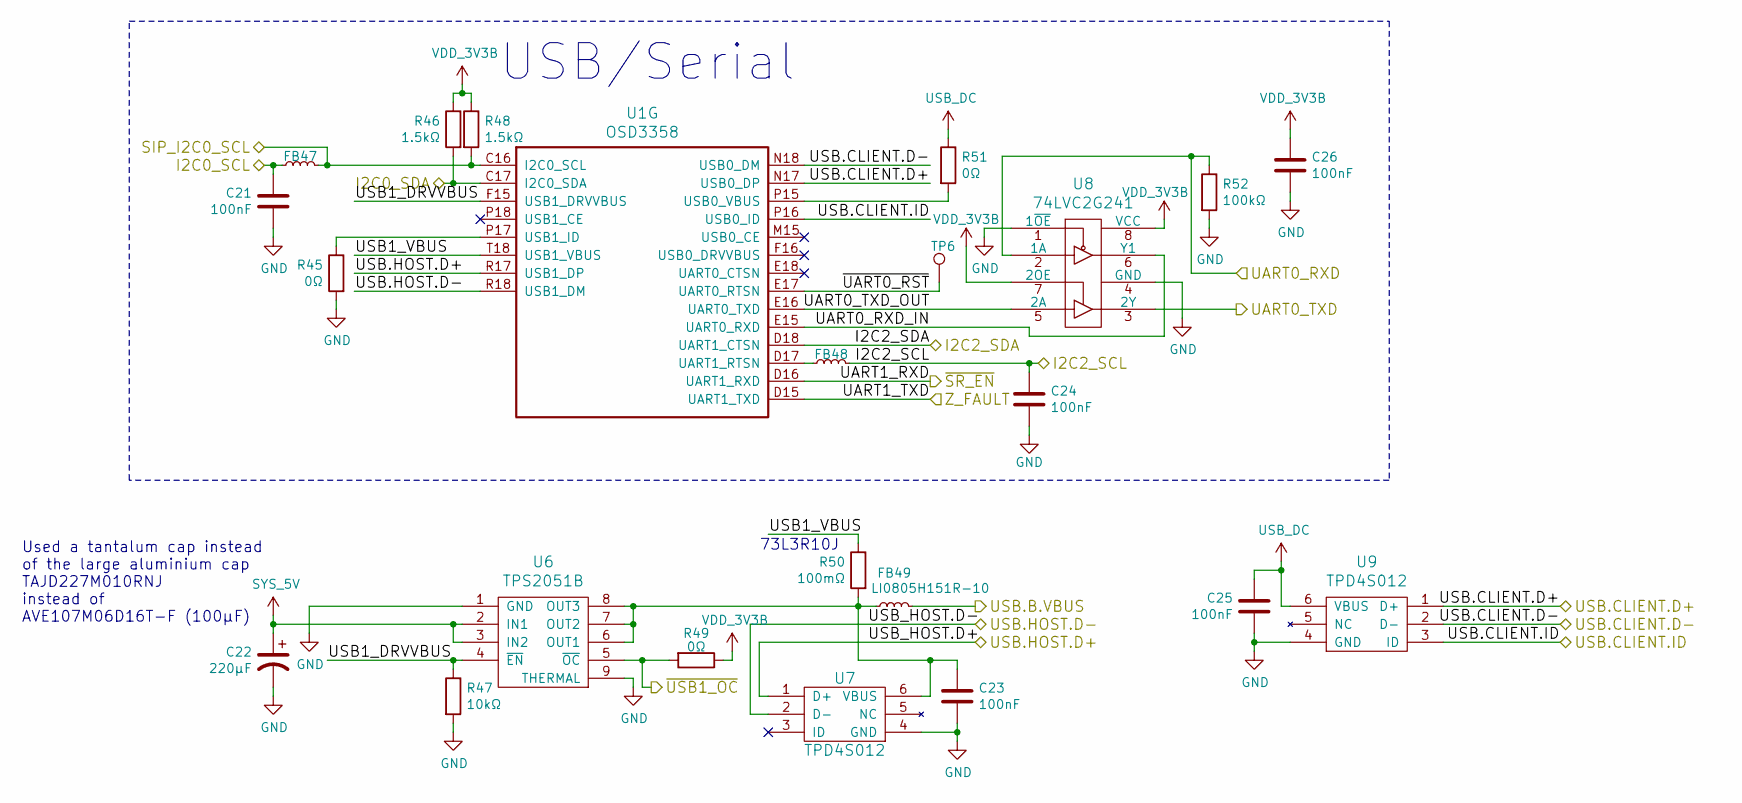
[picture p42: schematic usb.sch]

Parts:
C21, C23, C24, C25, C26: 100nF; C_0603
C22: 220μF; TantalC_SizeD_EIA-7343_Reflow
FB47, FB48: MMZ1608A252BTA00; Ferrite_Bead_0603
FB49: LI0805H151R-10; R_0805
R45, R49, R51: 0Ω; R_0603
R46, R48: 1.5kΩ; R_0603
R47: 10kΩ; R_0603
R50: 100mΩ; R_0603
R52: 100kΩ; R_0603
TP6: Test_Point; Measurement_Point_Round-SMD-Pad_Small
U1: OSD3358; BGA-400-1-27mm
U6: TPS2051B; DGN-MSOP-8_3x3mm_Pitch0.65mm
U7, U9: TPD4S012; DRY-DFN-6-1EP_2x2mm_Pitch0.5mm
U8: 74LVC2G241; DCT-MSOP-8_3x3mm_Pitch0.65mm

Connections:
/I2C0_SCL: C21.1, FB47.2; also elsewhere on the board
/I2C0_SDA: R46.2, U1.C17 (I2C0_SDA); also elsewhere on the board
/I2C2_SCL: C24.1, FB48.1; also elsewhere on the board
/I2C2_SDA: U1.D18 (UART1_CTSN); also elsewhere on the board
/SIP_I2C0_SCL: FB47.1, R48.2, U1.C16 (I2C0_SCL); also elsewhere on the board
/USB/UART0_RXD: R52.1, U8.2 (1A); also elsewhere on the board
/USB/UART0_RXD_IN: U1.E15 (UART0_RXD), U8.6 (Y1)
/USB/UART0_TXD: U8.3 (2Y); also elsewhere on the board
/USB/UART0_TXD_OUT: U1.E16 (UART0_TXD), U8.5 (2A)
/USB/USB1_DRVVBUS: R47.1, U1.F15 (USB1_DRVVBUS), U6.4 (~EN)
/USB/USB1_VBUS: R50.1, U1.T18 (USB1_VBUS)
/USB/USB.B.VBUS: FB49.2; also elsewhere on the board
/USB/USB.CLIENT.D+: U1.N17 (USB0_DP), U9.1 (D+); also elsewhere on the board
/USB/USB.CLIENT.D-: U1.N18 (USB0_DM), U9.2 (D-); also elsewhere on the board
/USB/USB.CLIENT.ID: U1.P16 (USB0_ID), U9.3 (ID); also elsewhere on the board
/USB/USB.HOST.D+: U1.R17 (USB1_DP), U7.1 (D+); also elsewhere on the board
/USB/USB.HOST.D-: U1.R18 (USB1_DM), U7.2 (D-); also elsewhere on the board
/USB/~UART0_RST: TP6.1, U1.E17 (UART0_RTSN)
/Z_FAULT: U1.D15 (UART1_TXD); also elsewhere on the board
/~SR_EN: U1.D16 (UART1_RXD); also elsewhere on the board
/~USB1_OC: R49.2, U6.5 (~OC); also elsewhere on the board
CGND: C21.2, C22.2, C23.2, C24.2, C25.2, C26.2, R45.2, R47.2, R52.2, U6.1 (GND), U6.9 (THERMAL), U7.4 (GND), U8.1 (1~OE), U8.4 (GND), U9.4 (GND); also elsewhere on the board
unnamed: C23.1, FB49.1, R50.2, U6.6 (OUT1), U6.7 (OUT2), U6.8 (OUT3), U7.6 (VBUS)
unnamed: FB48.2, U1.D17 (UART1_RTSN)
unnamed: R45.1, U1.P17 (USB1_ID)
unnamed: R51.2, U1.P15 (USB0_VBUS)
SYS_5V: C22.1, U6.2 (IN1), U6.3 (IN2); also elsewhere on the board
USB_DC: C25.1, R51.1, U9.6 (VBUS); also elsewhere on the board
VCC: C26.1, R46.1, R48.1, R49.1, U8.7 (2OE), U8.8 (VCC); also elsewhere on the board

Notes on the sheet:
USB/Serial
Used a tantalum cap instead of the large aluminium cap TAJD227M010RNJ instead of AVE107M06D16T-F (100μF)
73L3R10J

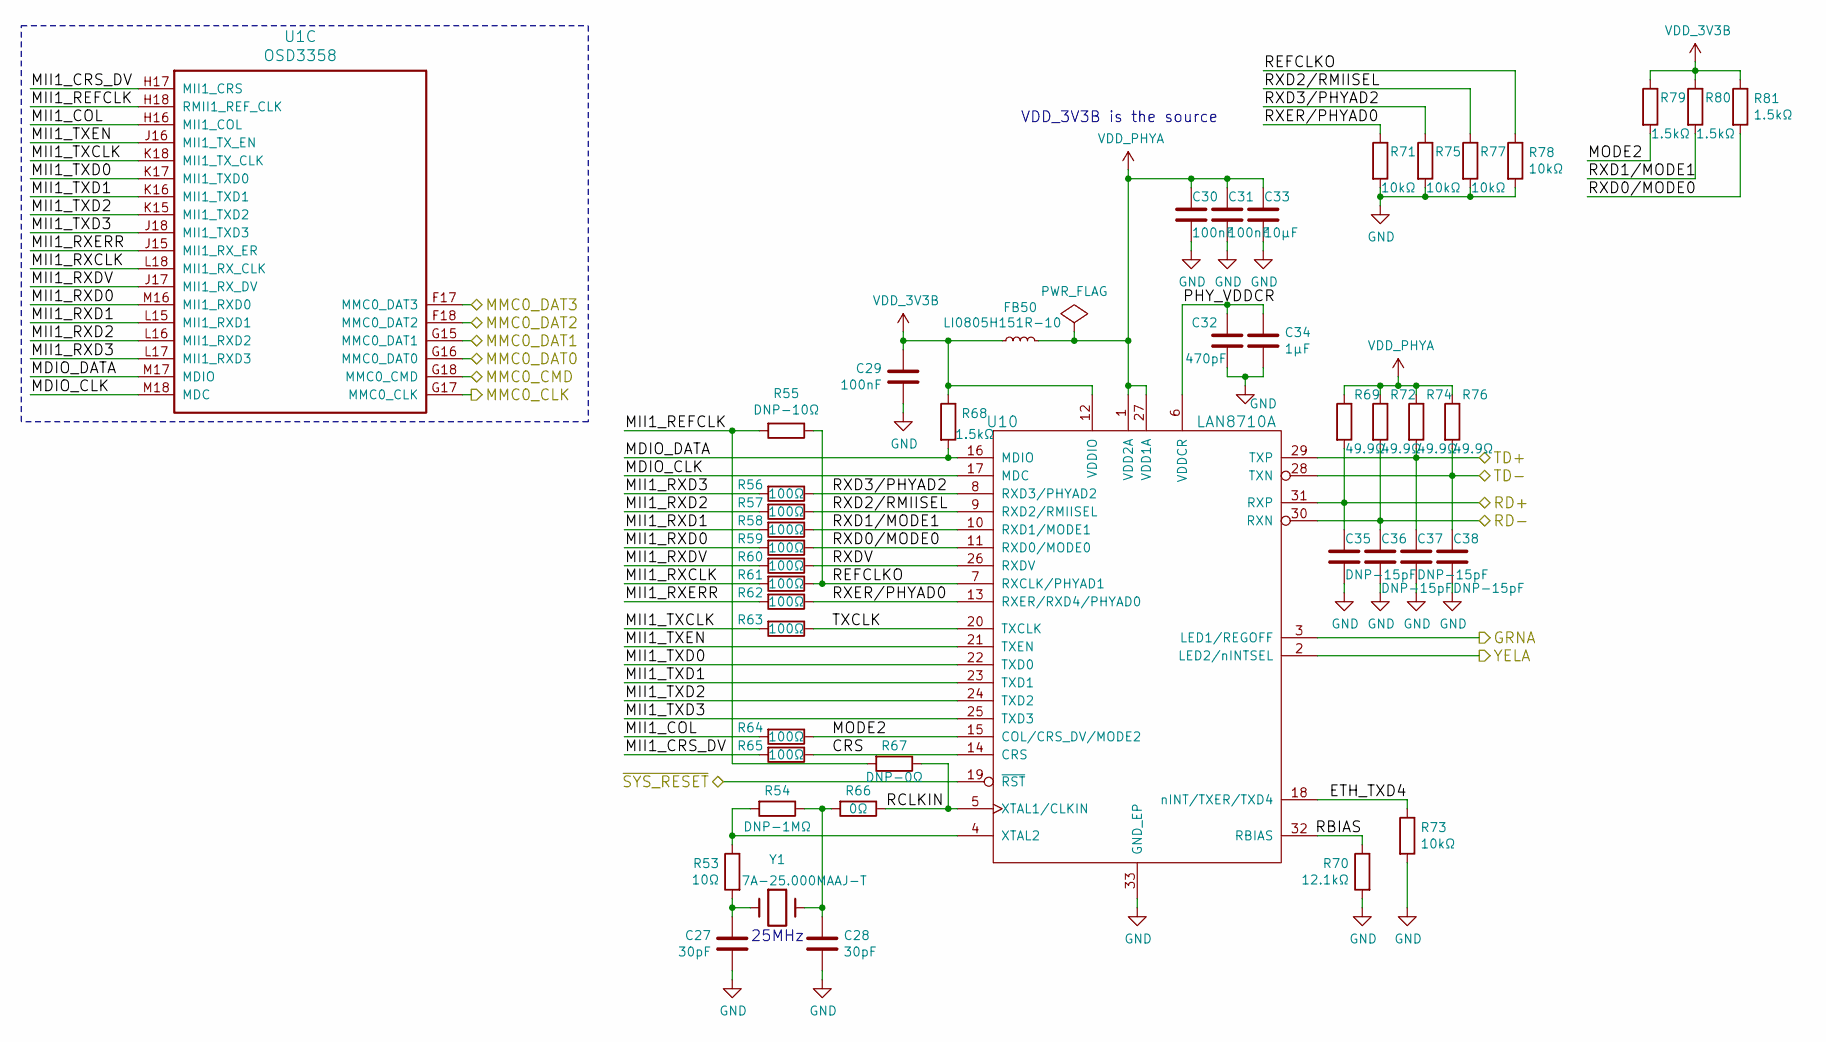
[picture p43: schematic eth.sch]

Parts:
C27, C28: 30pF; C_0603
C29, C30, C31: 100nF; C_0603
C32: 470pF; C_0603
C33: 10μF; C_0805
C34: 1μF; C_0603
C35, C36, C37, C38: DNP-15pF; C_0603
FB50: LI0805H151R-10; R_0805
R53: 10Ω; R_0603
R54: DNP-1MΩ; R_0603
R55: DNP-10Ω; R_0603
R56, R57, R58, R59, R60, R61, R62, R63, R64, R65: 100Ω; R_0603
R66: 0Ω; R_0603
R67: DNP-0Ω; R_0603
R68, R79, R80, R81: 1.5kΩ; R_0603
R69, R72, R74, R76: 49.9Ω; R_0603
R70: 12.1kΩ; R_0603
R71, R73, R75, R77, R78: 10kΩ; R_0603
U1: OSD3358; BGA-400-1-27mm
U10: LAN8710A; QFN-32-1EP_5x5mm_Pitch0.5mm
Y1: 7A-25.000MAAJ-T; Crystal_SMD_7A_2Pads

Connections:
/Ethernet/CRS: R65.1, U10.14 (CRS)
/Ethernet/ETH_TXD4: R73.1, U10.18 (nINT/TXER/TXD4)
/Ethernet/GRNA: U10.3 (LED1/REGOFF); also elsewhere on the board
/Ethernet/MDIO_CLK: U1.M18 (MDC), U10.17 (MDC)
/Ethernet/MDIO_DATA: R68.2, U1.M17 (MDIO), U10.16 (MDIO)
/Ethernet/MII1_COL: R64.2, U1.H16 (MII1_COL)
/Ethernet/MII1_CRS_DV: R65.2, U1.H17 (MII1_CRS)
/Ethernet/MII1_REFCLK: R55.2, R67.2, U1.H18 (RMII1_REF_CLK)
/Ethernet/MII1_RXCLK: R61.2, U1.L18 (MII1_RX_CLK)
/Ethernet/MII1_RXD0: R59.2, U1.M16 (MII1_RXD0)
/Ethernet/MII1_RXD1: R58.2, U1.L15 (MII1_RXD1)
/Ethernet/MII1_RXD2: R57.2, U1.L16 (MII1_RXD2)
/Ethernet/MII1_RXD3: R56.2, U1.L17 (MII1_RXD3)
/Ethernet/MII1_RXDV: R60.2, U1.J17 (MII1_RX_DV)
/Ethernet/MII1_RXERR: R62.2, U1.J15 (MII1_RX_ER)
/Ethernet/MII1_TXCLK: R63.2, U1.K18 (MII1_TX_CLK)
/Ethernet/MII1_TXD0: U1.K17 (MII1_TXD0), U10.22 (TXD0)
/Ethernet/MII1_TXD1: U1.K16 (MII1_TXD1), U10.23 (TXD1)
/Ethernet/MII1_TXD2: U1.K15 (MII1_TXD2), U10.24 (TXD2)
/Ethernet/MII1_TXD3: U1.J18 (MII1_TXD3), U10.25 (TXD3)
/Ethernet/MII1_TXEN: U1.J16 (MII1_TX_EN), U10.21 (TXEN)
/Ethernet/MODE2: R64.1, R79.2, U10.15 (COL/CRS_DV/MODE2)
/Ethernet/PHY_VDDCR: C32.1, C34.1, U10.6 (VDDCR)
/Ethernet/RBIAS: R70.1, U10.32 (RBIAS)
/Ethernet/RCLKIN: R66.1, R67.1, U10.5 (XTAL1/CLKIN)
/Ethernet/RD+: C35.1, R69.2, U10.31 (RXP); also elsewhere on the board
/Ethernet/RD-: C36.1, R72.2, U10.30 (RXN); also elsewhere on the board
/Ethernet/REFCLKO: R55.1, R61.1, R78.1, U10.7 (RXCLK/PHYAD1)
/Ethernet/RXD0/MODE0: R59.1, R81.2, U10.11 (RXD0/MODE0)
/Ethernet/RXD1/MODE1: R58.1, R80.2, U10.10 (RXD1/MODE1)
/Ethernet/RXD2/RMIISEL: R57.1, R77.1, U10.9 (RXD2/RMIISEL)
/Ethernet/RXD3/PHYAD2: R56.1, R75.1, U10.8 (RXD3/PHYAD2)
/Ethernet/RXDV: R60.1, U10.26 (RXDV)
/Ethernet/RXER/PHYAD0: R62.1, R71.1, U10.13 (RXER/RXD4/PHYAD0)
/Ethernet/TD+: C37.1, R74.2, U10.29 (TXP); also elsewhere on the board
/Ethernet/TD-: C38.1, R76.2, U10.28 (TXN); also elsewhere on the board
/Ethernet/TXCLK: R63.1, U10.20 (TXCLK)
/Ethernet/YELA: U10.2 (LED2/nINTSEL); also elsewhere on the board
/MMC0_CLK: U1.G17 (MMC0_CLK); also elsewhere on the board
/MMC0_CMD: U1.G18 (MMC0_CMD); also elsewhere on the board
/MMC0_DAT0: U1.G16 (MMC0_DAT0); also elsewhere on the board
/MMC0_DAT1: U1.G15 (MMC0_DAT1); also elsewhere on the board
/MMC0_DAT2: U1.F18 (MMC0_DAT2); also elsewhere on the board
/MMC0_DAT3: U1.F17 (MMC0_DAT3); also elsewhere on the board
/~SYS_RESET: U10.19 (~RST); also elsewhere on the board
CGND: C27.2, C28.2, C29.2, C30.2, C31.2, C32.2, C33.2, C34.2, C35.2, C36.2, C37.2, C38.2, R70.2, R71.2, R73.2, R75.2, R77.2, R78.2, U10.33 (GND_EP); also elsewhere on the board
unnamed: C27.1, R53.2, Y1.1
unnamed: C28.1, R54.1, R66.2, Y1.2
unnamed: R53.1, R54.2, U10.4 (XTAL2)
VCC: C29.1, FB50.1, R68.1, R79.1, R80.1, R81.1, U10.12 (VDDIO); also elsewhere on the board
VDD_PHYA: C30.1, C31.1, C33.1, FB50.2, R69.1, R72.1, R74.1, R76.1, U10.1 (VDD2A), U10.27 (VDD1A); also elsewhere on the board

Notes on the sheet:
VDD_3V3B is the source
25MHz

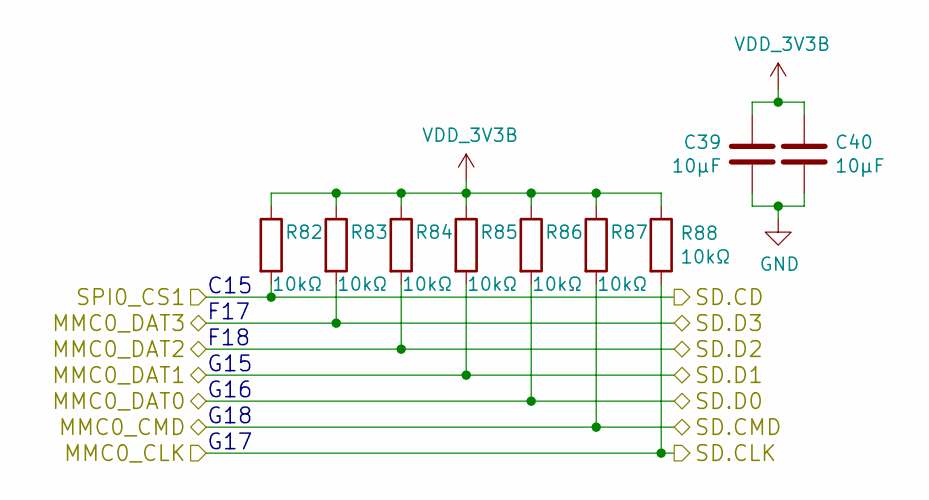
[picture p44: schematic sd.sch]

Parts:
C39, C40: 10μF; C_0603
R82, R83, R84, R85, R86, R87, R88: 10kΩ; R_0603

Connections:
/MMC0_CLK: R88.2; also elsewhere on the board
/MMC0_CMD: R87.2; also elsewhere on the board
/MMC0_DAT0: R86.2; also elsewhere on the board
/MMC0_DAT1: R85.2; also elsewhere on the board
/MMC0_DAT2: R84.2; also elsewhere on the board
/MMC0_DAT3: R83.2; also elsewhere on the board
/SD.CD: R82.2; also elsewhere on the board
CGND: C39.2, C40.2; also elsewhere on the board
VCC: C39.1, C40.1, R82.1, R83.1, R84.1, R85.1, R86.1, R87.1, R88.1; also elsewhere on the board

Notes on the sheet:
C15
F17
F18
G15
G16
G18
G17

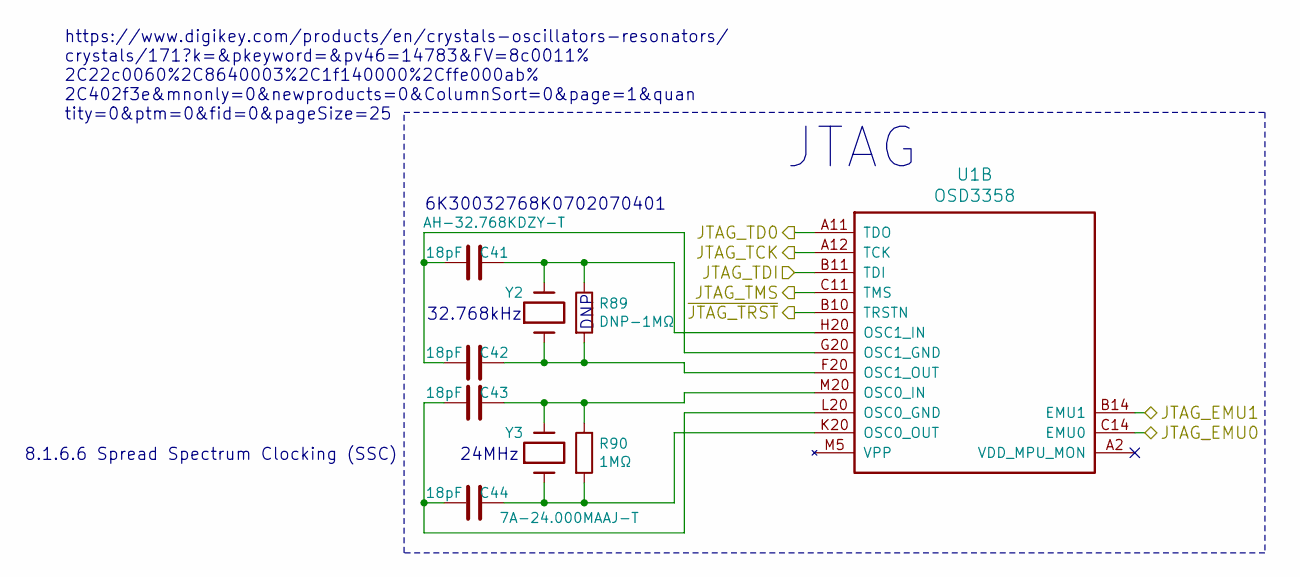
[picture p45: schematic jtag.sch]

Parts:
C41, C42, C43, C44: 18pF; Crystal_C_0402
R89: DNP-1MΩ; R_0603
R90: 1MΩ; R_0603
U1: OSD3358; BGA-400-1-27mm
Y2: AH-32.768KDZY-T; Crystal_SMD_32.768kHz_2Pads
Y3: 7A-24.000MAAJ-T; Crystal_SMD_7A_2Pads

Connections:
/JTAG/JTAG_EMU0: U1.C14 (EMU0); also elsewhere on the board
/JTAG/JTAG_EMU1: U1.B14 (EMU1); also elsewhere on the board
/JTAG/JTAG_TD0: U1.A11 (TDO); also elsewhere on the board
/JTAG/JTAG_TDI: U1.B11 (TDI); also elsewhere on the board
/JTAG/JTAG_TMS: U1.C11 (TMS); also elsewhere on the board
/JTAG/~JTAG_TRST: U1.B10 (TRSTN); also elsewhere on the board
/TCK: U1.A12 (TCK); also elsewhere on the board
unnamed: C41.1, R89.1, U1.H20 (OSC1_IN), Y2.2
unnamed: C41.2, C42.2, U1.G20 (OSC1_GND)
unnamed: C42.1, R89.2, U1.F20 (OSC1_OUT), Y2.1
unnamed: C43.1, R90.1, U1.M20 (OSC0_IN), Y3.2
unnamed: C43.2, C44.2, U1.L20 (OSC0_GND)
unnamed: C44.1, R90.2, U1.K20 (OSC0_OUT), Y3.1

Notes on the sheet:
JTAG
DNP
32.768kHz
24MHz
https://www.digikey.com/products/en/crystals-oscillators-resonators/ crystals/171?k=&pkeyword=&pv46=14783&FV=8c0011% 2C22c0060%2C8640003%2C1f140000%2Cffe000ab% 2C402f3e&mnonly=0&newproducts=0&ColumnSort=0&page=1&quan tity=0&ptm=0&fid=0&pageSize=25
6K30032768K0702070401
8.1.6.6 Spread Spectrum Clocking (SSC)

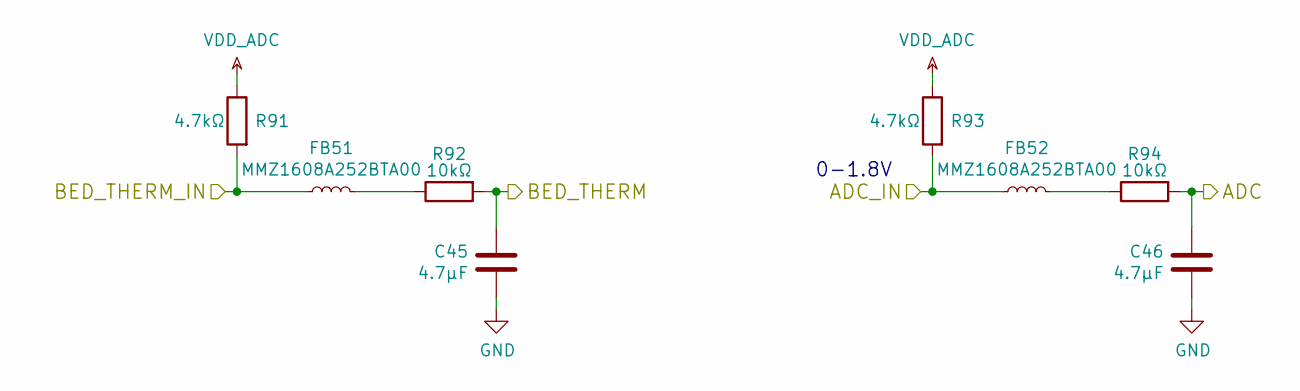
[picture p46: schematic therm.sch]

Parts:
C45, C46: 4.7μF; C_0603
FB51, FB52: MMZ1608A252BTA00; Ferrite_Bead_0603
R91, R93: 4.7kΩ; R_0603
R92, R94: 10kΩ; R_0603

Connections:
/ADC: C46.2, R94.2; also elsewhere on the board
/BED_THERM: C45.2, R92.2; also elsewhere on the board
/Thermistors/ADC_IN: FB52.2, R93.2; also elsewhere on the board
/Thermistors/BED_THERM_IN: FB51.2, R91.2; also elsewhere on the board
CGND: C45.1, C46.1; also elsewhere on the board
unnamed: FB51.1, R92.1
unnamed: FB52.1, R94.1
VDD_ADC: R91.1, R93.1; also elsewhere on the board

Notes on the sheet:
0-1.8V

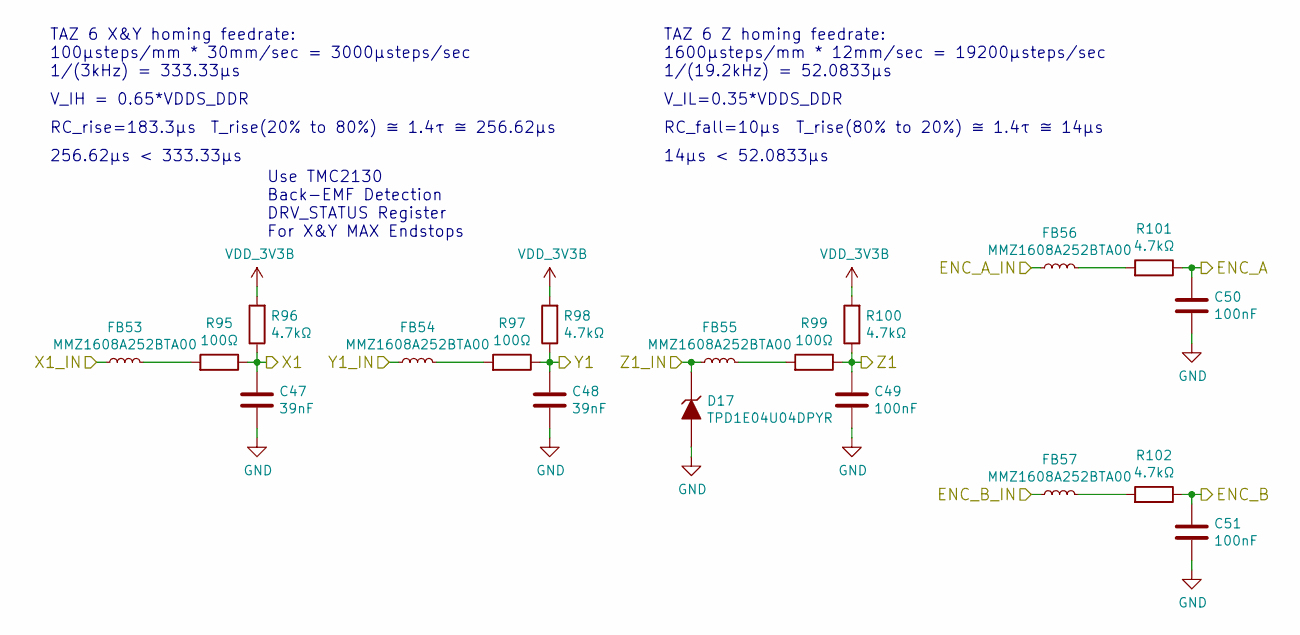
[picture p47: schematic endstop.sch]

Parts:
C47, C48: 39nF; C_0603
C49, C50, C51: 100nF; C_0603
D17: TPD1E04U04DPYR; TPD_PX1SON
FB53, FB54, FB55, FB56, FB57: MMZ1608A252BTA00; Ferrite_Bead_0603
R95, R97, R99: 100Ω; R_0603
R96, R98, R100, R101, R102: 4.7kΩ; R_0603

Connections:
/ENC_A: C50.1, R101.1; also elsewhere on the board
/ENC_B: C51.1, R102.1; also elsewhere on the board
/Endstops/ENC_A_IN: FB56.2; also elsewhere on the board
/Endstops/ENC_B_IN: FB57.2; also elsewhere on the board
/Endstops/X1_IN: FB53.2; also elsewhere on the board
/Endstops/Y1_IN: FB54.2; also elsewhere on the board
/Endstops/Z1_IN: D17.1 (K), FB55.2; also elsewhere on the board
/X1_ENDSTOP: C47.1, R95.1, R96.1; also elsewhere on the board
/Y1_ENDSTOP: C48.1, R97.1, R98.1; also elsewhere on the board
/Z1_ENDSTOP: C49.1, R99.1, R100.1; also elsewhere on the board
CGND: C47.2, C48.2, C49.2, C50.2, C51.2, D17.2 (A); also elsewhere on the board
unnamed: FB53.1, R95.2
unnamed: FB54.1, R97.2
unnamed: FB55.1, R99.2
unnamed: FB56.1, R101.2
unnamed: FB57.1, R102.2
VCC: R96.2, R98.2, R100.2; also elsewhere on the board

Notes on the sheet:
Use TMC2130 Back-EMF Detection DRV_STATUS Register For X&Y MAX Endstops
RC_rise=183.3μs
RC_fall=10μs
V_IH = 0.65*VDDS_DDR
T_rise(20% to 80%) ≅ 1.4τ ≅ 256.62μs
TAZ 6 X&Y homing feedrate: 100μsteps/mm * 30mm/sec = 3000μsteps/sec 1/(3kHz) = 333.33μs
V_IL=0.35*VDDS_DDR
256.62μs < 333.33μs
TAZ 6 Z homing feedrate: 1600μsteps/mm * 12mm/sec = 19200μsteps/sec 1/(19.2kHz) = 52.0833μs
T_rise(80% to 20%) ≅ 1.4τ ≅ 14μs
14μs < 52.0833μs

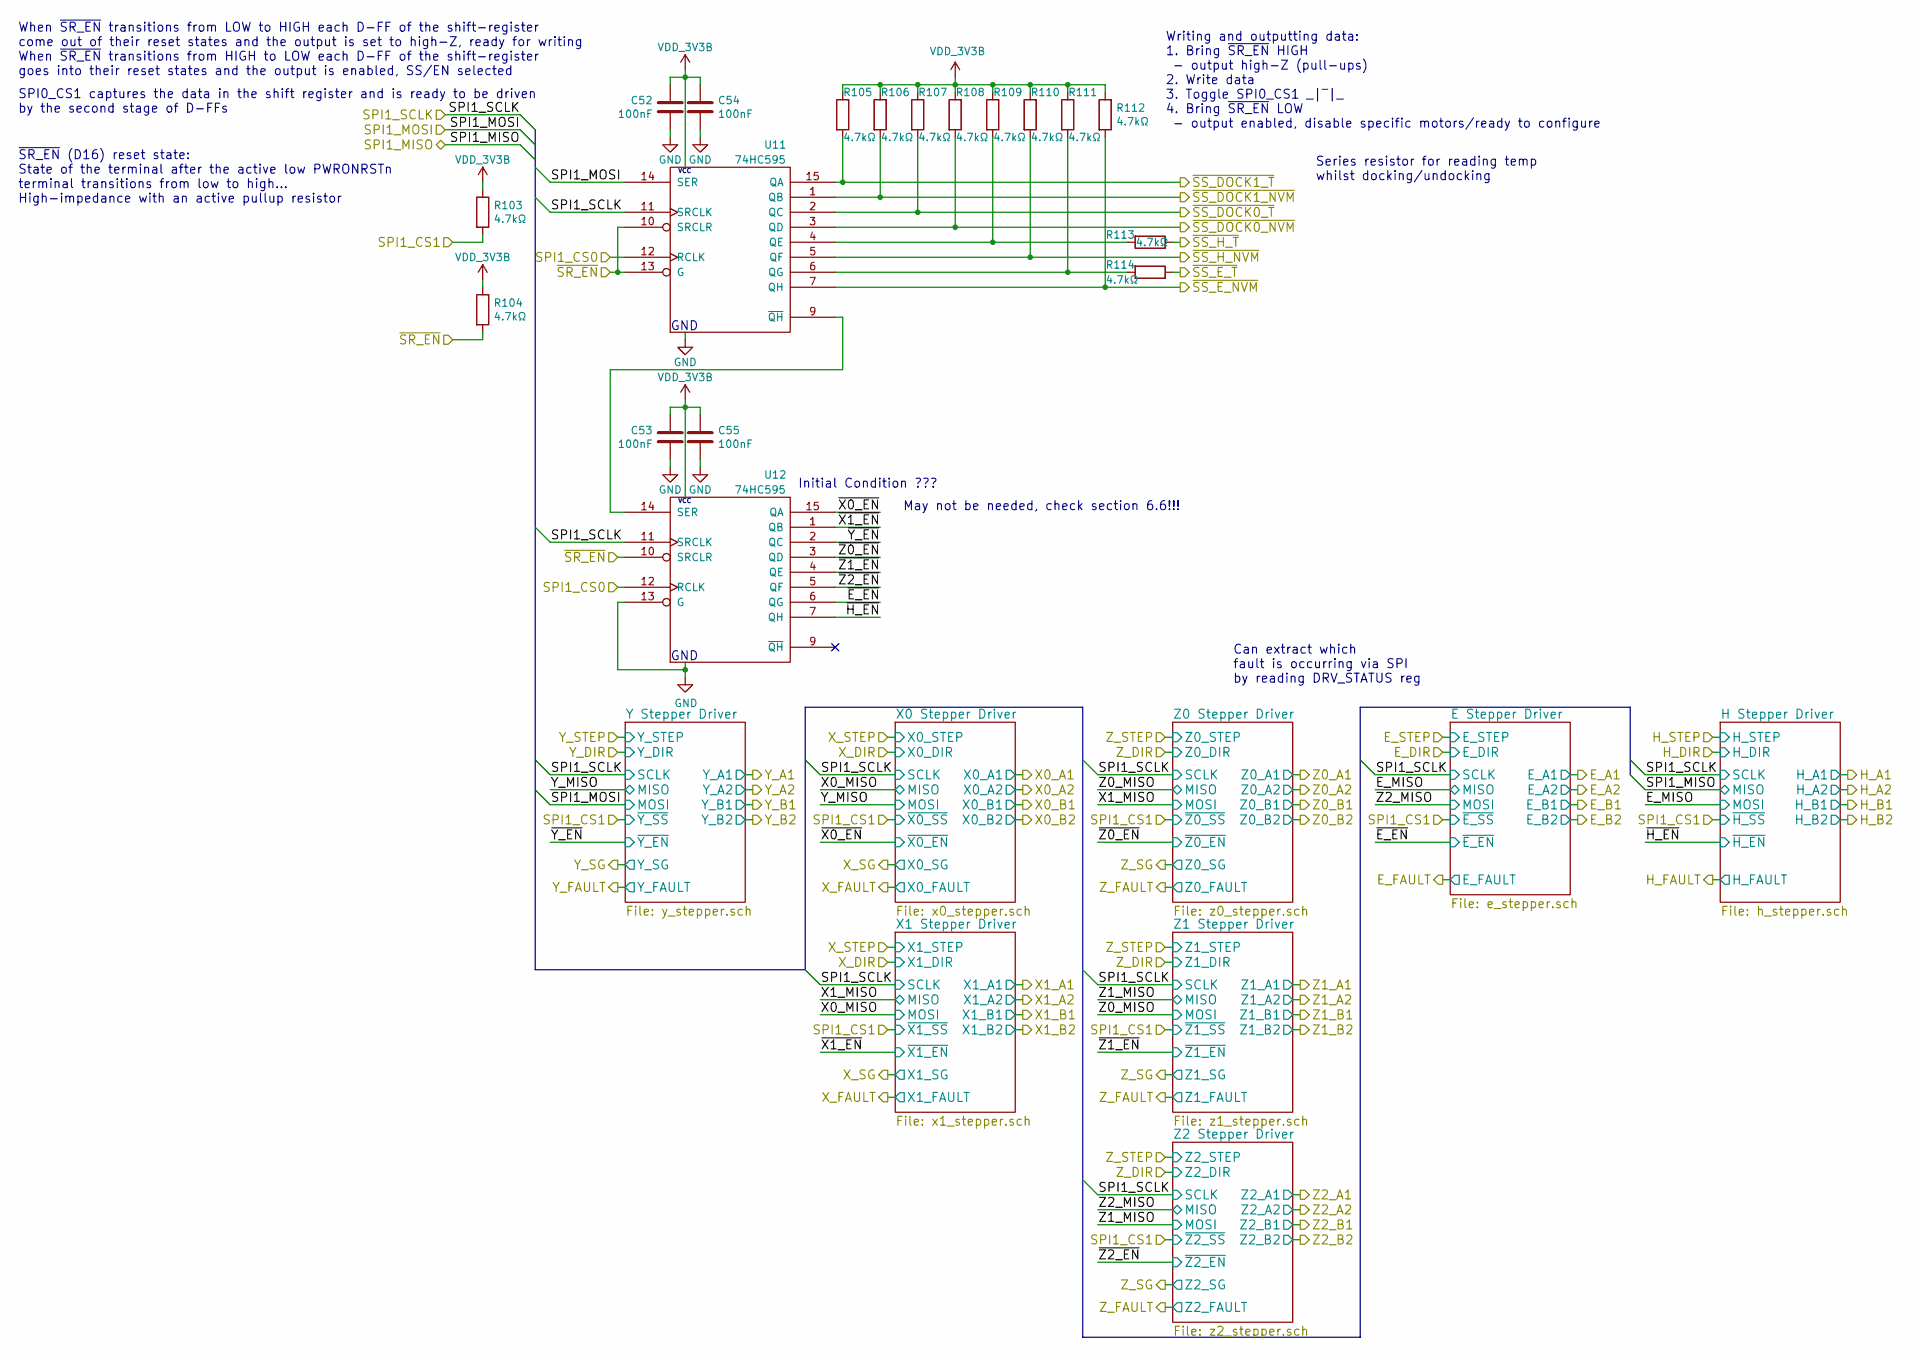
[picture p48: schematic stepper.sch]

Parts:
C52, C53, C54, C55: 100nF; C_0603
R103, R104, R105, R106, R107, R108, R109, R110, R111, R112, R113, R114: 4.7kΩ; R_0603
U11, U12: 74HC595; TSSOP-16_4.4x5mm_Pitch0.65mm

Connections:
/SPI1_CS0: U11.12 (RCLK), U12.12 (RCLK); also elsewhere on the board
/SPI1_CS1: R103.2; also elsewhere on the board
/SPI1_MOSI: U11.14 (SER); also elsewhere on the board
/SPI1_SCLK: U11.11 (SRCLK), U12.11 (SRCLK); also elsewhere on the board
/Stepper Drivers/~E_EN: U12.6 (QG); also elsewhere on the board
/Stepper Drivers/~H_EN: U12.7 (QH); also elsewhere on the board
/Stepper Drivers/~X0_EN: U12.15 (QA); also elsewhere on the board
/Stepper Drivers/~X1_EN: U12.1 (QB); also elsewhere on the board
/Stepper Drivers/~Y_EN: U12.2 (QC); also elsewhere on the board
/Stepper Drivers/~Z0_EN: U12.3 (QD); also elsewhere on the board
/Stepper Drivers/~Z1_EN: U12.4 (QE); also elsewhere on the board
/Stepper Drivers/~Z2_EN: U12.5 (QF); also elsewhere on the board
/~SR_EN: R104.2, U11.10 (SRCLR), U11.13 (G), U12.10 (SRCLR); also elsewhere on the board
/~SS_DOCK0_NVM: R108.2, U11.3 (QD); also elsewhere on the board
/~SS_DOCK0_T: R107.2, U11.2 (QC); also elsewhere on the board
/~SS_DOCK1_NVM: R106.2, U11.1 (QB); also elsewhere on the board
/~SS_DOCK1_T: R105.2, U11.15 (QA); also elsewhere on the board
/~SS_E_NVM: R112.2, U11.7 (QH); also elsewhere on the board
/~SS_E_T: R114.1; also elsewhere on the board
/~SS_H_NVM: R110.2, U11.5 (QF); also elsewhere on the board
/~SS_H_T: R113.1; also elsewhere on the board
CGND: C52.2, C53.2, C54.1, C55.2, U11.8 (GND), U12.8 (GND), U12.13 (G); also elsewhere on the board
unnamed: R109.2, R113.2, U11.4 (QE)
unnamed: R111.2, R114.2, U11.6 (QG)
unnamed: U11.9 (~QH), U12.14 (SER)
VCC: C52.1, C53.1, C54.2, C55.1, R103.1, R104.1, R105.1, R106.1, R107.1, R108.1, R109.1, R110.1, R111.1, R112.1, U11.16 (VCC), U12.16 (VCC); also elsewhere on the board

Notes on the sheet:
GND
VCC
When ~SR_EN~ transitions from LOW to HIGH each D-FF of the shift-register come out of their reset states and the output is set to high-Z, ready for writing When ~SR_EN~ transitions from HIGH to LOW each D-FF of the shift-register goes into their reset states and the output is enabled, SS/EN selected
SPI0_CS1 captures the data in the shift register and is ready to be driven by the second stage of D-FFs
Writing and outputting data: 1. Bring ~SR_EN~ HIGH - output high-Z (pull-ups) 2. Write data 3. Toggle SPI0_CS1 _|‾|_ 4. Bring ~SR_EN~ LOW - output enabled, disable specific motors/ready to configure
Can extract which fault is occurring via SPI by reading DRV_STATUS reg
Series resistor for reading temp whilst docking/undocking
Initial Condition ???
May not be needed, check section 6.6!!!
~SR_EN~ (D16) reset state: State of the terminal after the active low PWRONRSTn terminal transitions from low to high... High-impedance with an active pullup resistor

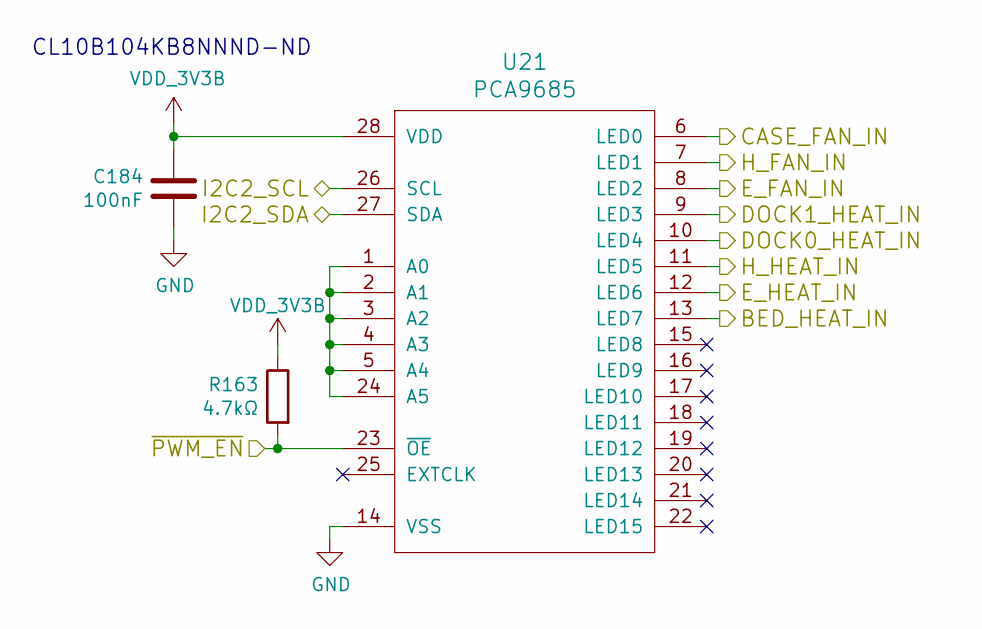
[picture p49: schematic pwm.sch]

Parts:
C184: 100nF; C_0603
R163: 4.7kΩ; R_0603
U21: PCA9685; TSSOP-28_4.4x9.7mm_Pitch0.65mm

Connections:
/CLKOUT2: R163.2, U21.23 (~OE); also elsewhere on the board
/Fans/CASE_FAN_IN: U21.6 (LED0); also elsewhere on the board
/Fans/E_FAN_IN: U21.8 (LED2); also elsewhere on the board
/Fans/H_FAN_IN: U21.7 (LED1); also elsewhere on the board
/Heaters/BED_HEAT_IN: U21.13 (LED7); also elsewhere on the board
/Heaters/DOCK0_HEAT_IN: U21.10 (LED4); also elsewhere on the board
/Heaters/DOCK1_HEAT_IN: U21.9 (LED3); also elsewhere on the board
/Heaters/E_HEAT_IN: U21.12 (LED6); also elsewhere on the board
/Heaters/H_HEAT_IN: U21.11 (LED5); also elsewhere on the board
/I2C2_SCL: U21.26 (SCL); also elsewhere on the board
/I2C2_SDA: U21.27 (SDA); also elsewhere on the board
CGND: C184.2, U21.14 (VSS); also elsewhere on the board
unnamed: U21.1 (A0), U21.2 (A1), U21.3 (A2), U21.4 (A3), U21.5 (A4), U21.24 (A5)
VCC: C184.1, R163.1, U21.28 (VDD); also elsewhere on the board

Notes on the sheet:
CL10B104KB8NNND-ND
