gralco/cimarron/KiMBo/KiMBo.kicad_pcb

## KiCad design KiMBo/KiMBo.kicad_pcb (continued)

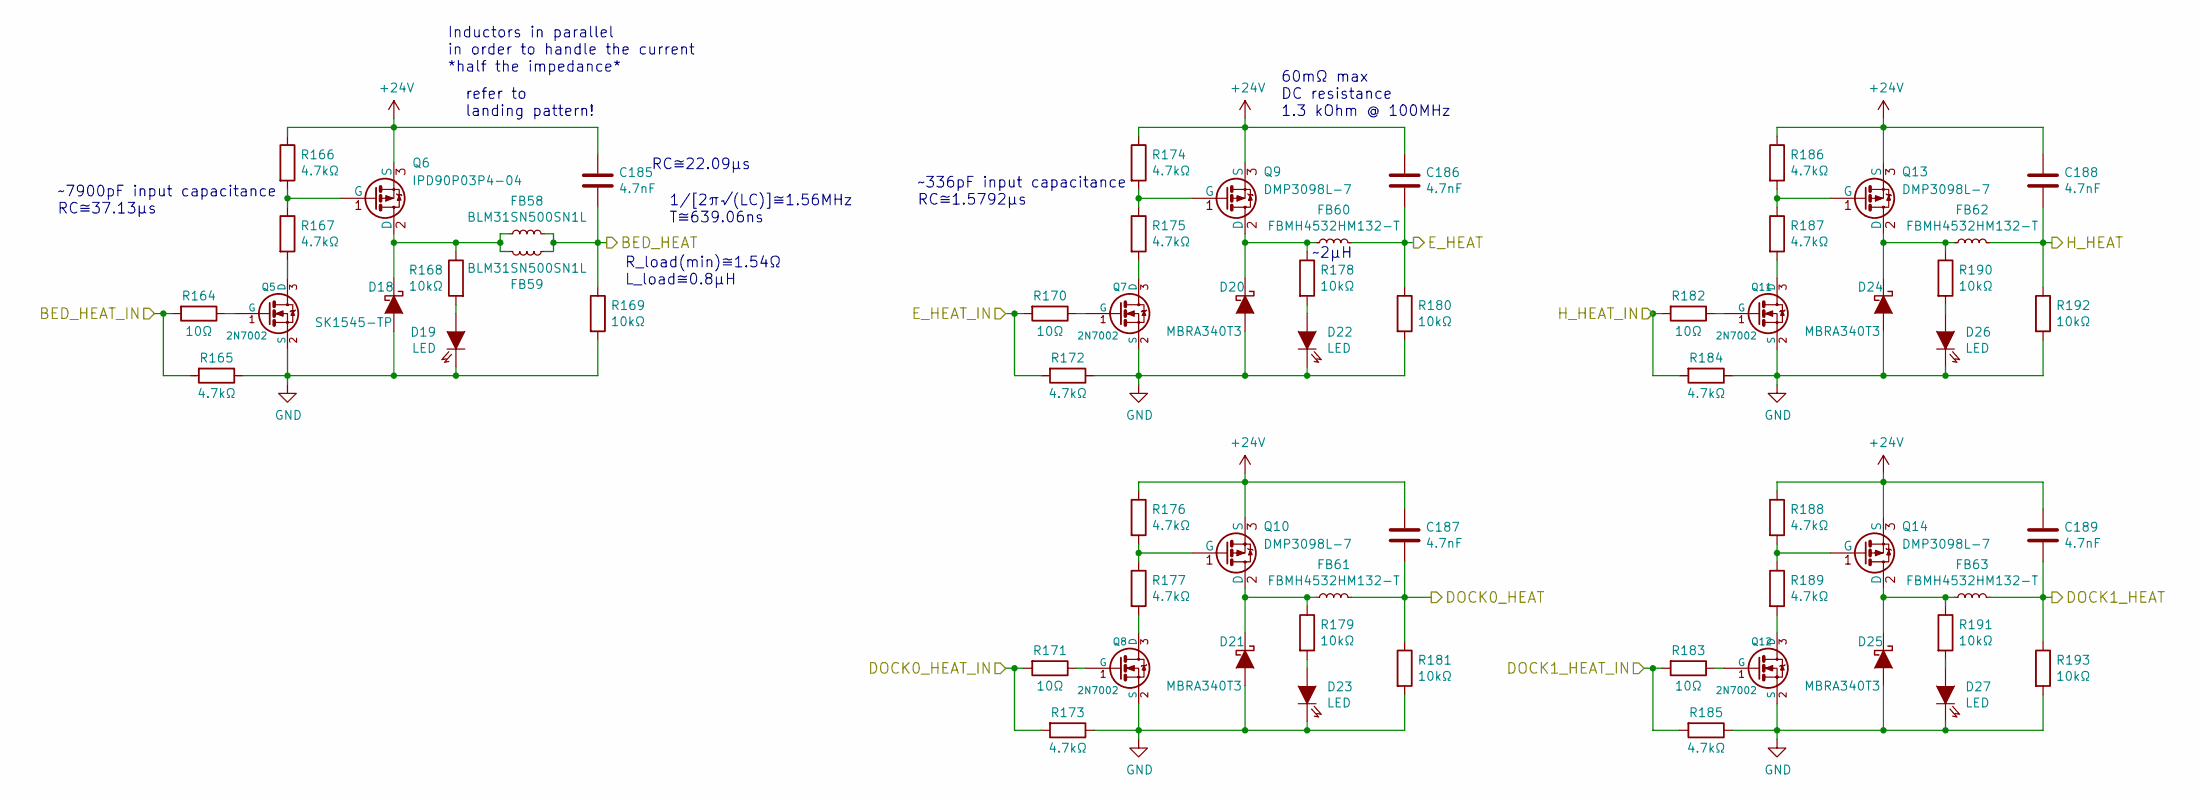
[picture p50: schematic heater.sch]

Parts:
C185, C186, C187, C188, C189: 4.7nF; C_0603
D18: SK1545-TP; SK-DO-214AB
D19, D22, D23, D26, D27: LED; LED_0603
D20, D21, D24, D25: MBRA340T3; MBR-DO-214AC
FB58, FB59: BLM31SN500SN1L; R_1206_HandSoldering
FB60, FB61, FB62, FB63: FBMH4532HM132-T; Ferrite_Bead_1812
Q5, Q7, Q8, Q11, Q12: 2N7002; SOT-23
Q6: IPD90P03P4-04; TO-252-2Lead
Q9, Q10, Q13, Q14: DMP3098L-7; SOT-23
R164, R170, R171, R182, R183: 10Ω; R_0603
R165, R166, R167, R172, R173, R174, R175, R176, R177, R184, R185, R186, R187, R188, R189: 4.7kΩ; R_0603
R168, R169, R178, R179, R180, R181, R190, R191, R192, R193: 10kΩ; R_0603

Connections:
+24V: C185.1, C186.1, C187.1, C188.1, C189.1, Q6.3 (S), Q9.3 (S), Q10.3 (S), Q13.3 (S), Q14.3 (S), R166.1, R174.1, R176.1, R186.1, R188.1; also elsewhere on the board
/Heaters/BED_HEAT: C185.2, FB58.2, FB59.2, R169.1; also elsewhere on the board
/Heaters/BED_HEAT_IN: R164.2, R165.2; also elsewhere on the board
/Heaters/DOCK0_HEAT: C187.2, FB61.2, R181.1; also elsewhere on the board
/Heaters/DOCK0_HEAT_IN: R171.2, R173.2; also elsewhere on the board
/Heaters/DOCK1_HEAT: C189.2, FB63.2, R193.1; also elsewhere on the board
/Heaters/DOCK1_HEAT_IN: R183.2, R185.2; also elsewhere on the board
/Heaters/E_HEAT: C186.2, FB60.2, R180.1; also elsewhere on the board
/Heaters/E_HEAT_IN: R170.2, R172.2; also elsewhere on the board
/Heaters/H_HEAT: C188.2, FB62.2, R192.1; also elsewhere on the board
/Heaters/H_HEAT_IN: R182.2, R184.2; also elsewhere on the board
CGND: D18.2 (A), D19.1 (K), D20.2 (A), D21.2 (A), D22.1 (K), D23.1 (K), D24.2 (A), D25.2 (A), D26.1 (K), D27.1 (K), Q5.2 (S), Q7.2 (S), Q8.2 (S), Q11.2 (S), Q12.2 (S), R165.1, R169.2, R172.1, R173.1, R180.2, R181.2, R184.1, R185.1, R192.2, R193.2; also elsewhere on the board
unnamed: D18.1 (K), FB58.1, FB59.1, Q6.2 (D), R168.1
unnamed: D19.2 (A), R168.2
unnamed: D20.1 (K), FB60.1, Q9.2 (D), R178.1
unnamed: D21.1 (K), FB61.1, Q10.2 (D), R179.1
unnamed: D22.2 (A), R178.2
unnamed: D23.2 (A), R179.2
unnamed: D24.1 (K), FB62.1, Q13.2 (D), R190.1
unnamed: D25.1 (K), FB63.1, Q14.2 (D), R191.1
unnamed: D26.2 (A), R190.2
unnamed: D27.2 (A), R191.2
unnamed: Q5.1 (G), R164.1
unnamed: Q5.3 (D), R167.2
unnamed: Q6.1 (G), R166.2, R167.1
unnamed: Q7.1 (G), R170.1
unnamed: Q7.3 (D), R175.2
unnamed: Q8.1 (G), R171.1
unnamed: Q8.3 (D), R177.2
unnamed: Q9.1 (G), R174.2, R175.1
unnamed: Q10.1 (G), R176.2, R177.1
unnamed: Q11.1 (G), R182.1
unnamed: Q11.3 (D), R187.2
unnamed: Q12.1 (G), R183.1
unnamed: Q12.3 (D), R189.2
unnamed: Q13.1 (G), R186.2, R187.1
unnamed: Q14.1 (G), R188.2, R189.1

Notes on the sheet:
RC≅22.09μs
~~7900pF input capacitance RC≅37.13μs
~~336pF input capacitance RC≅1.5792μs
60mΩ max DC resistance 1.3 kOhm @ 100MHz
~~2μH
Inductors in parallel in order to handle the current *half the impedance*
1/[2π√(LC)]≅1.56MHz T≅639.06ns
R_load(min)≅1.54Ω L_load≅0.8μH
refer to landing pattern!

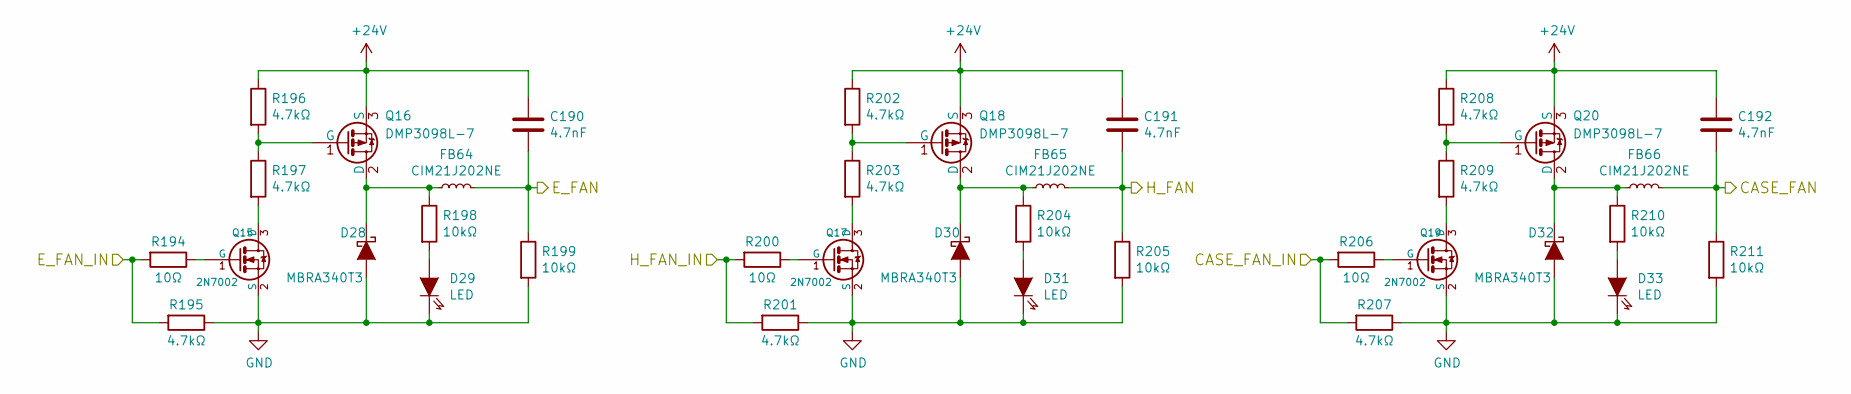
[picture p51: schematic fan.sch]

Parts:
C190, C191, C192: 4.7nF; C_0603
D28, D30, D32: MBRA340T3; MBR-DO-214AC
D29, D31, D33: LED; LED_0603
FB64, FB65, FB66: CIM21J202NE; R_0805
Q15, Q17, Q19: 2N7002; SOT-23
Q16, Q18, Q20: DMP3098L-7; SOT-23
R194, R200, R206: 10Ω; R_0603
R195, R196, R197, R201, R202, R203, R207, R208, R209: 4.7kΩ; R_0603
R198, R199, R204, R205, R210, R211: 10kΩ; R_0603

Connections:
+24V: C190.1, C191.1, C192.1, Q16.3 (S), Q18.3 (S), Q20.3 (S), R196.1, R202.1, R208.1; also elsewhere on the board
/Fans/CASE_FAN: C192.2, FB66.2, R211.1; also elsewhere on the board
/Fans/CASE_FAN_IN: R206.2, R207.2; also elsewhere on the board
/Fans/E_FAN: C190.2, FB64.2, R199.1; also elsewhere on the board
/Fans/E_FAN_IN: R194.2, R195.2; also elsewhere on the board
/Fans/H_FAN: C191.2, FB65.2, R205.1; also elsewhere on the board
/Fans/H_FAN_IN: R200.2, R201.2; also elsewhere on the board
CGND: D28.2 (A), D29.1 (K), D30.2 (A), D31.1 (K), D32.2 (A), D33.1 (K), Q15.2 (S), Q17.2 (S), Q19.2 (S), R195.1, R199.2, R201.1, R205.2, R207.1, R211.2; also elsewhere on the board
unnamed: D28.1 (K), FB64.1, Q16.2 (D), R198.1
unnamed: D29.2 (A), R198.2
unnamed: D30.1 (K), FB65.1, Q18.2 (D), R204.1
unnamed: D31.2 (A), R204.2
unnamed: D32.1 (K), FB66.1, Q20.2 (D), R210.1
unnamed: D33.2 (A), R210.2
unnamed: Q15.1 (G), R194.1
unnamed: Q15.3 (D), R197.2
unnamed: Q16.1 (G), R196.2, R197.1
unnamed: Q17.1 (G), R200.1
unnamed: Q17.3 (D), R203.2
unnamed: Q18.1 (G), R202.2, R203.1
unnamed: Q19.1 (G), R206.1
unnamed: Q19.3 (D), R209.2
unnamed: Q20.1 (G), R208.2, R209.1

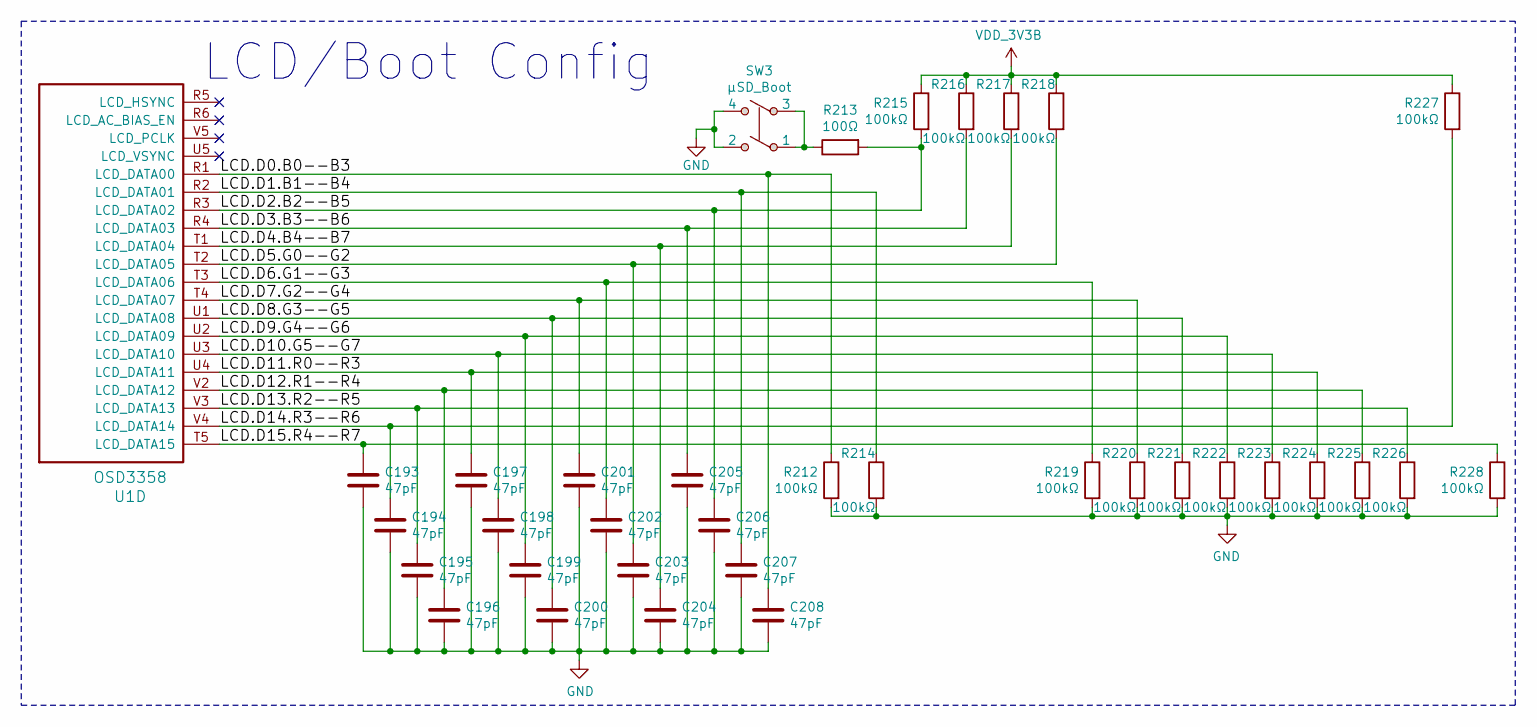
[picture p52: schematic hdmi.sch]

Parts:
C193, C194, C195, C196, C197, C198, C199, C200, C201, C202, C203, C204, C205, C206, C207, C208: 47pF; C_0603
R212, R214, R215, R216, R217, R218, R219, R220, R221, R222, R223, R224, R225, R226, R227, R228: 100kΩ; R_0603
R213: 100Ω; R_0603
SW3: μSD_Boot; KMR_SW_SPST_EVQP7A
U1: OSD3358; BGA-400-1-27mm

Connections:
/Configuration/LCD.D0.B0--B3: C208.1, R212.1, U1.R1 (LCD_DATA00)
/Configuration/LCD.D1.B1--B4: C207.1, R214.1, U1.R2 (LCD_DATA01)
/Configuration/LCD.D2.B2--B5: C206.1, R213.2, R215.2, U1.R3 (LCD_DATA02)
/Configuration/LCD.D3.B3--B6: C205.1, R216.2, U1.R4 (LCD_DATA03)
/Configuration/LCD.D4.B4--B7: C204.1, R217.2, U1.T1 (LCD_DATA04)
/Configuration/LCD.D5.G0--G2: C203.1, R218.2, U1.T2 (LCD_DATA05)
/Configuration/LCD.D6.G1--G3: C202.1, R219.1, U1.T3 (LCD_DATA06)
/Configuration/LCD.D7.G2--G4: C201.1, R220.1, U1.T4 (LCD_DATA07)
/Configuration/LCD.D8.G3--G5: C200.1, R221.1, U1.U1 (LCD_DATA08)
/Configuration/LCD.D9.G4--G6: C199.1, R222.1, U1.U2 (LCD_DATA09)
/Configuration/LCD.D10.G5--G7: C198.1, R223.1, U1.U3 (LCD_DATA10)
/Configuration/LCD.D11.R0--R3: C197.1, R224.1, U1.U4 (LCD_DATA11)
/Configuration/LCD.D12.R1--R4: C196.1, R225.1, U1.V2 (LCD_DATA12)
/Configuration/LCD.D13.R2--R5: C195.1, R226.1, U1.V3 (LCD_DATA13)
/Configuration/LCD.D14.R3--R6: C194.1, R227.2, U1.V4 (LCD_DATA14)
/Configuration/LCD.D15.R4--R7: C193.1, R228.1, U1.T5 (LCD_DATA15)
CGND: C193.2, C194.2, C195.2, C196.2, C197.2, C198.2, C199.2, C200.2, C201.2, C202.2, C203.2, C204.2, C205.2, C206.2, C207.2, C208.2, R212.2, R214.2, R219.2, R220.2, R221.2, R222.2, R223.2, R224.2, R225.2, R226.2, R228.2, SW3.2, SW3.4; also elsewhere on the board
unnamed: R213.1, SW3.1, SW3.3
VCC: R215.1, R216.1, R217.1, R218.1, R227.1; also elsewhere on the board

Notes on the sheet:
LCD/Boot Config

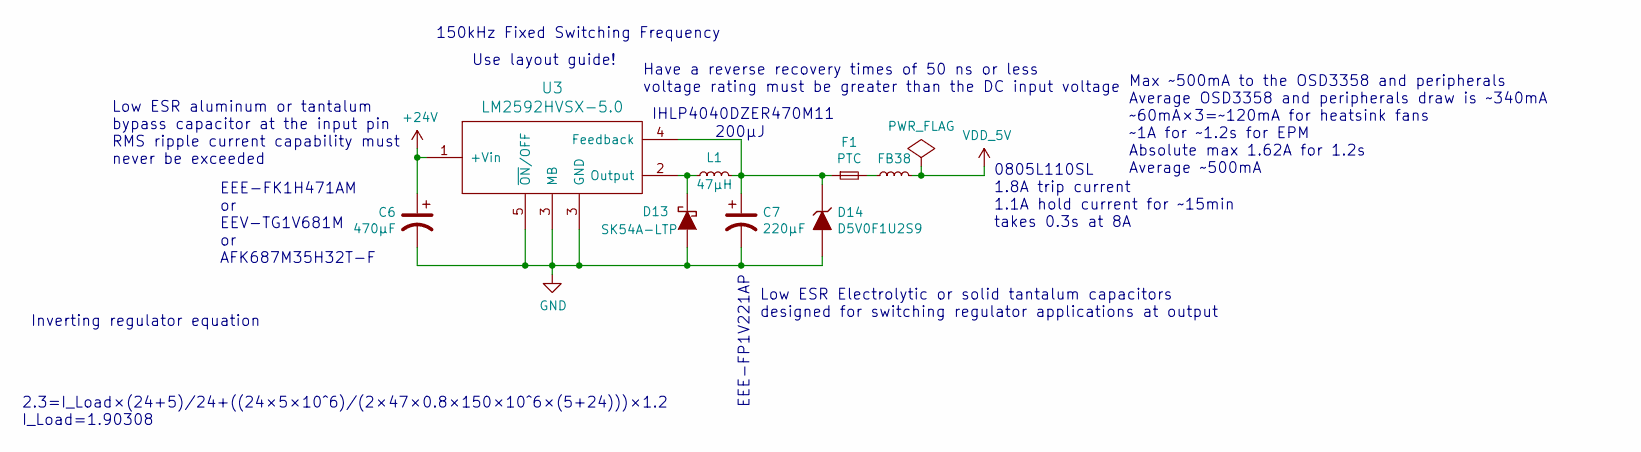
[picture p53: schematic voltage_regulator.sch]

Parts:
C6: 470μF; c_elec_16x16.5
C7: 220μF; c_elec_8x10.2
D13: SK54A-LTP; SK-DO-214AC
D14: D5V0F1U2S9; SOD-923
F1: PTC; PTC_SMD0805_Reflow
FB38: MPZ2012S601AT000; Ferrite_Bead_0805
L1: 47μH; IHLP_Inductor
U3: LM2592HVSX-5.0; TO-263-5Lead

Connections:
+24V: C6.1, U3.1 (+Vin); also elsewhere on the board
CGND: C6.2, C7.2, D13.2 (A), D14.2 (A), U3.3 (GND), U3.5 (~ON~/OFF); also elsewhere on the board
unnamed: C7.1, D14.1 (K), F1.1, L1.2, U3.4 (Feedback)
unnamed: D13.1 (K), L1.1, U3.2 (Output)
unnamed: F1.2, FB38.1
VDD_5V: FB38.2; also elsewhere on the board

Notes on the sheet:
Use layout guide!
EEE-FP1V221AP
IHLP4040DZER470M11
EEE-FK1H471AM or EEV-TG1V681M or AFK687M35H32T-F
Max ~~500mA to the OSD3358 and peripherals Average OSD3358 and peripherals draw is ~~340mA ~~60mA×3=~~120mA for heatsink fans ~~1A for ~~1.2s for EPM Absolute max 1.62A for 1.2s Average ~~500mA
2.3=I_Load×(24+5)/24+((24×5×10^6)/(2×47×0.8×150×10^6×(5+24)))×1.2 I_Load=1.90308
150kHz Fixed Switching Frequency
Low ESR aluminum or tantalum bypass capacitor at the input pin RMS ripple current capability must never be exceeded
Low ESR Electrolytic or solid tantalum capacitors designed for switching regulator applications at output
Have a reverse recovery times of 50 ns or less voltage rating must be greater than the DC input voltage
200μJ
Inverting regulator equation
0805L110SL 1.8A trip current 1.1A hold current for ~~15min takes 0.3s at 8A

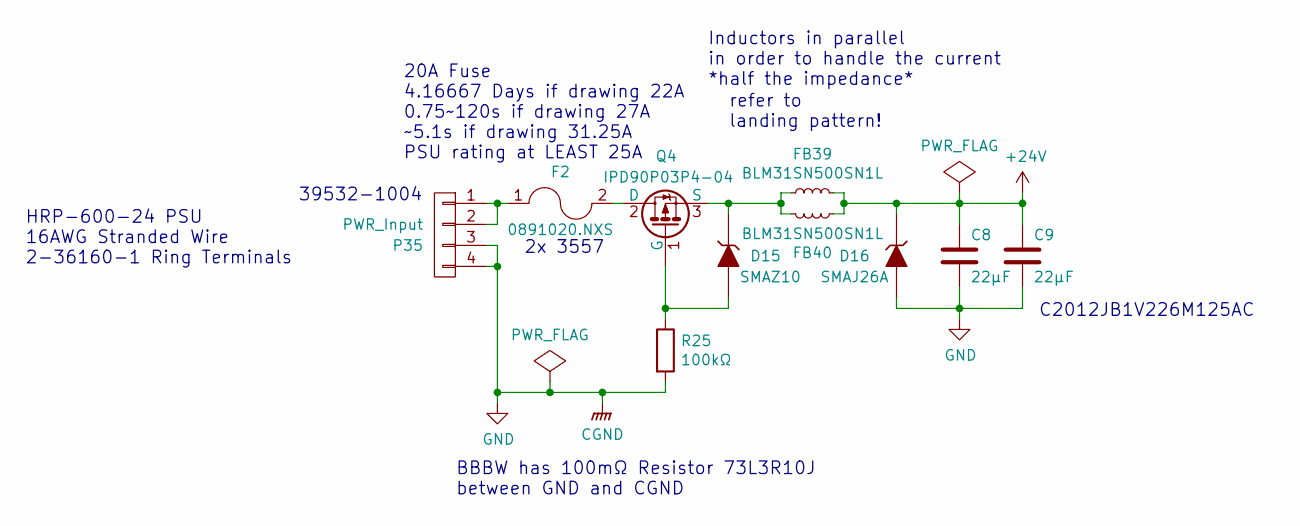
[picture p54: schematic input.sch]

Parts:
C8, C9: 22μF; C_0805
D15: SMAZ10; SMA-DO-214AC
D16: SMAJ26A; SK-DO-214AC
F2: 0891020.NXS; 3557-2-Fuseholder
FB39, FB40: BLM31SN500SN1L; R_1206_HandSoldering
P35: PWR_Input; euro_header_4_angled
Q4: IPD90P03P4-04; TO-252-2Lead
R25: 100kΩ; R_0603

Connections:
+24V: C8.1, C9.1, D16.1 (K), FB39.2, FB40.2; also elsewhere on the board
CGND: C8.2, C9.2, D16.2 (A), P35.3, P35.4, R25.2; also elsewhere on the board
unnamed: D15.1 (K), FB39.1, FB40.1, Q4.3 (S)
unnamed: D15.2 (A), Q4.1 (G), R25.1
unnamed: F2.1, P35.1, P35.2
unnamed: F2.2, Q4.2 (D)

Notes on the sheet:
Inductors in parallel in order to handle the current *half the impedance*
20A Fuse 4.16667 Days if drawing 22A 0.75~~120s if drawing 27A ~~5.1s if drawing 31.25A PSU rating at LEAST 25A
BBBW has 100mΩ Resistor 73L3R10J between GND and CGND
refer to landing pattern!
39532-1004
2x 3557
C2012JB1V226M125AC
HRP-600-24 PSU 16AWG Stranded Wire 2-36160-1 Ring Terminals

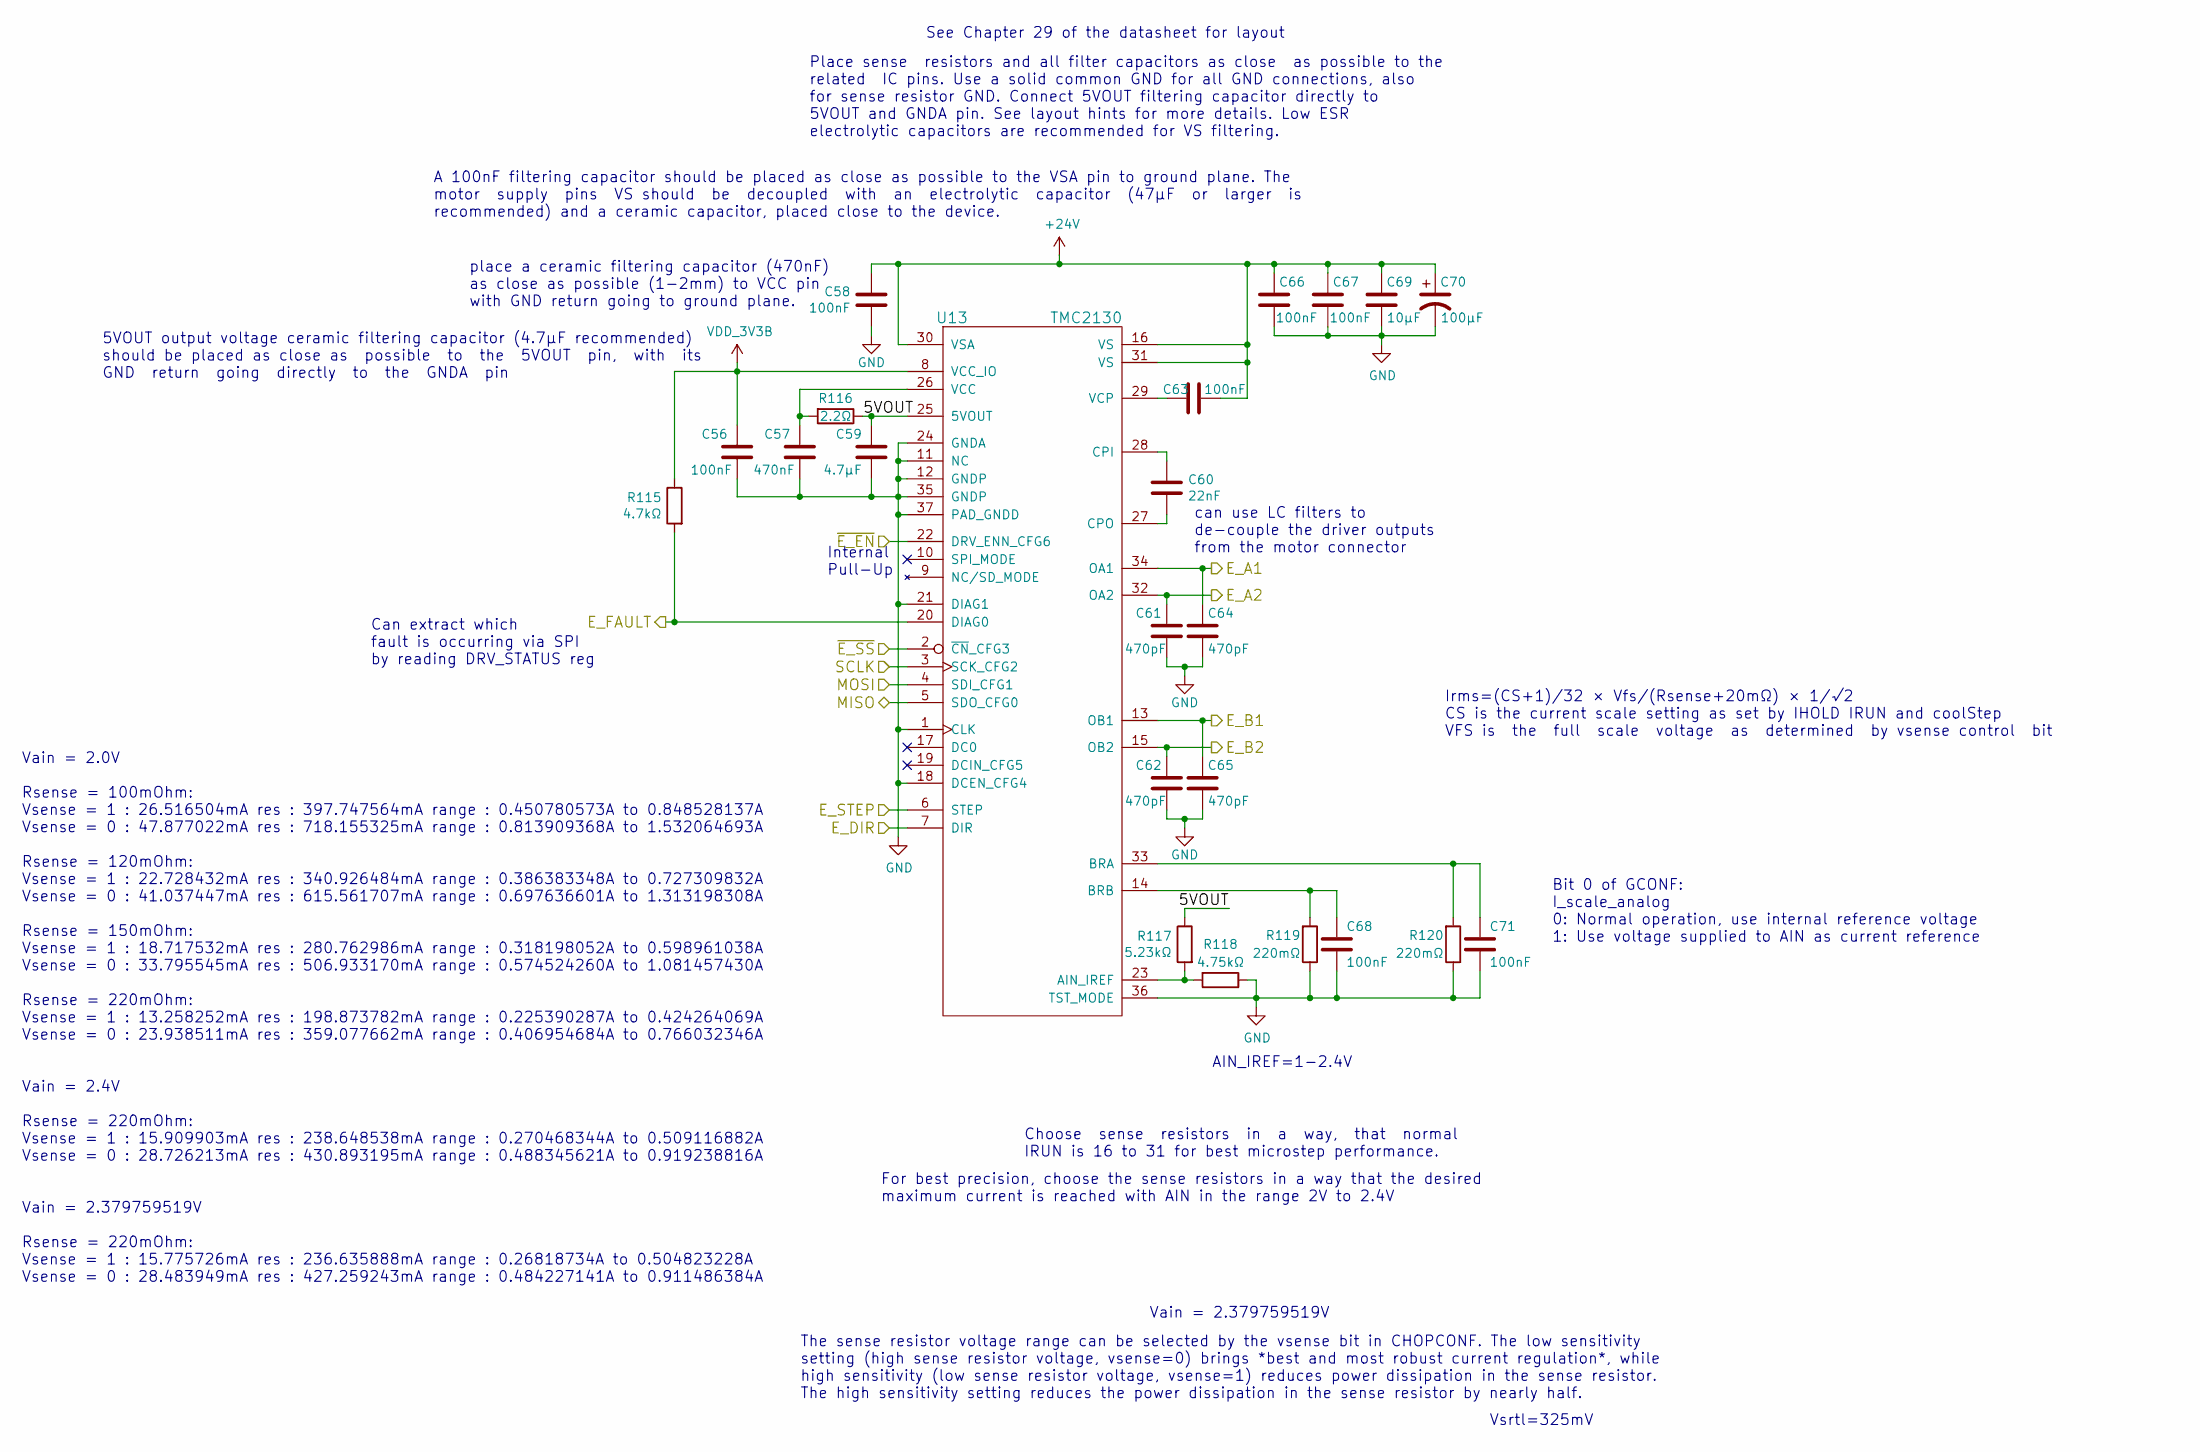
[picture p55: schematic e_stepper.sch]

Parts:
C56, C58, C63, C66, C67, C68, C71: 100nF; C_0603
C57: 470nF; C_0603
C59: 4.7μF; C_0603
C60: 22nF; C_0603
C61, C62, C64, C65: 470pF; C_0603
C69: 10μF; C_0805
C70: 100μF; c_elec_8x10
R115: 4.7kΩ; R_0603
R116: 2.2Ω; R_0603
R117: 5.23kΩ; R_0603
R118: 4.75kΩ; R_0603
R119, R120: 220mΩ; R_0805
U13: TMC2130; QFN36_5X6

Connections:
+24V: C58.2, C63.1, C66.1, C67.1, C69.1, C70.1, U13.16 (VS), U13.30 (VSA), U13.31 (VS); also elsewhere on the board
/E_DIR: U13.7 (DIR); also elsewhere on the board
/E_FAULT: R115.2, U13.20 (DIAG0); also elsewhere on the board
/E_STEP: U13.6 (STEP); also elsewhere on the board
/SPI1_CS1: U13.2 (~CN~_CFG3); also elsewhere on the board
/SPI1_SCLK: U13.3 (SCK_CFG2); also elsewhere on the board
/Stepper Drivers/E Stepper Driver/5VOUT: C59.1, R116.1, R117.1, U13.25 (5VOUT)
/Stepper Drivers/E_A1: C64.1, U13.34 (OA1); also elsewhere on the board
/Stepper Drivers/E_A2: C61.1, U13.32 (OA2); also elsewhere on the board
/Stepper Drivers/E_B1: C65.1, U13.13 (OB1); also elsewhere on the board
/Stepper Drivers/E_B2: C62.1, U13.15 (OB2); also elsewhere on the board
/Stepper Drivers/E_MISO: U13.5 (SDO_CFG0); also elsewhere on the board
/Stepper Drivers/Z2_MISO: U13.4 (SDI_CFG1); also elsewhere on the board
/Stepper Drivers/~E_EN: U13.22 (DRV_ENN_CFG6); also elsewhere on the board
CGND: C56.2, C57.2, C58.1, C59.2, C61.2, C62.2, C64.2, C65.2, C66.2, C67.2, C68.2, C69.2, C70.2, C71.2, R118.1, R119.1, R120.1, U13.1 (CLK), U13.11 (NC), U13.12 (GNDP), U13.18 (DCEN_CFG4), U13.21 (DIAG1), U13.24 (GNDA), U13.35 (GNDP), U13.36 (TST_MODE), U13.37 (PAD_GNDD); also elsewhere on the board
unnamed: C57.1, R116.2, U13.26 (VCC)
unnamed: C60.1, U13.28 (CPI)
unnamed: C60.2, U13.27 (CPO)
unnamed: C63.2, U13.29 (VCP)
unnamed: C68.1, R119.2, U13.14 (BRB)
unnamed: C71.1, R120.2, U13.33 (BRA)
unnamed: R117.2, R118.2, U13.23 (AIN_IREF)
VCC: C56.1, R115.1, U13.8 (VCC_IO); also elsewhere on the board

Notes on the sheet:
place a ceramic filtering capacitor (470nF) as close as possible (1-2mm) to VCC pin with GND return going to ground plane.
Irms=(CS+1)/32 × Vfs/(Rsense+20mΩ) × 1/√2 CS is the current scale setting as set by IHOLD IRUN and coolStep VFS is the full scale voltage as determined by vsense control bit
Internal Pull-Up
AIN_IREF=1-2.4V
Bit 0 of GCONF: I_scale_analog 0: Normal operation, use internal reference voltage 1: Use voltage supplied to AIN as current reference
The sense resistor voltage range can be selected by the vsense bit in CHOPCONF. The low sensitivity setting (high sense resistor voltage, vsense=0) brings *best and most robust current regulation*, while high sensitivity (low sense resistor voltage, vsense=1) reduces power dissipation in the sense 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
A 100nF filtering capacitor should be placed as close as possible to the VSA pin to ground plane. The motor supply pins VS should be decoupled with an electrolytic capacitor (47μF or larger is recommended) and a ceramic capacitor, placed close to the device.
For best precision, choose the sense resistors in a way that the desired maximum current is reached with AIN in the range 2V to 2.4V
Vsrtl=325mV
Vain = 2.379759519V
Choose sense resistors in a way, that normal IRUN is 16 to 31 for best microstep performance.
Place sense resistors and all filter capacitors as close as possible to the related IC pins. Use a solid common GND for all GND connections, also for sense resistor GND. Connect 5VOUT filtering capacitor directly to 5VOUT and GNDA pin. See layout hints for more details. Low ESR electrolytic capacit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
See Chapter 29 of the datasheet for layout
Vain = 2.0V Rsense = 100mOhm: Vsense = 1 : 26.516504mA res : 397.747564mA range : 0.450780573A to 0.848528137A Vsense = 0 : 47.877022mA res : 718.155325mA range : 0.813909368A to 1.532064693A Rsense = 120mOhm: Vsense = 1 : 22.728432mA res : 340.926484mA range : 0.386383348A to 0.727309832A Vsense =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
5VOUT output voltage ceramic filtering capacitor (4.7μF recommended) should be placed as close as possible to the 5VOUT pin, with its GND return going directly to the GNDA pin
Can extract which fault is occurring via SPI by reading DRV_STATUS reg
can use LC filters to de-couple the driver outputs from the motor connector

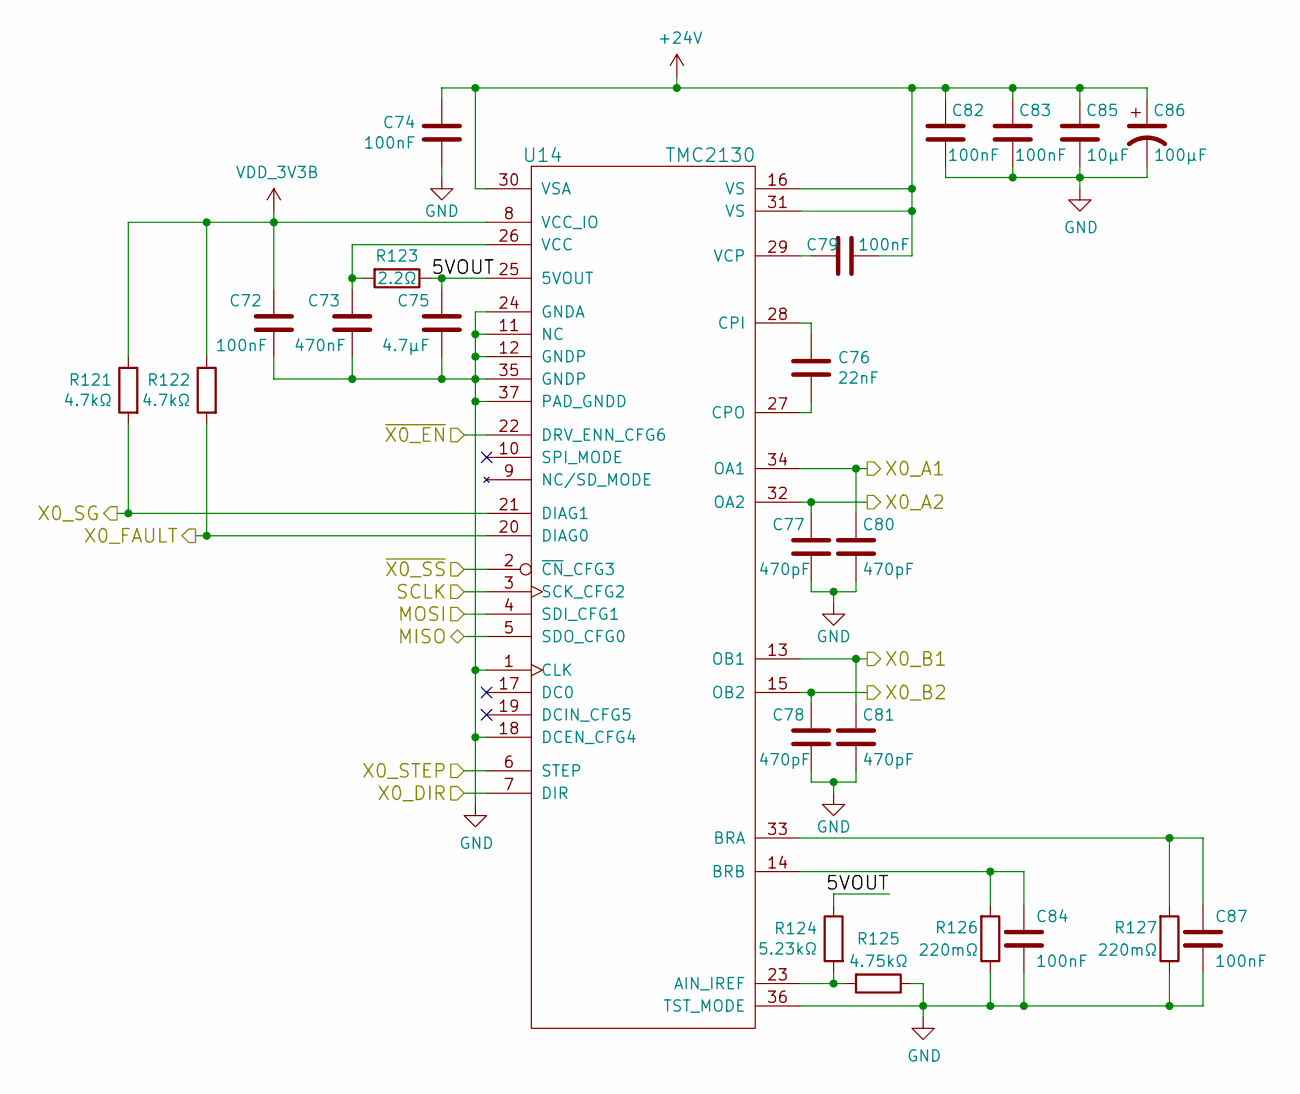
[picture p56: schematic x0_stepper.sch]

Parts:
C72, C74, C79, C82, C83, C84, C87: 100nF; C_0603
C73: 470nF; C_0603
C75: 4.7μF; C_0603
C76: 22nF; C_0603
C77, C78, C80, C81: 470pF; C_0603
C85: 10μF; C_0805
C86: 100μF; c_elec_8x10
R121, R122: 4.7kΩ; R_0603
R123: 2.2Ω; R_0603
R124: 5.23kΩ; R_0603
R125: 4.75kΩ; R_0603
R126, R127: 220mΩ; R_0805
U14: TMC2130; QFN36_5X6

Connections:
+24V: C74.2, C79.1, C82.1, C83.1, C85.1, C86.1, U14.16 (VS), U14.30 (VSA), U14.31 (VS); also elsewhere on the board
/SPI1_CS1: U14.2 (~CN~_CFG3); also elsewhere on the board
/SPI1_SCLK: U14.3 (SCK_CFG2); also elsewhere on the board
/Stepper Drivers/X0 Stepper Driver/5VOUT: C75.1, R123.1, R124.1, U14.25 (5VOUT)
/Stepper Drivers/X0_A1: C80.1, U14.34 (OA1); also elsewhere on the board
/Stepper Drivers/X0_A2: C77.1, U14.32 (OA2); also elsewhere on the board
/Stepper Drivers/X0_B1: C81.1, U14.13 (OB1); also elsewhere on the board
/Stepper Drivers/X0_B2: C78.1, U14.15 (OB2); also elsewhere on the board
/Stepper Drivers/X0_MISO: U14.5 (SDO_CFG0); also elsewhere on the board
/Stepper Drivers/Y_MISO: U14.4 (SDI_CFG1); also elsewhere on the board
/Stepper Drivers/~X0_EN: U14.22 (DRV_ENN_CFG6); also elsewhere on the board
/X2_ENDSTOP: R121.2, U14.21 (DIAG1); also elsewhere on the board
/X_DIR: U14.7 (DIR); also elsewhere on the board
/X_FAULT: R122.2, U14.20 (DIAG0); also elsewhere on the board
/X_STEP: U14.6 (STEP); also elsewhere on the board
CGND: C72.2, C73.2, C74.1, C75.2, C77.2, C78.2, C80.2, C81.2, C82.2, C83.2, C84.2, C85.2, C86.2, C87.2, R125.1, R126.1, R127.1, U14.1 (CLK), U14.11 (NC), U14.12 (GNDP), U14.18 (DCEN_CFG4), U14.24 (GNDA), U14.35 (GNDP), U14.36 (TST_MODE), U14.37 (PAD_GNDD); also elsewhere on the board
unnamed: C73.1, R123.2, U14.26 (VCC)
unnamed: C76.1, U14.28 (CPI)
unnamed: C76.2, U14.27 (CPO)
unnamed: C79.2, U14.29 (VCP)
unnamed: C84.1, R126.2, U14.14 (BRB)
unnamed: C87.1, R127.2, U14.33 (BRA)
unnamed: R124.2, R125.2, U14.23 (AIN_IREF)
VCC: C72.1, R121.1, R122.1, U14.8 (VCC_IO); also elsewhere on the board

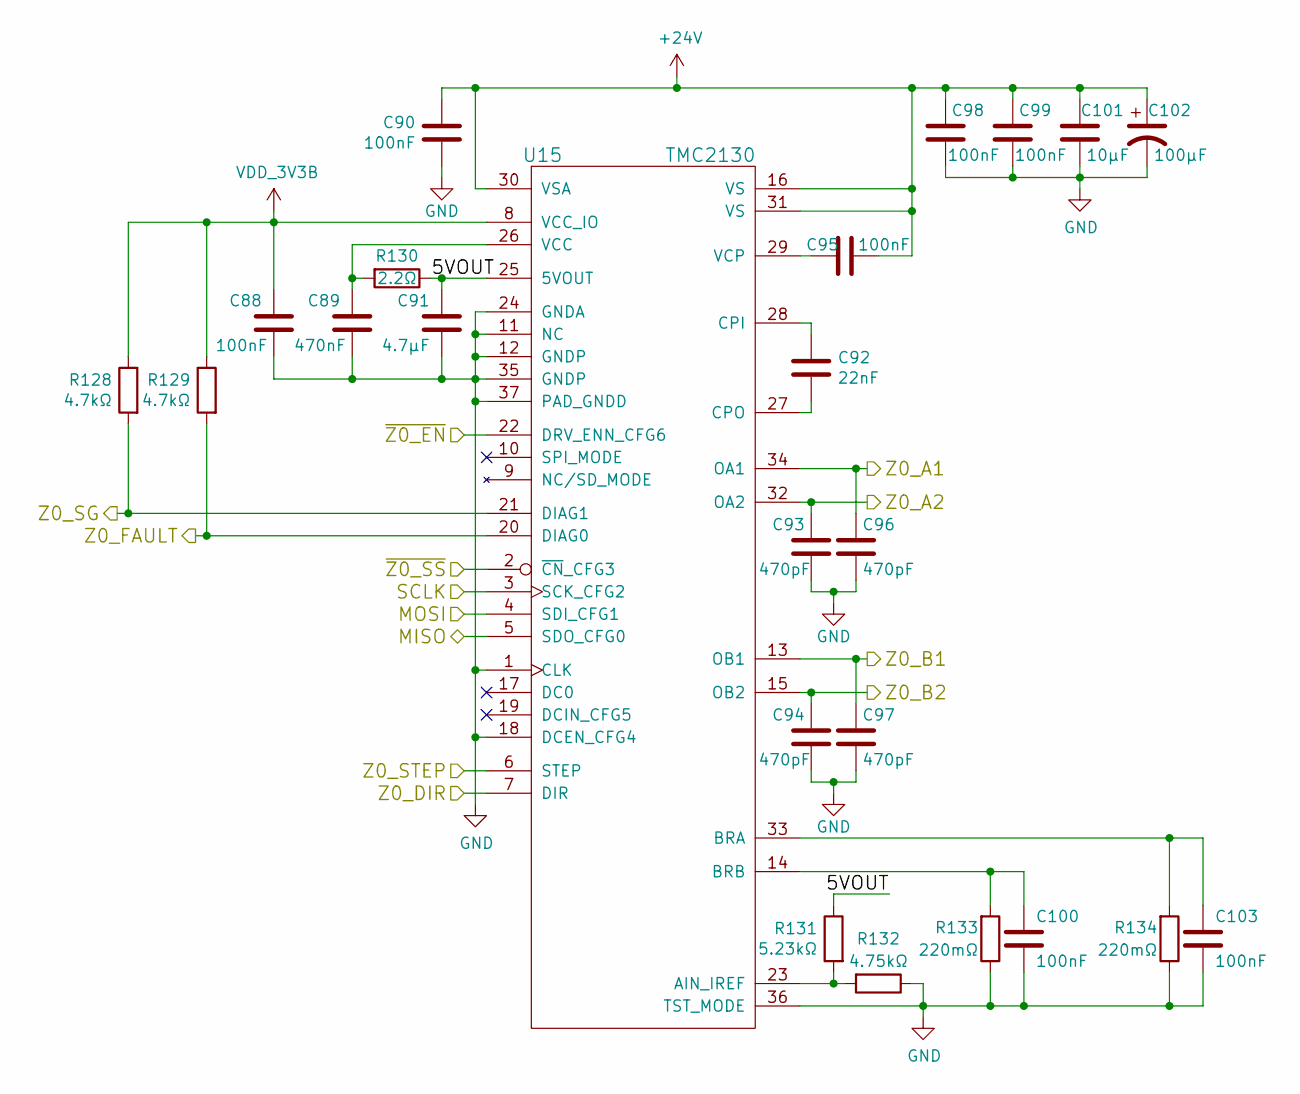
[picture p57: schematic z0_stepper.sch]

Parts:
C88, C90, C95, C98, C99, C100, C103: 100nF; C_0603
C89: 470nF; C_0603
C91: 4.7μF; C_0603
C92: 22nF; C_0603
C93, C94, C96, C97: 470pF; C_0603
C101: 10μF; C_0805
C102: 100μF; c_elec_8x10
R128, R129: 4.7kΩ; R_0603
R130: 2.2Ω; R_0603
R131: 5.23kΩ; R_0603
R132: 4.75kΩ; R_0603
R133, R134: 220mΩ; R_0805
U15: TMC2130; QFN36_5X6

Connections:
+24V: C90.2, C95.1, C98.1, C99.1, C101.1, C102.1, U15.16 (VS), U15.30 (VSA), U15.31 (VS); also elsewhere on the board
/SPI1_CS1: U15.2 (~CN~_CFG3); also elsewhere on the board
/SPI1_SCLK: U15.3 (SCK_CFG2); also elsewhere on the board
/Stepper Drivers/X1_MISO: U15.4 (SDI_CFG1); also elsewhere on the board
/Stepper Drivers/Z0 Stepper Driver/5VOUT: C91.1, R130.1, R131.1, U15.25 (5VOUT)
/Stepper Drivers/Z0_A1: C96.1, U15.34 (OA1); also elsewhere on the board
/Stepper Drivers/Z0_A2: C93.1, U15.32 (OA2); also elsewhere on the board
/Stepper Drivers/Z0_B1: C97.1, U15.13 (OB1); also elsewhere on the board
/Stepper Drivers/Z0_B2: C94.1, U15.15 (OB2); also elsewhere on the board
/Stepper Drivers/Z0_MISO: U15.5 (SDO_CFG0); also elsewhere on the board
/Stepper Drivers/~Z0_EN: U15.22 (DRV_ENN_CFG6); also elsewhere on the board
/Z2_ENDSTOP: R128.2, U15.21 (DIAG1); also elsewhere on the board
/Z_DIR: U15.7 (DIR); also elsewhere on the board
/Z_FAULT: R129.2, U15.20 (DIAG0); also elsewhere on the board
/Z_STEP: U15.6 (STEP); also elsewhere on the board
CGND: C88.2, C89.2, C90.1, C91.2, C93.2, C94.2, C96.2, C97.2, C98.2, C99.2, C100.2, C101.2, C102.2, C103.2, R132.1, R133.1, R134.1, U15.1 (CLK), U15.11 (NC), U15.12 (GNDP), U15.18 (DCEN_CFG4), U15.24 (GNDA), U15.35 (GNDP), U15.36 (TST_MODE), U15.37 (PAD_GNDD); also elsewhere on the board
unnamed: C89.1, R130.2, U15.26 (VCC)
unnamed: C92.1, U15.28 (CPI)
unnamed: C92.2, U15.27 (CPO)
unnamed: C95.2, U15.29 (VCP)
unnamed: C100.1, R133.2, U15.14 (BRB)
unnamed: C103.1, R134.2, U15.33 (BRA)
unnamed: R131.2, R132.2, U15.23 (AIN_IREF)
VCC: C88.1, R128.1, R129.1, U15.8 (VCC_IO); also elsewhere on the board
