gralco/cimarron/KiMBo/KiMBo.kicad_pcb

## KiCad design KiMBo/KiMBo.kicad_pcb (continued)

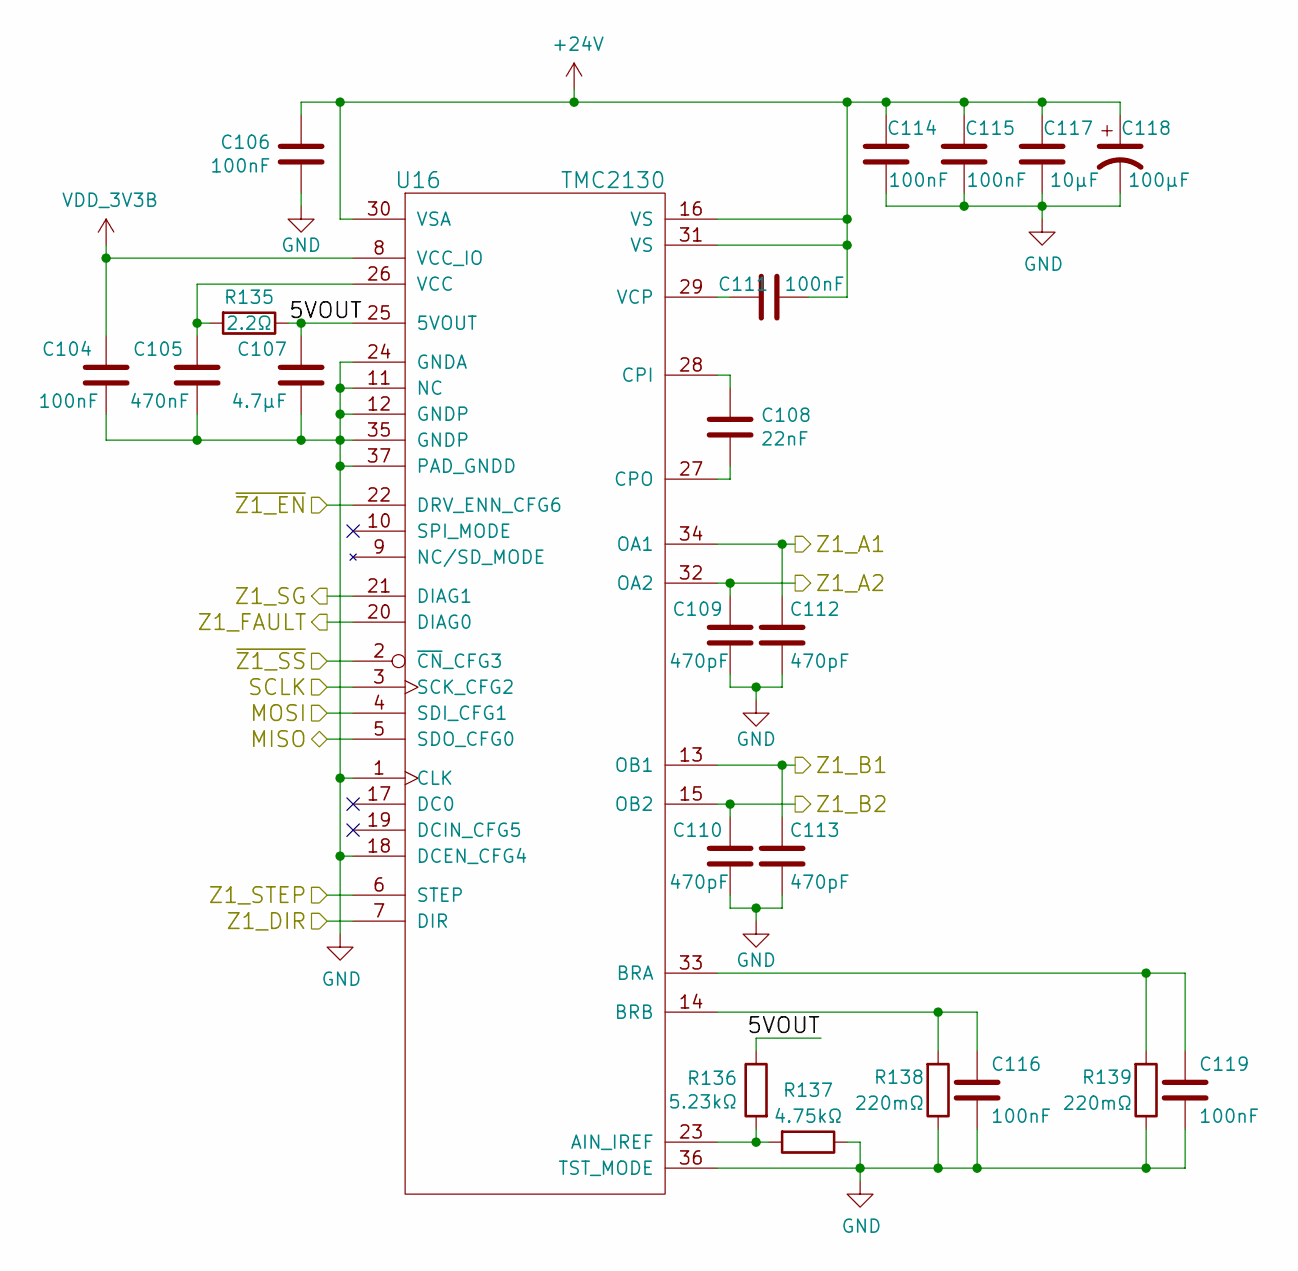
[picture p58: schematic z1_stepper.sch]

Parts:
C104, C106, C111, C114, C115, C116, C119: 100nF; C_0603
C105: 470nF; C_0603
C107: 4.7μF; C_0603
C108: 22nF; C_0603
C109, C110, C112, C113: 470pF; C_0603
C117: 10μF; C_0805
C118: 100μF; c_elec_8x10
R135: 2.2Ω; R_0603
R136: 5.23kΩ; R_0603
R137: 4.75kΩ; R_0603
R138, R139: 220mΩ; R_0805
U16: TMC2130; QFN36_5X6

Connections:
+24V: C106.2, C111.1, C114.1, C115.1, C117.1, C118.1, U16.16 (VS), U16.30 (VSA), U16.31 (VS); also elsewhere on the board
/SPI1_CS1: U16.2 (~CN~_CFG3); also elsewhere on the board
/SPI1_SCLK: U16.3 (SCK_CFG2); also elsewhere on the board
/Stepper Drivers/Z0_MISO: U16.4 (SDI_CFG1); also elsewhere on the board
/Stepper Drivers/Z1 Stepper Driver/5VOUT: C107.1, R135.1, R136.1, U16.25 (5VOUT)
/Stepper Drivers/Z1_A1: C112.1, U16.34 (OA1); also elsewhere on the board
/Stepper Drivers/Z1_A2: C109.1, U16.32 (OA2); also elsewhere on the board
/Stepper Drivers/Z1_B1: C113.1, U16.13 (OB1); also elsewhere on the board
/Stepper Drivers/Z1_B2: C110.1, U16.15 (OB2); also elsewhere on the board
/Stepper Drivers/Z1_MISO: U16.5 (SDO_CFG0); also elsewhere on the board
/Stepper Drivers/~Z1_EN: U16.22 (DRV_ENN_CFG6); also elsewhere on the board
/Z2_ENDSTOP: U16.21 (DIAG1); also elsewhere on the board
/Z_DIR: U16.7 (DIR); also elsewhere on the board
/Z_FAULT: U16.20 (DIAG0); also elsewhere on the board
/Z_STEP: U16.6 (STEP); also elsewhere on the board
CGND: C104.2, C105.2, C106.1, C107.2, C109.2, C110.2, C112.2, C113.2, C114.2, C115.2, C116.2, C117.2, C118.2, C119.2, R137.1, R138.1, R139.1, U16.1 (CLK), U16.11 (NC), U16.12 (GNDP), U16.18 (DCEN_CFG4), U16.24 (GNDA), U16.35 (GNDP), U16.36 (TST_MODE), U16.37 (PAD_GNDD); also elsewhere on the board
unnamed: C105.1, R135.2, U16.26 (VCC)
unnamed: C108.1, U16.28 (CPI)
unnamed: C108.2, U16.27 (CPO)
unnamed: C111.2, U16.29 (VCP)
unnamed: C116.1, R138.2, U16.14 (BRB)
unnamed: C119.1, R139.2, U16.33 (BRA)
unnamed: R136.2, R137.2, U16.23 (AIN_IREF)
VCC: C104.1, U16.8 (VCC_IO); also elsewhere on the board

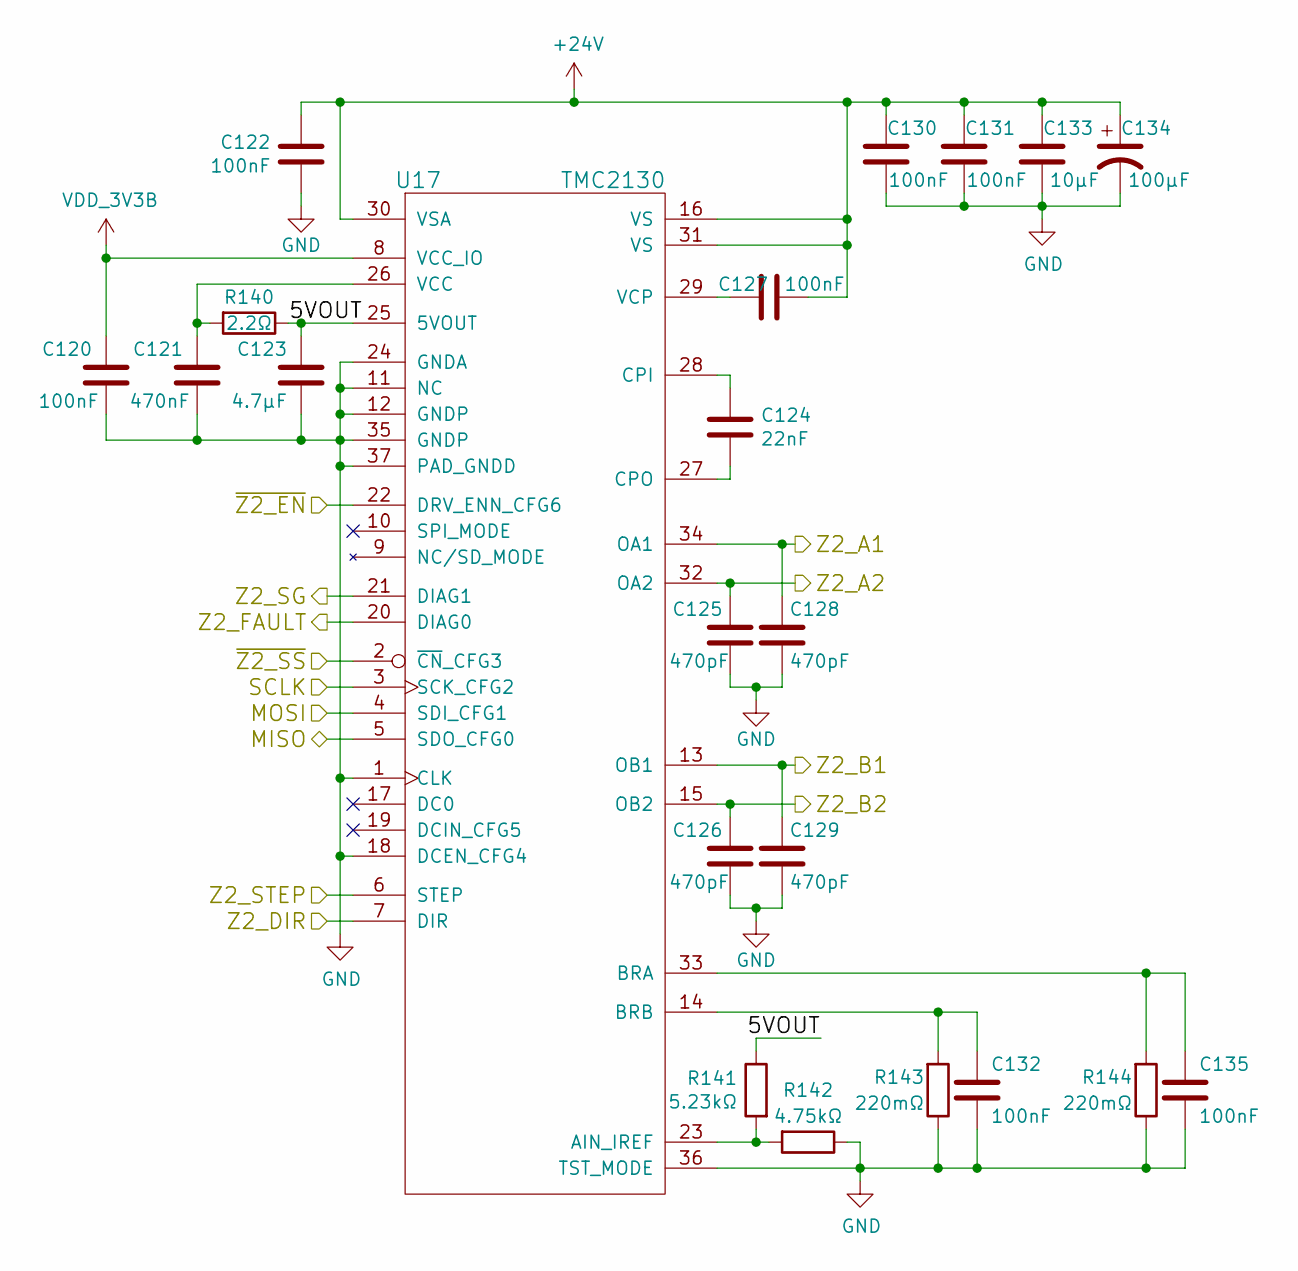
[picture p59: schematic z2_stepper.sch]

Parts:
C120, C122, C127, C130, C131, C132, C135: 100nF; C_0603
C121: 470nF; C_0603
C123: 4.7μF; C_0603
C124: 22nF; C_0603
C125, C126, C128, C129: 470pF; C_0603
C133: 10μF; C_0805
C134: 100μF; c_elec_8x10
R140: 2.2Ω; R_0603
R141: 5.23kΩ; R_0603
R142: 4.75kΩ; R_0603
R143, R144: 220mΩ; R_0805
U17: TMC2130; QFN36_5X6

Connections:
+24V: C122.2, C127.1, C130.1, C131.1, C133.1, C134.1, U17.16 (VS), U17.30 (VSA), U17.31 (VS); also elsewhere on the board
/SPI1_CS1: U17.2 (~CN~_CFG3); also elsewhere on the board
/SPI1_SCLK: U17.3 (SCK_CFG2); also elsewhere on the board
/Stepper Drivers/Z1_MISO: U17.4 (SDI_CFG1); also elsewhere on the board
/Stepper Drivers/Z2 Stepper Driver/5VOUT: C123.1, R140.1, R141.1, U17.25 (5VOUT)
/Stepper Drivers/Z2_A1: C128.1, U17.34 (OA1); also elsewhere on the board
/Stepper Drivers/Z2_A2: C125.1, U17.32 (OA2); also elsewhere on the board
/Stepper Drivers/Z2_B1: C129.1, U17.13 (OB1); also elsewhere on the board
/Stepper Drivers/Z2_B2: C126.1, U17.15 (OB2); also elsewhere on the board
/Stepper Drivers/Z2_MISO: U17.5 (SDO_CFG0); also elsewhere on the board
/Stepper Drivers/~Z2_EN: U17.22 (DRV_ENN_CFG6); also elsewhere on the board
/Z2_ENDSTOP: U17.21 (DIAG1); also elsewhere on the board
/Z_DIR: U17.7 (DIR); also elsewhere on the board
/Z_FAULT: U17.20 (DIAG0); also elsewhere on the board
/Z_STEP: U17.6 (STEP); also elsewhere on the board
CGND: C120.2, C121.2, C122.1, C123.2, C125.2, C126.2, C128.2, C129.2, C130.2, C131.2, C132.2, C133.2, C134.2, C135.2, R142.1, R143.1, R144.1, U17.1 (CLK), U17.11 (NC), U17.12 (GNDP), U17.18 (DCEN_CFG4), U17.24 (GNDA), U17.35 (GNDP), U17.36 (TST_MODE), U17.37 (PAD_GNDD); also elsewhere on the board
unnamed: C121.1, R140.2, U17.26 (VCC)
unnamed: C124.1, U17.28 (CPI)
unnamed: C124.2, U17.27 (CPO)
unnamed: C127.2, U17.29 (VCP)
unnamed: C132.1, R143.2, U17.14 (BRB)
unnamed: C135.1, R144.2, U17.33 (BRA)
unnamed: R141.2, R142.2, U17.23 (AIN_IREF)
VCC: C120.1, U17.8 (VCC_IO); also elsewhere on the board

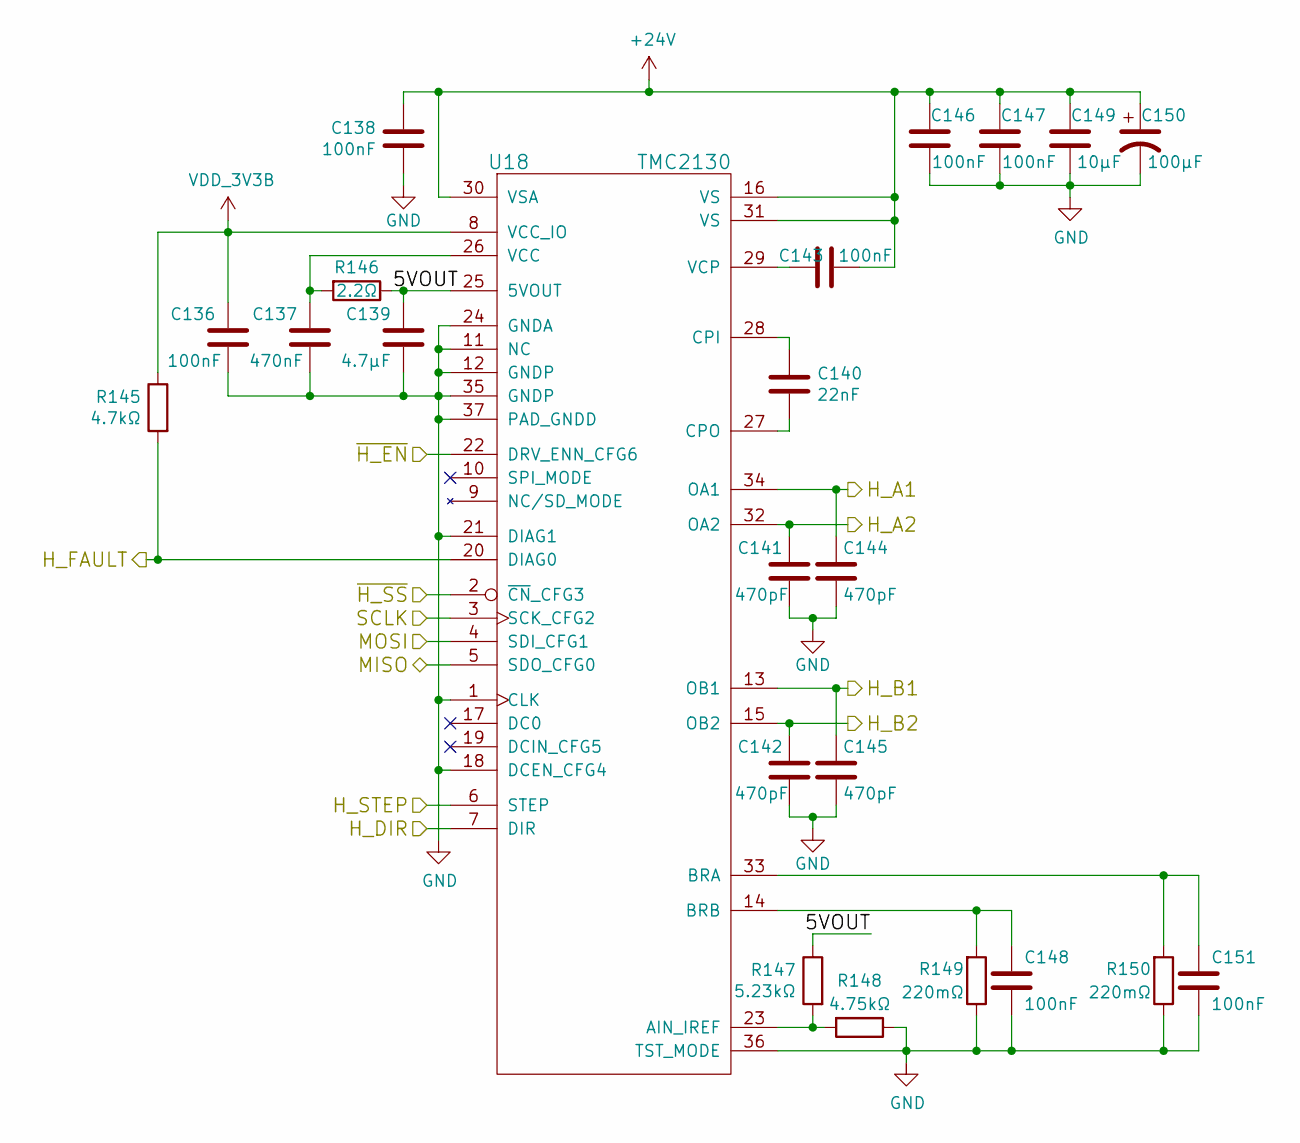
[picture p60: schematic h_stepper.sch]

Parts:
C136, C138, C143, C146, C147, C148, C151: 100nF; C_0603
C137: 470nF; C_0603
C139: 4.7μF; C_0603
C140: 22nF; C_0603
C141, C142, C144, C145: 470pF; C_0603
C149: 10μF; C_0805
C150: 100μF; c_elec_8x10
R145: 4.7kΩ; R_0603
R146: 2.2Ω; R_0603
R147: 5.23kΩ; R_0603
R148: 4.75kΩ; R_0603
R149, R150: 220mΩ; R_0805
U18: TMC2130; QFN36_5X6

Connections:
+24V: C138.2, C143.1, C146.1, C147.1, C149.1, C150.1, U18.16 (VS), U18.30 (VSA), U18.31 (VS); also elsewhere on the board
/H_DIR: U18.7 (DIR); also elsewhere on the board
/H_FAULT: R145.2, U18.20 (DIAG0); also elsewhere on the board
/H_STEP: U18.6 (STEP); also elsewhere on the board
/SPI1_CS1: U18.2 (~CN~_CFG3); also elsewhere on the board
/SPI1_MISO: U18.5 (SDO_CFG0); also elsewhere on the board
/SPI1_SCLK: U18.3 (SCK_CFG2); also elsewhere on the board
/Stepper Drivers/E_MISO: U18.4 (SDI_CFG1); also elsewhere on the board
/Stepper Drivers/H Stepper Driver/5VOUT: C139.1, R146.1, R147.1, U18.25 (5VOUT)
/Stepper Drivers/H_A1: C144.1, U18.34 (OA1); also elsewhere on the board
/Stepper Drivers/H_A2: C141.1, U18.32 (OA2); also elsewhere on the board
/Stepper Drivers/H_B1: C145.1, U18.13 (OB1); also elsewhere on the board
/Stepper Drivers/H_B2: C142.1, U18.15 (OB2); also elsewhere on the board
/Stepper Drivers/~H_EN: U18.22 (DRV_ENN_CFG6); also elsewhere on the board
CGND: C136.2, C137.2, C138.1, C139.2, C141.2, C142.2, C144.2, C145.2, C146.2, C147.2, C148.2, C149.2, C150.2, C151.2, R148.1, R149.1, R150.1, U18.1 (CLK), U18.11 (NC), U18.12 (GNDP), U18.18 (DCEN_CFG4), U18.21 (DIAG1), U18.24 (GNDA), U18.35 (GNDP), U18.36 (TST_MODE), U18.37 (PAD_GNDD); also elsewhere on the board
unnamed: C137.1, R146.2, U18.26 (VCC)
unnamed: C140.1, U18.28 (CPI)
unnamed: C140.2, U18.27 (CPO)
unnamed: C143.2, U18.29 (VCP)
unnamed: C148.1, R149.2, U18.14 (BRB)
unnamed: C151.1, R150.2, U18.33 (BRA)
unnamed: R147.2, R148.2, U18.23 (AIN_IREF)
VCC: C136.1, R145.1, U18.8 (VCC_IO); also elsewhere on the board

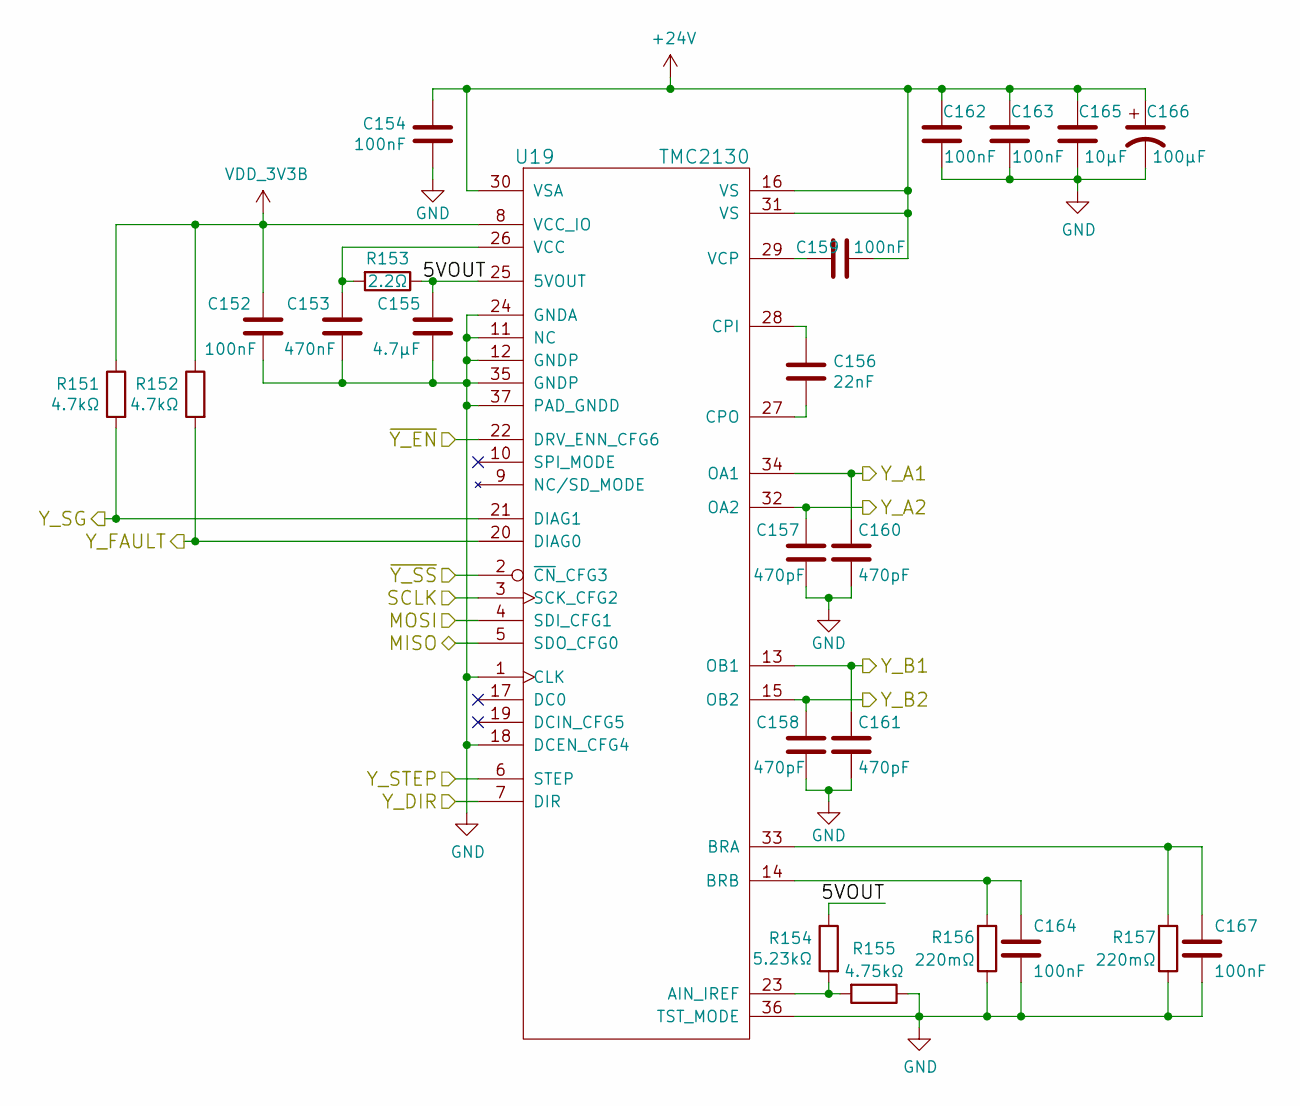
[picture p61: schematic y_stepper.sch]

Parts:
C152, C154, C159, C162, C163, C164, C167: 100nF; C_0603
C153: 470nF; C_0603
C155: 4.7μF; C_0603
C156: 22nF; C_0603
C157, C158, C160, C161: 470pF; C_0603
C165: 10μF; C_0805
C166: 100μF; c_elec_8x10
R151, R152: 4.7kΩ; R_0603
R153: 2.2Ω; R_0603
R154: 5.23kΩ; R_0603
R155: 4.75kΩ; R_0603
R156, R157: 220mΩ; R_0805
U19: TMC2130; QFN36_5X6

Connections:
+24V: C154.2, C159.1, C162.1, C163.1, C165.1, C166.1, U19.16 (VS), U19.30 (VSA), U19.31 (VS); also elsewhere on the board
/SPI1_CS1: U19.2 (~CN~_CFG3); also elsewhere on the board
/SPI1_MOSI: U19.4 (SDI_CFG1); also elsewhere on the board
/SPI1_SCLK: U19.3 (SCK_CFG2); also elsewhere on the board
/Stepper Drivers/Y Stepper Driver/5VOUT: C155.1, R153.1, R154.1, U19.25 (5VOUT)
/Stepper Drivers/Y_A1: C160.1, U19.34 (OA1); also elsewhere on the board
/Stepper Drivers/Y_A2: C157.1, U19.32 (OA2); also elsewhere on the board
/Stepper Drivers/Y_B1: C161.1, U19.13 (OB1); also elsewhere on the board
/Stepper Drivers/Y_B2: C158.1, U19.15 (OB2); also elsewhere on the board
/Stepper Drivers/Y_MISO: U19.5 (SDO_CFG0); also elsewhere on the board
/Stepper Drivers/~Y_EN: U19.22 (DRV_ENN_CFG6); also elsewhere on the board
/Y2_ENDSTOP: R151.2, U19.21 (DIAG1); also elsewhere on the board
/Y_DIR: U19.7 (DIR); also elsewhere on the board
/Y_FAULT: R152.2, U19.20 (DIAG0); also elsewhere on the board
/Y_STEP: U19.6 (STEP); also elsewhere on the board
CGND: C152.2, C153.2, C154.1, C155.2, C157.2, C158.2, C160.2, C161.2, C162.2, C163.2, C164.2, C165.2, C166.2, C167.2, R155.1, R156.1, R157.1, U19.1 (CLK), U19.11 (NC), U19.12 (GNDP), U19.18 (DCEN_CFG4), U19.24 (GNDA), U19.35 (GNDP), U19.36 (TST_MODE), U19.37 (PAD_GNDD); also elsewhere on the board
unnamed: C153.1, R153.2, U19.26 (VCC)
unnamed: C156.1, U19.28 (CPI)
unnamed: C156.2, U19.27 (CPO)
unnamed: C159.2, U19.29 (VCP)
unnamed: C164.1, R156.2, U19.14 (BRB)
unnamed: C167.1, R157.2, U19.33 (BRA)
unnamed: R154.2, R155.2, U19.23 (AIN_IREF)
VCC: C152.1, R151.1, R152.1, U19.8 (VCC_IO); also elsewhere on the board

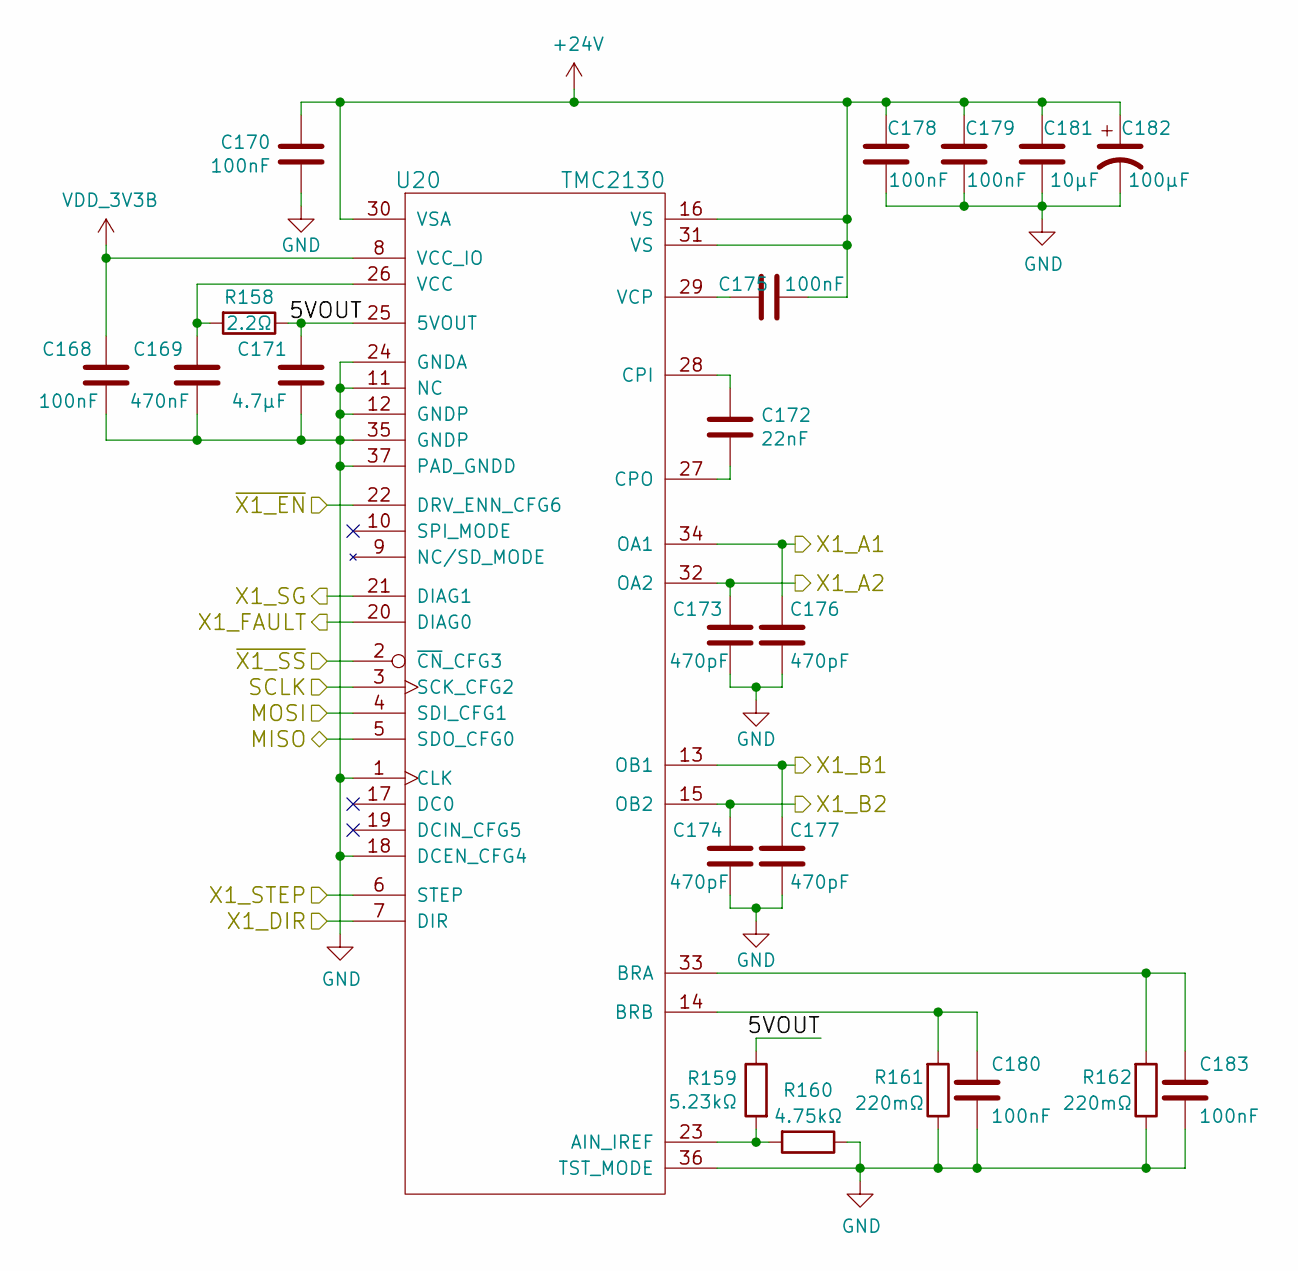
[picture p62: schematic x1_stepper.sch]

Parts:
C168, C170, C175, C178, C179, C180, C183: 100nF; C_0603
C169: 470nF; C_0603
C171: 4.7μF; C_0603
C172: 22nF; C_0603
C173, C174, C176, C177: 470pF; C_0603
C181: 10μF; C_0805
C182: 100μF; c_elec_8x10
R158: 2.2Ω; R_0603
R159: 5.23kΩ; R_0603
R160: 4.75kΩ; R_0603
R161, R162: 220mΩ; R_0805
U20: TMC2130; QFN36_5X6

Connections:
+24V: C170.2, C175.1, C178.1, C179.1, C181.1, C182.1, U20.16 (VS), U20.30 (VSA), U20.31 (VS); also elsewhere on the board
/SPI1_CS1: U20.2 (~CN~_CFG3); also elsewhere on the board
/SPI1_SCLK: U20.3 (SCK_CFG2); also elsewhere on the board
/Stepper Drivers/X0_MISO: U20.4 (SDI_CFG1); also elsewhere on the board
/Stepper Drivers/X1 Stepper Driver/5VOUT: C171.1, R158.1, R159.1, U20.25 (5VOUT)
/Stepper Drivers/X1_A1: C176.1, U20.34 (OA1); also elsewhere on the board
/Stepper Drivers/X1_A2: C173.1, U20.32 (OA2); also elsewhere on the board
/Stepper Drivers/X1_B1: C177.1, U20.13 (OB1); also elsewhere on the board
/Stepper Drivers/X1_B2: C174.1, U20.15 (OB2); also elsewhere on the board
/Stepper Drivers/X1_MISO: U20.5 (SDO_CFG0); also elsewhere on the board
/Stepper Drivers/~X1_EN: U20.22 (DRV_ENN_CFG6); also elsewhere on the board
/X2_ENDSTOP: U20.21 (DIAG1); also elsewhere on the board
/X_DIR: U20.7 (DIR); also elsewhere on the board
/X_FAULT: U20.20 (DIAG0); also elsewhere on the board
/X_STEP: U20.6 (STEP); also elsewhere on the board
CGND: C168.2, C169.2, C170.1, C171.2, C173.2, C174.2, C176.2, C177.2, C178.2, C179.2, C180.2, C181.2, C182.2, C183.2, R160.1, R161.1, R162.1, U20.1 (CLK), U20.11 (NC), U20.12 (GNDP), U20.18 (DCEN_CFG4), U20.24 (GNDA), U20.35 (GNDP), U20.36 (TST_MODE), U20.37 (PAD_GNDD); also elsewhere on the board
unnamed: C169.1, R158.2, U20.26 (VCC)
unnamed: C172.1, U20.28 (CPI)
unnamed: C172.2, U20.27 (CPO)
unnamed: C175.2, U20.29 (VCP)
unnamed: C180.1, R161.2, U20.14 (BRB)
unnamed: C183.1, R162.2, U20.33 (BRA)
unnamed: R159.2, R160.2, U20.23 (AIN_IREF)
VCC: C168.1, U20.8 (VCC_IO); also elsewhere on the board

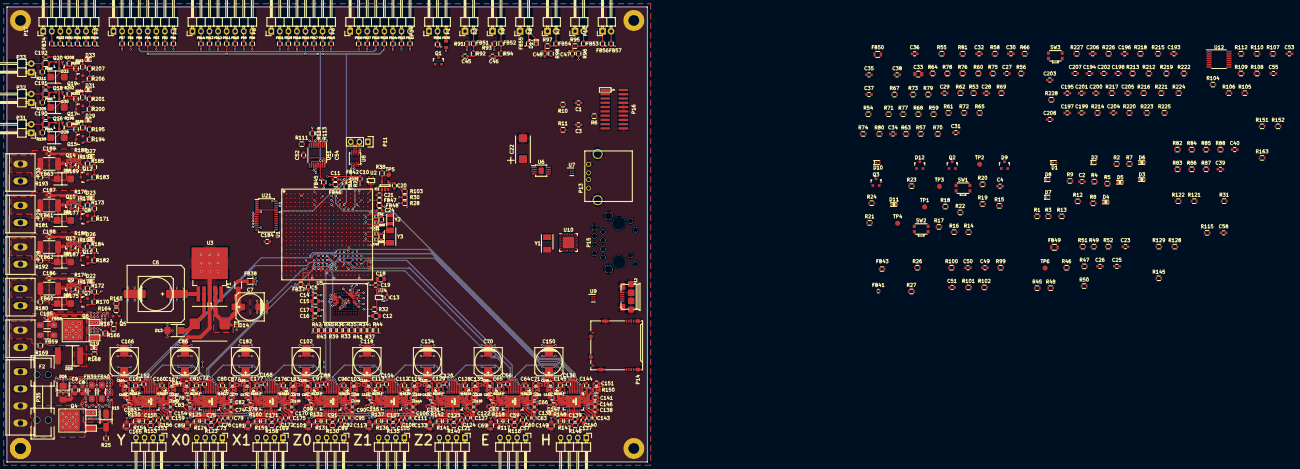
[picture p63: board KiMBo.kicad_pcb from above]

Board: 6 copper layers, 190.0 x 135.0 mm, 628 parts (0 on the bottom side), 443 nets.

Other parts of the board:
C138#2: 100nF; C_0603

Their connections:
+24V: C138#2.2; also elsewhere on the board
CGND: C138#2.1; also elsewhere on the board
