gralco/cimarron/(commit log)

2016-11-17 Update to use OSD335x as the main chipset
    [KiMBo.sch, microprocessor.sch, power.sch, rf.sch, sdram.sch, steppers.sch, usb.sch]
2016-11-21 Move various symbols, add notes, add labels
    [KiMBo.sch, microprocessor.sch, power.sch]
2016-12-08 Add comparison spreadsheet
    Contains comparison of FW, MCUs, and Wifi chips
    [comparison.ods]
2016-12-08 Update the schematic with various nets and labels
    [microprocessor.sch, power.sch]
2016-12-09 More updates to the schematics
    [microprocessor.sch, power.sch]
2017-02-02 Add eMMC to the schematic
    [KiMBo.sch, e_stepper.sch, endstops.sch, fans.sch, flash.sch, heaters.sch, input.sch, microprocessor.sch]
2017-02-02 Add 153-Pin BGA eMMC footprint
    [KiMBo.kicad_pcb, flash.sch]
2017-02-02 Update schematic module file names, add HDMI module and SD module
    [KiMBo.sch, e_stepper.sch, endstop.sch, endstops.sch, fan.sch, flash.sch, hdmi.sch, heater.sch]
2017-02-06 More progress made on the HDMI module
    [flash.sch, hdmi.sch]
2017-02-09 Use the TMC2130 stepper driver, document and calculate the stepper motor current
    The current to the motors are set by IRUN and IHOLD of the IHOLD_IRUN register
    [KiMBo.sch, config.sch, e_stepper.sch, endstop.sch, eth.sch, fan.sch, flash.sch, hdmi.sch]
2017-02-10 Update fixed reference voltage resistor values
    [e_stepper.sch]
2017-02-10 Update the stepper schematics' passive components
    [KiMBo.sch, e_stepper.sch, stepper.sch]
2017-02-14 Update the fixed Vain voltage and begin placing connectors at the highest level (root) of the hierarchical sheet structure
    [KiMBo.sch, config.sch, e_stepper.sch, eth.sch, hdmi.sch, jtag.sch, power.sch, sd.sch]
2017-02-15 Bring more interfaces out to the root sheet and begin connecting modules
    [KiMBo.sch, endstop.sch, eth.sch, flash.sch, hdmi.sch, heater.sch, jtag.sch, mpu.sch]
2017-02-16 Create nodes for more SS, add H stepper, begin fixing power rail names
    [KiMBo.sch, config.sch, e_stepper.sch, endstop.sch, eth.sch, fan.sch, flash.sch, h_stepper.sch]
2017-02-17 Update the rest of the power rails and add two more stepper drivers
    Now has *nine* stepper drivers, this will increase cost, and may drastically increase development time...
    [KiMBo.sch, config.sch, e_stepper.sch, endstop.sch, eth.sch, fan.sch, flash.sch, h_stepper.sch]
2017-02-20 Use only one driver on Y, NAND X and Z FAULT and SG signals
    Dual X carriage will need to be tested to determine if two seperate drivers are required for X
    [KiMBo.sch, config.sch, e_stepper.sch, endstop.sch, eth.sch, fan.sch, flash.sch, h_stepper.sch]
2017-02-22 Show which components are DNP, begin spec of components, and refine the power input circuit
    [KiMBo.sch, config.sch, endstop.sch, fan.sch, flash.sch, hdmi.sch, heater.sch, input.sch]
2017-02-27 Add low pass filters to the outputs going to the heaters, fans, and to the endstop inputs.
    The values of the passives need to be tweaked.
    Ferrites need to be placed in series with the output to the heaters and fans.
    [KiMBo.sch, e_stepper.sch, endstop.sch, fan.sch, heater.sch, mpu.sch, power.sch, pwm.sch]
2017-02-28 Add more low-pass filters to the outputs, add reverse polarity protection
    [KiMBo.sch, fan.sch, heater.sch, input.sch, pwm.sch]
2017-03-01 Update ferrite values, select fuse based on interrupt rating
    The PSU needs to be able to supply at LEAST 25A to blow the fuse
    [KiMBo.sch, e_stepper.sch, endstop.sch, fan.sch, h_stepper.sch, hdmi.sch, heater.sch, input.sch]
2017-03-02 Move EN and SS lines, update 5V regulator passive values
    [KiMBo.sch, config.sch, e_stepper.sch, endstop.sch, eth.sch, fan.sch, flash.sch, h_stepper.sch]
2017-03-03 Annotate all components, now passing ERC, added ferrites to the rest of the connectors
    [KiMBo.sch, config.sch, e_stepper.sch, endstop.sch, eth.sch, fan.sch, flash.sch, h_stepper.sch]
2017-03-06 Clean up various parts of the schematic, high level sheet has annoated modules
    [KiMBo.sch, config.sch, e_stepper.sch, endstop.sch, eth.sch, fan.sch, h_stepper.sch, hdmi.sch]
2017-03-07 Reorder the SS and EN lines from the shift registers such that the previously enabled/disabled motors stay enabled/disabled whilst writting to the shift register
    Change 10k resistors to 4.7k, flip the open-drain inverter connected to B15 (PMTC_PGOOD)
    Update the links in the README
    Update the PDF schematic
    [KiMBo.sch, config.sch, e_stepper.sch, endstop.sch, eth.sch, fan.sch, flash.sch, h_stepper.sch]
2017-03-09 Begin entry of component values
    [KiMBo.sch, eth.sch, flash.sch, mpu.sch, power.sch, therm.sch, usb.sch]
2017-03-10 Entry of additional component values
    [KiMBo.sch, config.sch, e_stepper.sch, endstop.sch, eth.sch, fan.sch, flash.sch, h_stepper.sch]
2017-03-13 Replace most electrolytic cap symbols symbols with the standard, non-polarized (ceramic) cap symbol
    [KiMBo.sch, flash.sch, hdmi.sch, jtag.sch, mpu.sch, power.sch, sd.sch, usb.sch]
2017-03-14 Rename connectors to their respective functionality
    [KiMBo.sch]
2017-03-17 Associate more footprints
    [KiMBo.sch, hdmi.sch, mpu.sch, power.sch, sd.sch, usb.sch]
2017-03-24 Add equivalent annotations document, associate more footprints
    [KiMBo.sch, config.sch, e_stepper.sch, endstop.sch, eth.sch, fan.sch, flash.sch, h_stepper.sch]
2017-03-28 Change the endstop RC filter
    Lower the time constant
    Reduce the series resistor to 100Ohms
    [KiMBo.sch, endstop.sch, input.sch, stepper.sch]
2017-03-29 Connect X and Z stepper driver open-drain DIAG0 and DIAG1 lines together
    [e_stepper.sch, fan.sch, h_stepper.sch, heater.sch, pwm.sch, stepper.sch, x0_stepper.sch, x1_stepper.sch]
2017-04-14 Leave SPI0 free for a display, reassign pins so SPI1 is available
    Fix some typos/errors
    [KiMBo.sch, config.sch, e_stepper.sch, endstop.sch, eth.sch, fan.sch, flash.sch, h_stepper.sch]
2017-04-18 Use fixed 5V LM2592HV Buck, include SPI0 header for LCD
    [KiMBo.sch, config.sch, e_stepper.sch, endstop.sch, eth.sch, fan.sch, flash.sch, h_stepper.sch]
2017-04-18 Assocate more footprints
    [KiMBo.sch, config.sch, e_stepper.sch, endstop.sch, eth.sch, fan.sch, flash.sch, h_stepper.sch]
2017-04-19 More footprint association
    [KiMBo.sch, config.sch, e_stepper.sch, endstop.sch, eth.sch, fan.sch, flash.sch, h_stepper.sch]
2017-04-21 Create more footprints and add more associations
    [KiMBo.sch, config.sch, eth.sch, flash.sch, hdmi.sch, input.sch, jtag.sch, mpu.sch]
2017-04-21 Add more footprints and more associations, one association left!
    [KiMBo.sch, e_stepper.sch, fan.sch, h_stepper.sch, heater.sch, power.sch, pwm.sch, stepper.sch]
2017-04-24 Complete footprint association
    Next step is layout, adjustments may need to be made to the schematic at a later point.
    [eth.sch, jtag.sch, power.sch]
2017-04-24 Fix footprints and associations before exporting/importing the netlist
    [KiMBo.sch, power.sch]
2017-04-24 Import the netlist
    [KiMBo.kicad_pcb]
2017-04-24 Begin layout
    Arrange all connectors to get a feel for the area.
    [KiMBo.kicad_pcb, KiMBo.sch, config.sch, e_stepper.sch, endstop.sch, eth.sch, fan.sch, flash.sch]
2017-04-24 Arrange connectors and E-stepper circuit
    [KiMBo.kicad_pcb, KiMBo.sch, e_stepper.sch, h_stepper.sch, x0_stepper.sch, x1_stepper.sch, y_stepper.sch, z0_stepper.sch]
2017-04-25 More progress on the stepper driver layout
    [KiMBo.kicad_pcb, stepper.sch]
2017-04-26 Tune in the stepper motor circuit, prior to removing HDMI
    [KiMBo.kicad_pcb, jtag.sch]
2017-04-26 Remove HDMI from the schematic
    [KiMBo.kicad_pcb, KiMBo.sch, e_stepper.sch, endstop.sch, eth.sch, fan.sch, flash.sch, h_stepper.sch]
2017-04-26 Read in the new netlist, HDMI removed from the layout
    [KiMBo.kicad_pcb]
2017-04-27 More stepper motor driver progress
    [KiMBo.kicad_pcb, KiMBo.sch, e_stepper.sch, endstop.sch, fan.sch, h_stepper.sch, hdmi.sch, heater.sch]
2017-04-28 Duplicate the stepper circuit, remove extra Y connector
    The Y motors will be wired in series through the motor connectors on the machine
    [KiMBo.kicad_pcb, KiMBo.sch, hdmi.sch]
2017-05-01 Change associated annotations of X0, X1, Y, and Z0 stepper circuits' components
    [KiMBo.kicad_pcb, KiMBo.sch, hdmi.sch]
2017-05-02 Complete stepper footprint association, move silkscreen, start DC fuse, polarity protection, and circuit
    [KiMBo.kicad_pcb, input.sch]
2017-05-03 Begin laying out the bed heater circuit
    [KiMBo.kicad_pcb, KiMBo.sch, fan.sch, heater.sch, input.sch, pwm.sch]
2017-05-05 Expose the pad under the tmc2130 stepper drivers
    [KiMBo.kicad_pcb]
2017-05-08 Add F1 PTC resettable fuse at the 5V output, begin E's heater circuit layout
    [KiMBo.kicad_pcb, KiMBo.sch, endstop.sch, eth.sch, fan.sch, hdmi.sch, heater.sch, input.sch]
2017-05-09 Daisy chain the SPI stepper motor driver interface, continue work on the E-heater layout
    [KiMBo.kicad_pcb, KiMBo.sch, e_stepper.sch, endstop.sch, eth.sch, fan.sch, flash.sch, h_stepper.sch]
2017-05-10 Continue buck converter layout
    [KiMBo.kicad_pcb, KiMBo.sch, e_stepper.sch, endstop.sch, eth.sch, fan.sch, flash.sch, h_stepper.sch]
2017-05-12 Route 24V to the buck, add PTC fuse to 5V output
    [KiMBo.kicad_pcb, KiMBo.sch, endstop.sch, eth.sch, fan.sch, heater.sch, input.sch, mpu.sch]
2017-05-17 Add ferrite beads to the 5V and 3V pins at the SPI connectors
    [KiMBo.kicad_pcb, KiMBo.sch, e_stepper.sch, endstop.sch, eth.sch, fan.sch, flash.sch, h_stepper.sch]
2017-05-17 Update the pdf schematic after adding additional ferrite beads
2017-05-18 Fit bottom left mounting hole, begin fan circuit layout
    [KiMBo.kicad_pcb, KiMBo.sch, input.sch]
2017-05-19 Complete the 24V fan circuit layout, beginning SPI header layout
    [KiMBo.kicad_pcb, KiMBo.sch, flash.sch]
2017-05-22 Complete SPI, ADC, and Endstop header layout/position, add zone around the SiP
    [KiMBo.kicad_pcb, KiMBo.sch, e_stepper.sch, endstop.sch, eth.sch, fan.sch, flash.sch, h_stepper.sch]
2017-05-23 Set up design rules for the eMMC chip, begin BGA placement and routing
    [KiMBo.kicad_pcb, flash.sch]
2017-05-24 Begin laying out the crystal circuit for the osd335x
    [KiMBo.kicad_pcb, jtag.sch]
2017-05-25 Remove the unneeded oscillator, track down which components are underneath the OSD3358 and put them on the top
    [KiMBo.kicad_pcb, KiMBo.sch, e_stepper.sch, endstop.sch, eth.sch, fan.sch, flash.sch, h_stepper.sch]
2017-05-26 Move ICs and connector interfaces in place, fix incorrect net for C12, and C14-C17, ready to route the eMMC traces
    [KiMBo.kicad_pcb, flash.sch, power.sch]
2017-05-31 Routing data lines between OSD335x and the eMMC chip
    [KiMBo.kicad_pcb, KiMBo.sch, e_stepper.sch, endstop.sch, eth.sch, fan.sch, flash.sch, h_stepper.sch]
2017-06-01 Complete parallel data bus routing from the eMMC to the CPU
    Center the SiP on the PCB
    Add LPFs at the I2Cs' SCL outputs
    [KiMBo.kicad_pcb, e_stepper.sch, endstop.sch, eth.sch, fan.sch, flash.sch, h_stepper.sch, hdmi.sch]
2017-06-02 Routing open-drain output inverters, SOT-5 I2C EEPROM, begin adding bypass caps around the eMMC
    [KiMBo.kicad_pcb, KiMBo.sch, e_stepper.sch, endstop.sch, eth.sch, fan.sch, flash.sch, h_stepper.sch]
2017-06-05 Route power to CPU, complete eMMC routing
    [KiMBo.kicad_pcb]
2017-06-08 Route the PCA9685 PWM lines, route more SCLK traces
    [KiMBo.kicad_pcb, flash.sch, stepper.sch]
2017-06-09 Route SCLK, MISO, and MOSI to each slave
    [KiMBo.kicad_pcb, stepper.sch]
2017-06-14 Use only one pull up resistor on the stepper motor driver DIAG pins, use the TMC2130's freewheel register functionality instead of driving the enable line via a shift register, begin routing step, di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
    [KiMBo.kicad_pcb, e_stepper.sch, fan.sch, h_stepper.sch, hdmi.sch, heater.sch, pwm.sch, stepper.sch]
2017-06-15 Route VDD_5V and VCC to printer-related headers, begin routing endstops
    [KiMBo.kicad_pcb]
2017-07-31 Update pdf of schematic
2017-07-31 Use rescued crystal and LED schematic symbols
    [KiMBo.sch, eth.sch, jtag.sch, power.sch]
